LAB5604/fpga_board/e4fpm7k325_mmb/pinout/SoMtoMB_pin.md

## 普通单端IO
|SoM pin|MB pin|
|--|--|
|gpio_g0[0]|cd_pr[0]|
|gpio_g0[1]|cd_pr[1]|
|gpio_g0[2]|cd_od[0]|
|gpio_g0[3]|cd_od[1]|
|gpio_g0[4]|cd_od[2]|
|gpio_g0[5]|cd_os[0]|
|gpio_g0[6]|cd_os[1]|
|gpio_g0[7]|adc_m[1]|
|gpio_g0[8]|sd_cd|
|gpio_g0[9]|sd_d[1]|
|gpio_g0[10]|sd_d[0]|
|gpio_g0[11]|sd_clk|
|gpio_g0[12]|sd_cmd|
|gpio_g0[13]|sd_d[3]|
|gpio_g0[14]|sd_d[2]|
|gpio_g0[15]|adc_m[0]|
|gpio_g0[16]|gpio_g0[16]|
|gpio_g0[17]|gpio_g0[15]|
|gpio_g0[18]|gpio_g0[14]|
|gpio_g0[19]|gpio_g0[13]|
|gpio_g0[20]|gpio_g0[12]|
|gpio_g0[21]|gpio_g0[11]|
|gpio_g0[22]|gpio_g0[10]|
|gpio_g0[23]|gpio_g0[9]|
|gpio_g0[24]|gpio_g1[0]|
|gpio_g0[25]|gpio_g1[1]|
|gpio_g0[26]|gpio_g1[2]|
|gpio_g0[27]|gpio_g1[3]|
|gpio_g0[28]|gpio_g1[4]|
|gpio_g0[29]|gpio_g1[5]|
|gpio_g0[30]|gpio_g1[6]|
|gpio_g0[31]|gpio_g1[7]|
|gpio_g0[32]|gpio_g0[8]|
|gpio_g0[33]|gpio_g0[7]|
|gpio_g0[34]|gpio_g0[6]|
|gpio_g0[35]|gpio_g0[5]|
|gpio_g0[36]|gpio_g0[4]|
|gpio_g0[37]|gpio_g0[3]|
|gpio_g0[38]|gpio_g0[2]|
|gpio_g0[39]|gpio_g0[1]|
|gpio_g0[40]|gpio_g0[0]|
|gpio_g0[41]|gpio_g1[16]|
|gpio_g0[42]|gpio_g1[15]|
|gpio_g0[43]|gpio_g1[14]|
|gpio_g0[44]|gpio_g1[13]|
|gpio_g0[45]|gpio_g1[12]|
|gpio_g0[46]|gpio_g1[11]|
|gpio_g0[47]|gpio_g1[10]|
|gpio_g0[48]|gpio_g1[9]|
|gpio_g0[49]|gpio_g1[8]|
|gpio_g1[0]|vga_vs|
|gpio_g1[1]|vga_hs|
|gpio_g1[2]|vga_blank|
|gpio_g1[3]|vga_psave|
|gpio_g1[4]|vga_sync|
|gpio_g1[5]|fpga_uart_txd|
|gpio_g1[6]|fpga_uart_rxd|
|gpio_g1[7]|rtc_scl|
|gpio_g1[8]|vga_r[0]|
|gpio_g1[9]|vga_r[1]|
|gpio_g1[10]|vga_r[2]|
|gpio_g1[11]|vga_r[3]|
|gpio_g1[12]|vga_r[4]|
|gpio_g1[13]|vga_r[5]|
|gpio_g1[14]|vga_r[6]|
|gpio_g1[15]|vga_r[7]|
|gpio_g1[16]|pcie_wake#|
|gpio_g1[17]|pcie_perst#|
|gpio_g1[18]|cd_rstn|
|gpio_g1[19]|rtc_sda|
|gpio_g1[20]|ps2_clk1|
|gpio_g1[21]|ps2_data1|
|gpio_g1[22]|ps2_data2|
|gpio_g1[23]|ps2_clk2|
|gpio_g1[24]|vga_g[0]|
|gpio_g1[25]|vga_g[1]|
|gpio_g1[26]|vga_g[2]|
|gpio_g1[27]|vga_g[3]|
|gpio_g1[28]|vga_g[4]|
|gpio_g1[29]|vga_g[5]|
|gpio_g1[30]|vga_g[6]|
|gpio_g1[31]|vga_g[7]|
|gpio_g1[32]|mclk_dac|
|gpio_g1[33]|sdin_dac|
|gpio_g1[34]|lrck_dac|
|gpio_g1[35]|sclk_dac|
|gpio_g1[36]|mclk_adc|
|gpio_g1[37]|sdout_adc|
|gpio_g1[38]|sclk_adc|
|gpio_g1[39]|lrck_adc|
|gpio_g1[40]|adc_rst#|
|gpio_g1[41]|vga_b[0]|
|gpio_g1[42]|vga_b[1]|
|gpio_g1[43]|vga_b[2]|
|gpio_g1[44]|vga_b[3]|
|gpio_g1[45]|vga_b[4]|
|gpio_g1[46]|vga_b[5]|
|gpio_g1[47]|vga_b[6]|
|gpio_g1[48]|vga_b[7]|
|gpio_g1[49]|vga_clk|
## SoM差分IO
|SoM pin|MB pin|
|--|--|
|gpio_diff0_p|key3|
|gpio_diff0_n|key2|
|gpio_diff1_p|key7|
|gpio_diff1_n|key6|
|gpio_diff2_p|key1|
|gpio_diff2_n|key0|
|gpio_diff3_p|key5|
|gpio_diff3_n|key4|
|gpio_diff4_p|but5|
|gpio_diff4_n|but1|
|gpio_diff5_p|but4|
|gpio_diff5_n|but0|
|gpio_diff6_p|but7|
|gpio_diff6_n|but3|
|gpio_diff7_p|but6|
|gpio_diff7_n|but2|
|gpio_diff8_p|led0|
|gpio_diff8_n|led1|
|gpio_diff9_p|led2|
|gpio_diff9_n|led3|
|gpio_diff10_p|led7|
|gpio_diff10_n|led6|
|gpio_diff11_p|led5|
|gpio_diff11_n|led4|
|gpio_diff12_p|seg_c|
|gpio_diff12_n|seg_g|
|gpio_diff13_p|seg_a|
|gpio_diff13_n|seg_f|
|gpio_diff14_p|seg_b|
|gpio_diff14_n|seg_e|
|gpio_diff15_p|seg_d|
|gpio_diff15_n|seg_dp|
|gpio_diff16_p|seg_sel4|
|gpio_diff16_n|seg_sel3|
|gpio_diff17_p|seg_sel2|
|gpio_diff17_n|seg_sel1|
## 专用IO
SoM上专用IO引脚和主板同名IO相连
## GT收发器引脚 
|SoM pin|MB pin|
|--|--|
|mgtxtx0_p|pcie_tx0_p|
|mgtxtx0_n|pcie_tx0_n|
|mgtxrx0_p|pcie_rx0_p|
|mgtxrx0_n|pcie_rx0_n|
|mgtxtx1_p|pcie_tx1_p|
|mgtxtx1_n|pcie_tx1_n|
|mgtxrx1_p|pcie_rx1_p|
|mgtxrx1_n|pcie_rx1_n|
|mgtxtx2_p|pcie_tx2_p|
|mgtxtx2_n|pcie_tx2_n|
|mgtxrx2_p|pcie_rx2_p|
|mgtxrx2_n|pcie_rx2_n|
|mgtxtx3_p|pcie_tx3_p|
|mgtxtx3_n|pcie_tx3_n|
|mgtxrx3_p|pcie_rx3_p|
|mgtxrx3_n|pcie_rx3_n|
|mgtrclk115_p|pcie_refclk_p|
|mgtrclk115_n|pcie_refclk_n|
|mgtxtx4_p|sata_tx1_p|
|mgtxtx4_n|sata_tx1_n|
|mgtxrx4_p|sata_rx1_p|
|mgtxrx4_n|sata_rx1_n|
|mgtxtx5_p|sata_tx2_p|
|mgtxtx5_n|sata_tx2_n|
|mgtxrx5_p|sata_rx2_p|
|mgtxrx5_n|sata_rx2_n|
|mgtxtx6_p|sata_tx3_p|
|mgtxtx6_n|sata_tx3_n|
|mgtxrx6_p|sata_rx3_p|
|mgtxrx6_n|sata_rx3_n|
|mgtxtx7_p|sata_tx4_p|
|mgtxtx7_n|sata_tx4_n|
|mgtxrx7_p|sata_rx4_p|
|mgtxrx7_n|sata_rx4_n|
