LAB5604/fpga_board/e4fpm7k325_mmb/docs/E4FPMK7_676_MB_Schematic_English.pdf

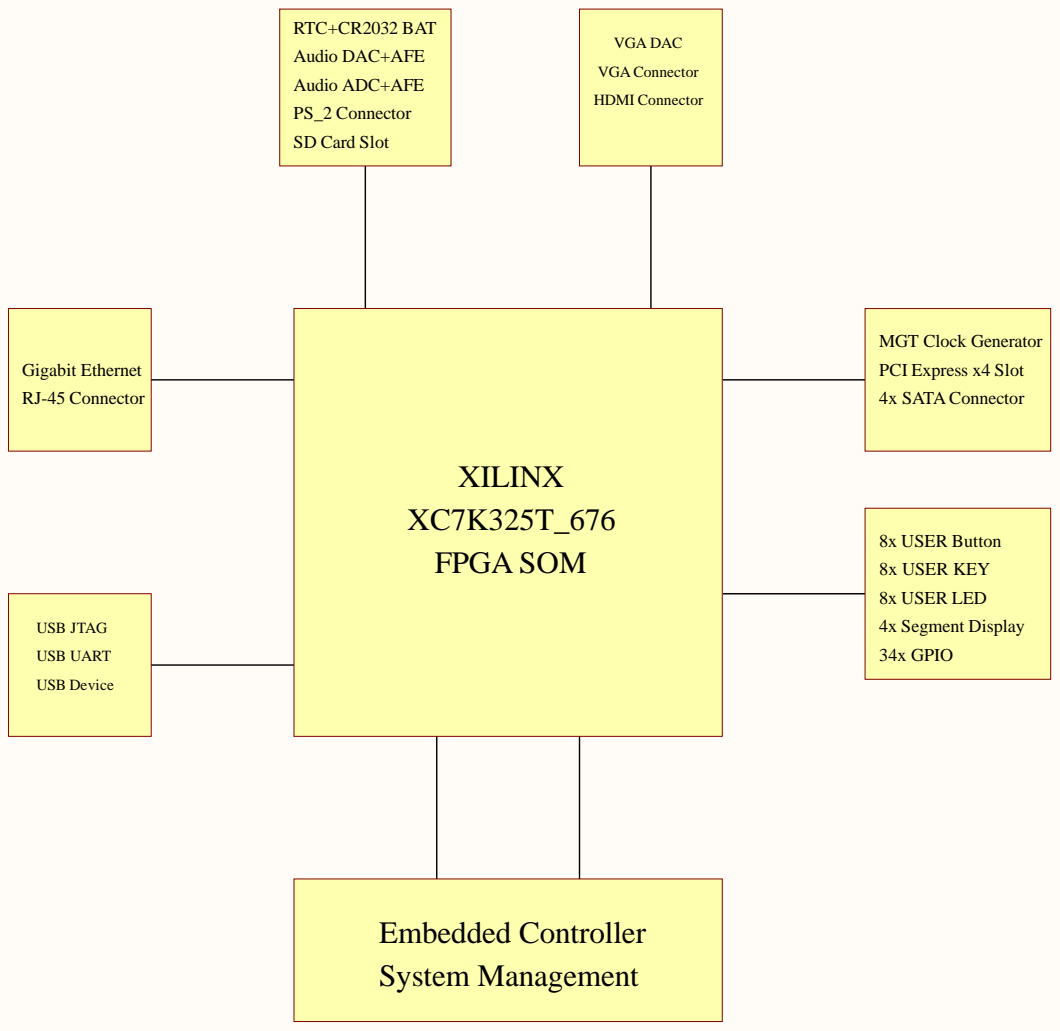
[picture p3: page 1]

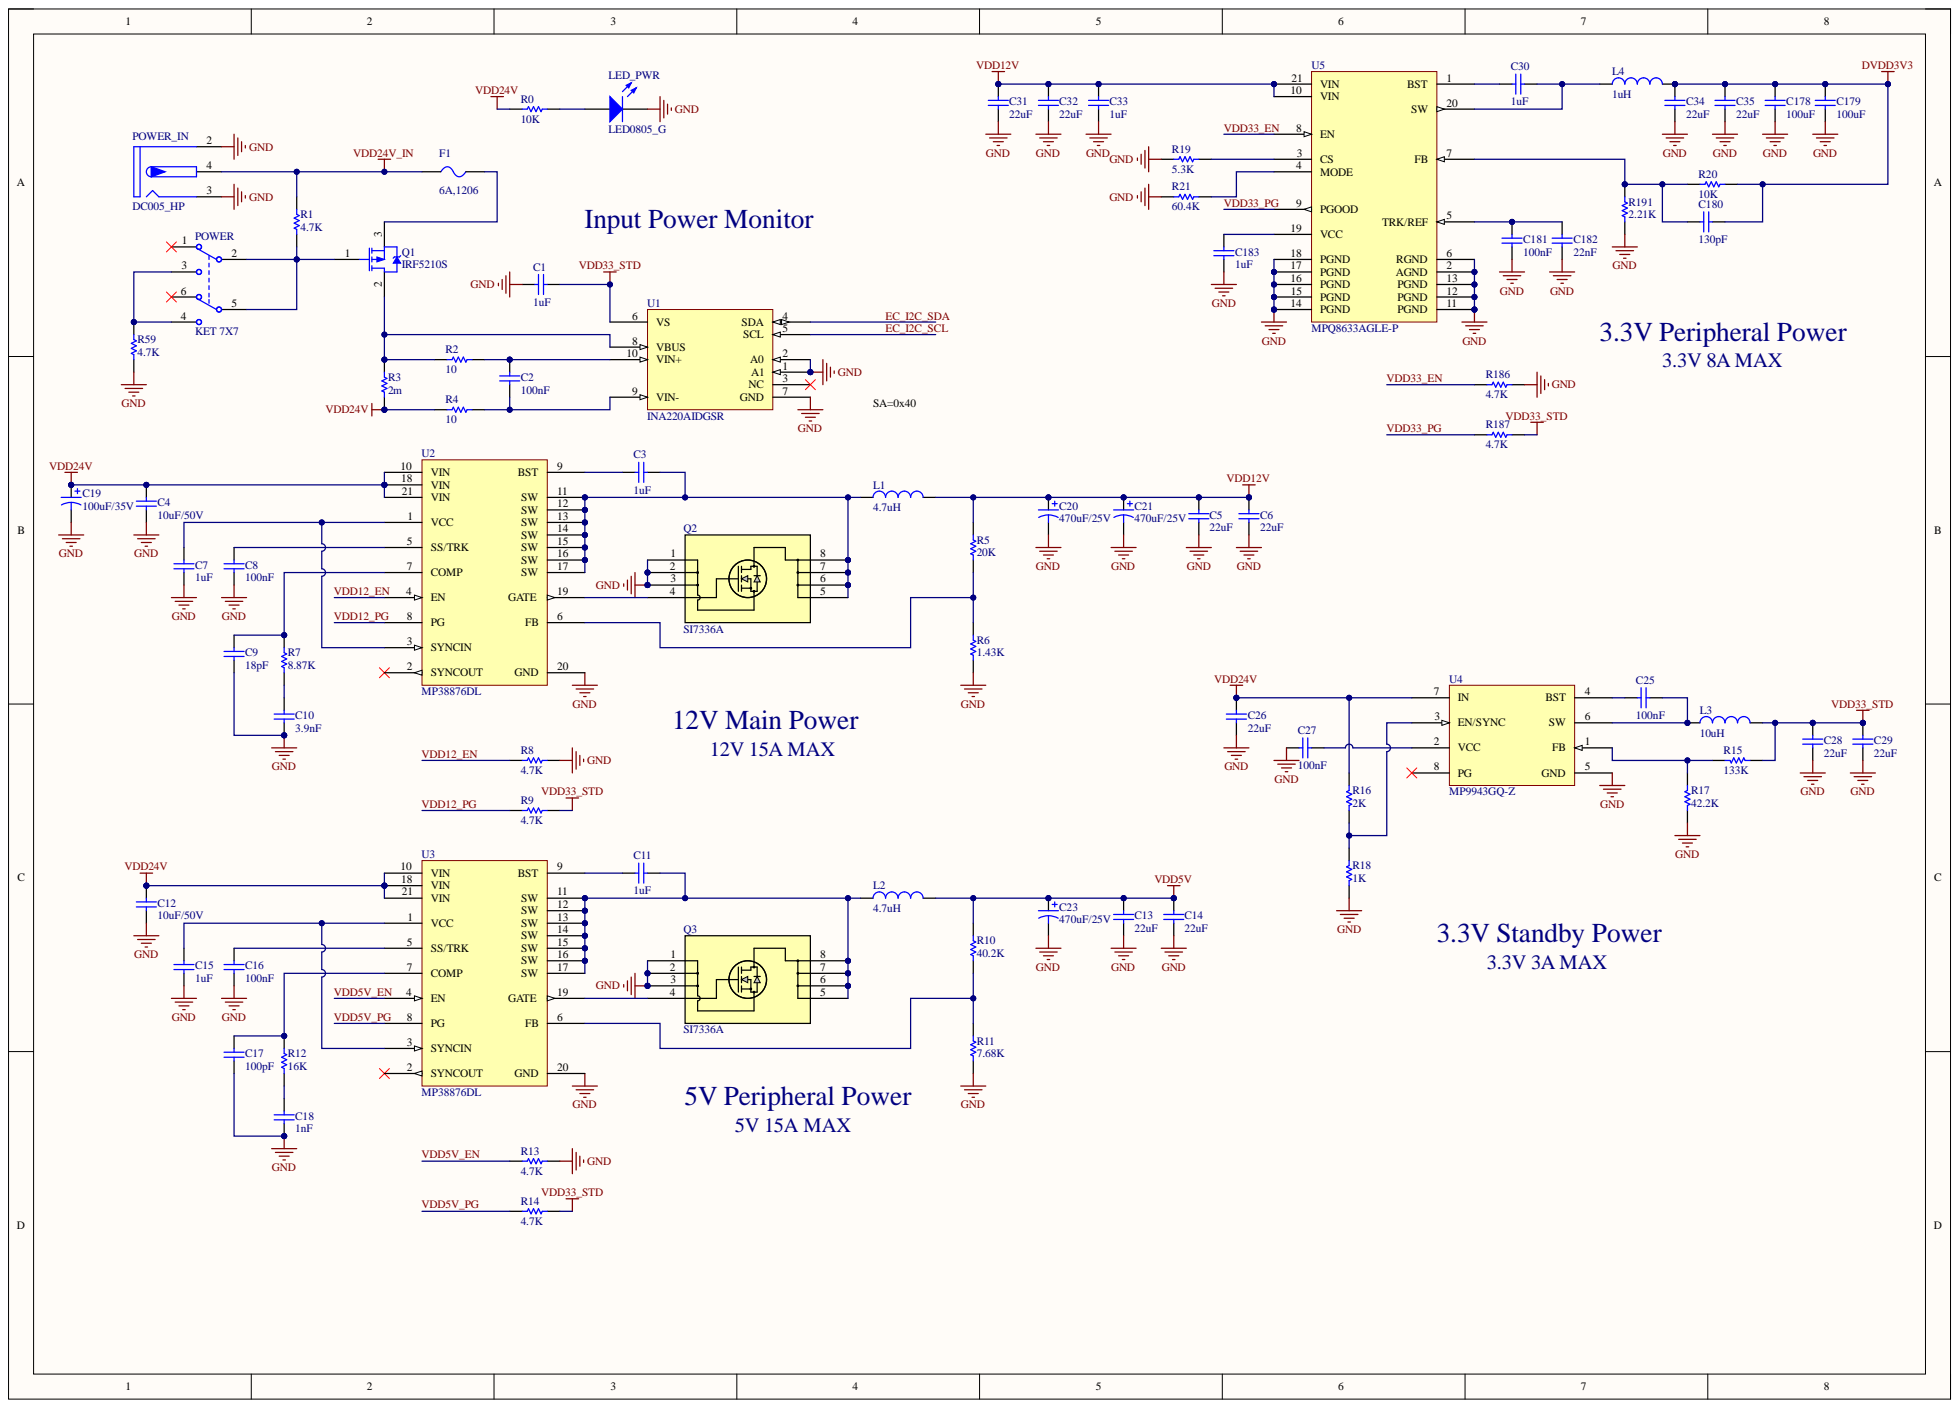
[picture p4: page 2]

MODE 4

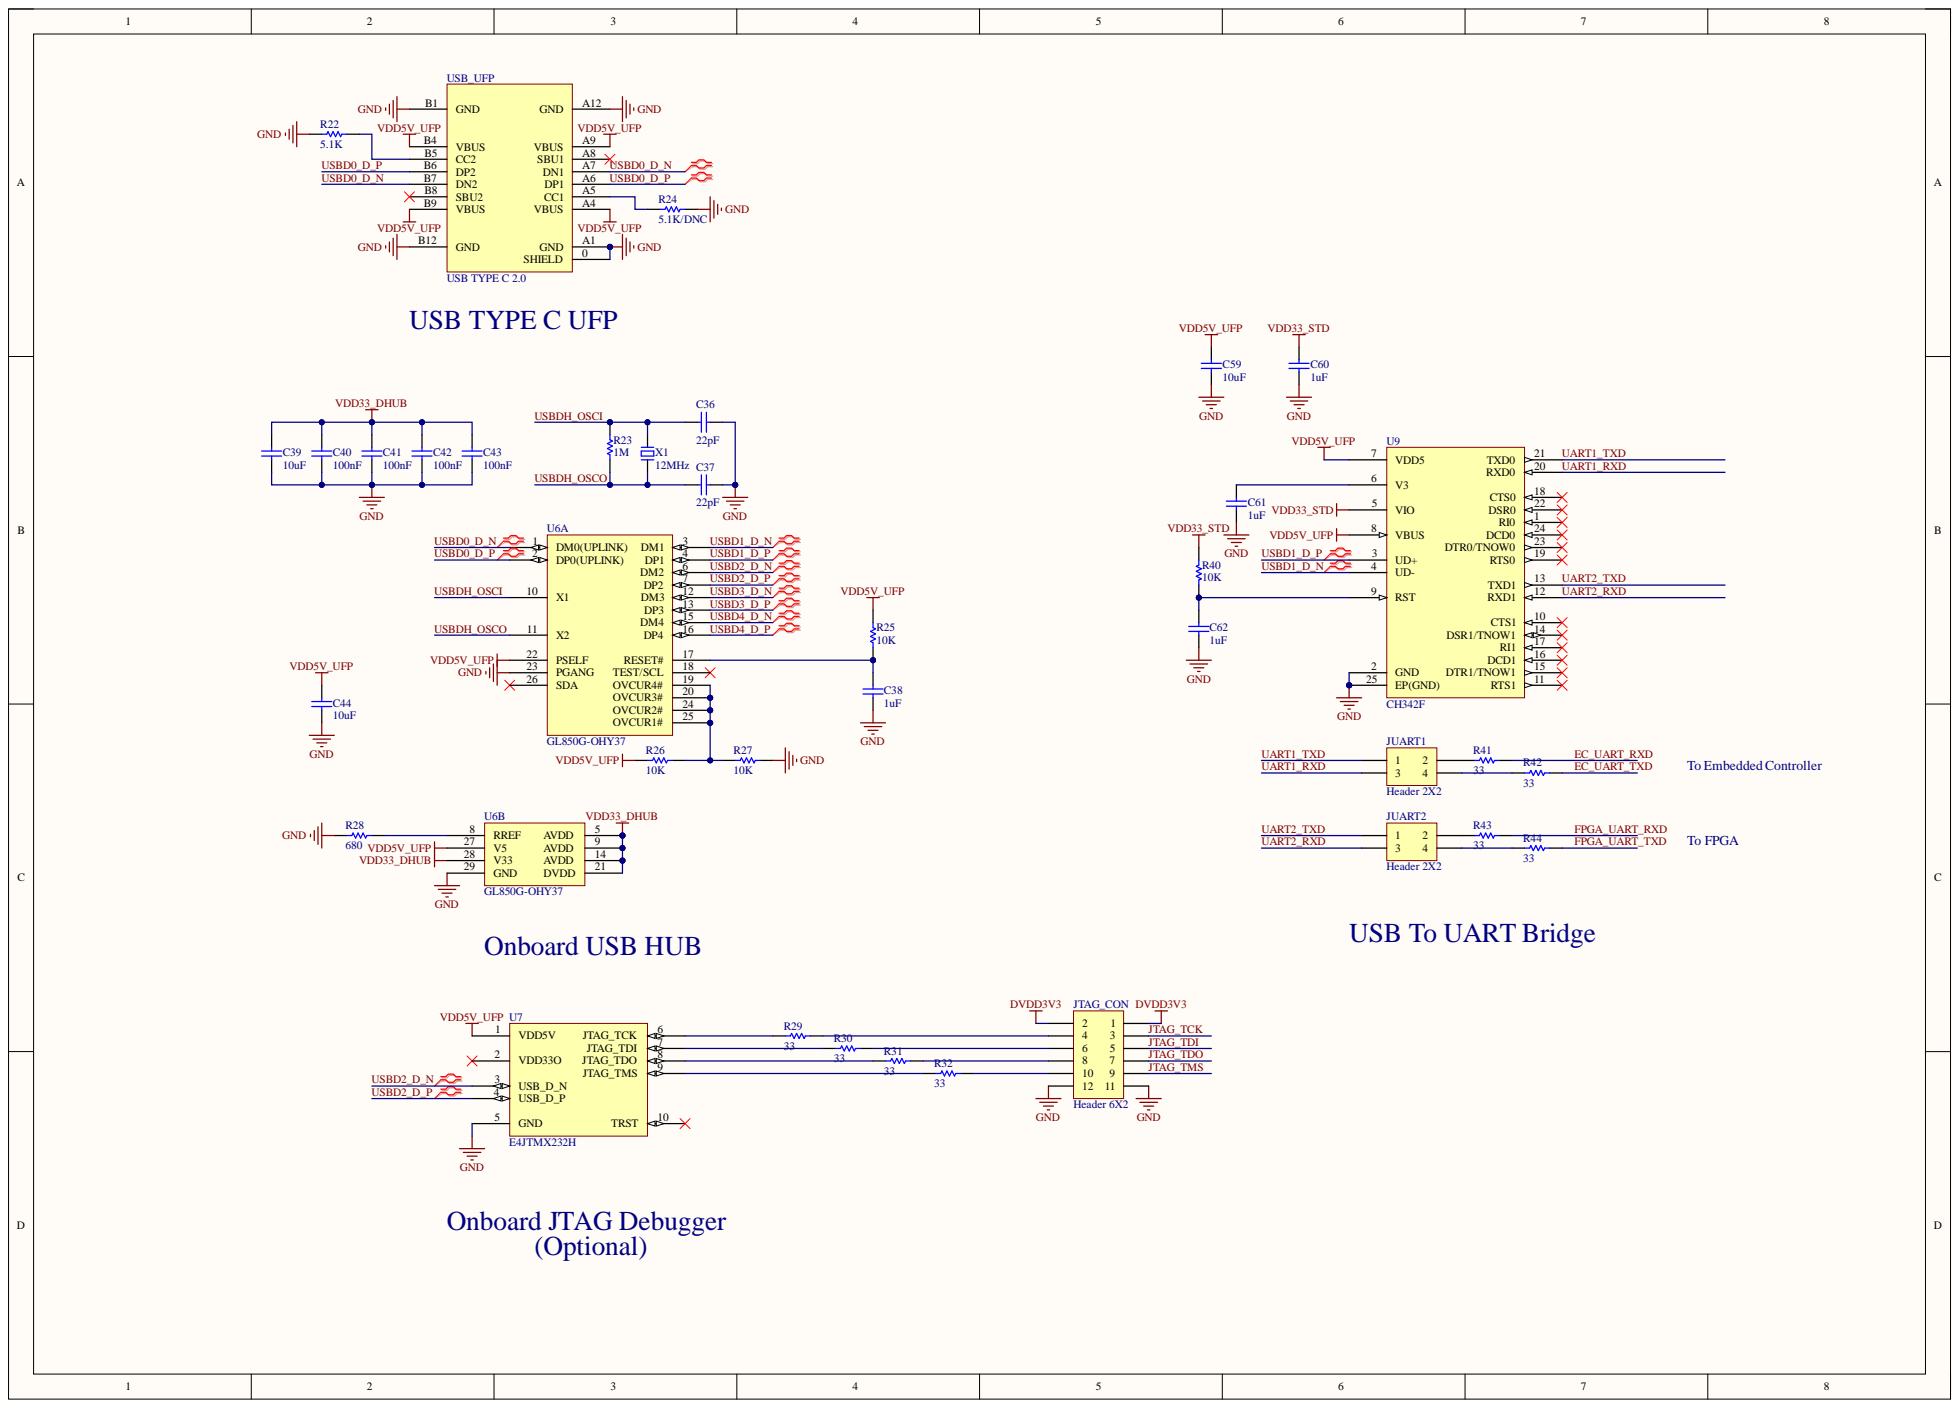
[picture p5: page 3]

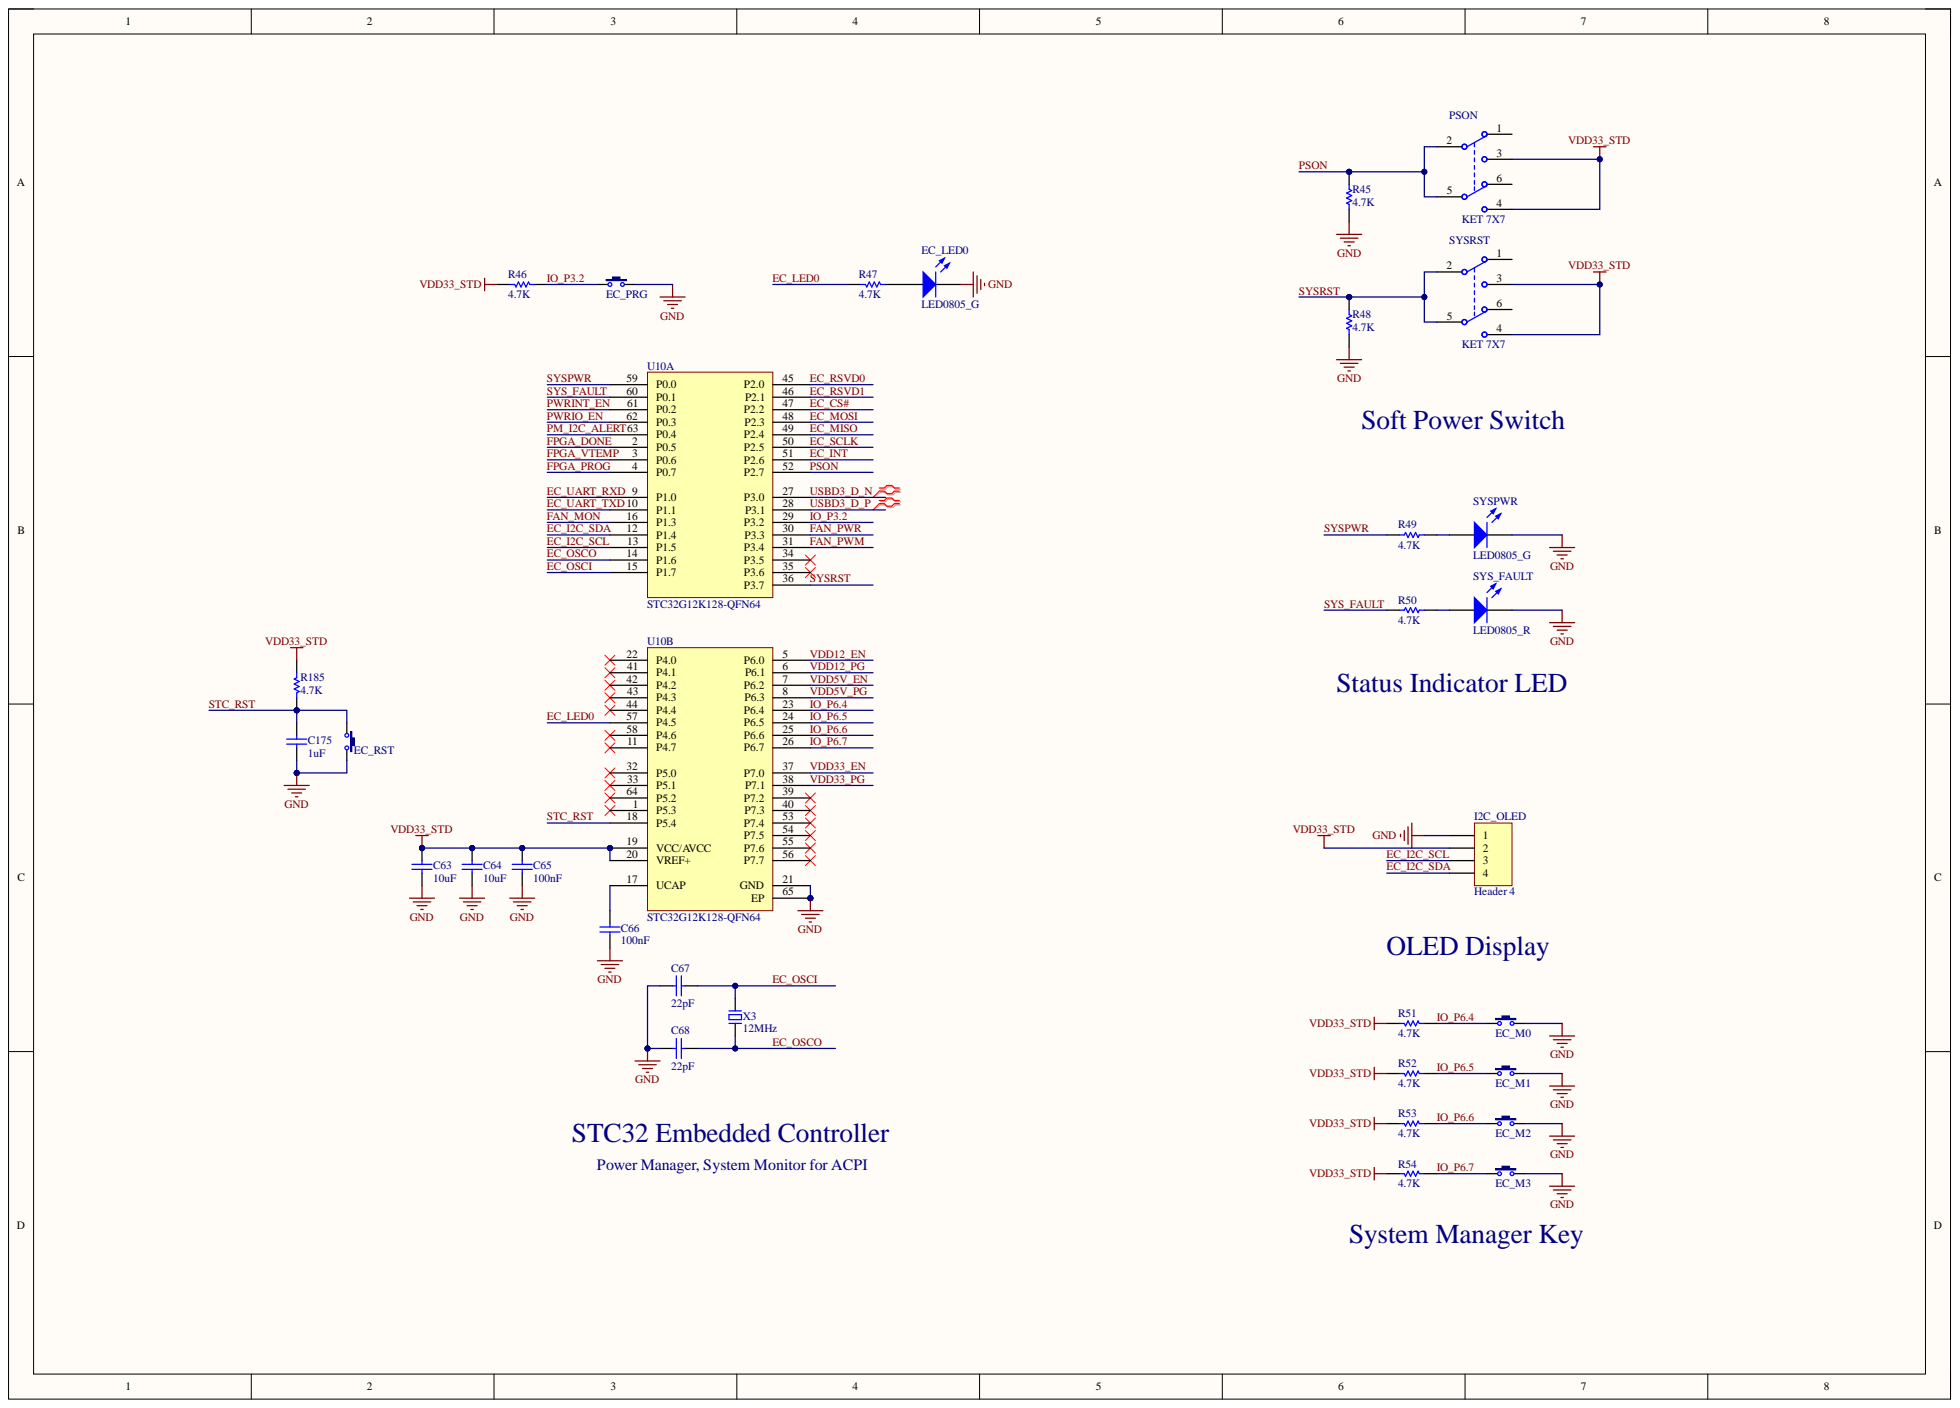
[picture p6: page 4]

STC32 Embedded Controller Power Manager, System Monitor for ACPI

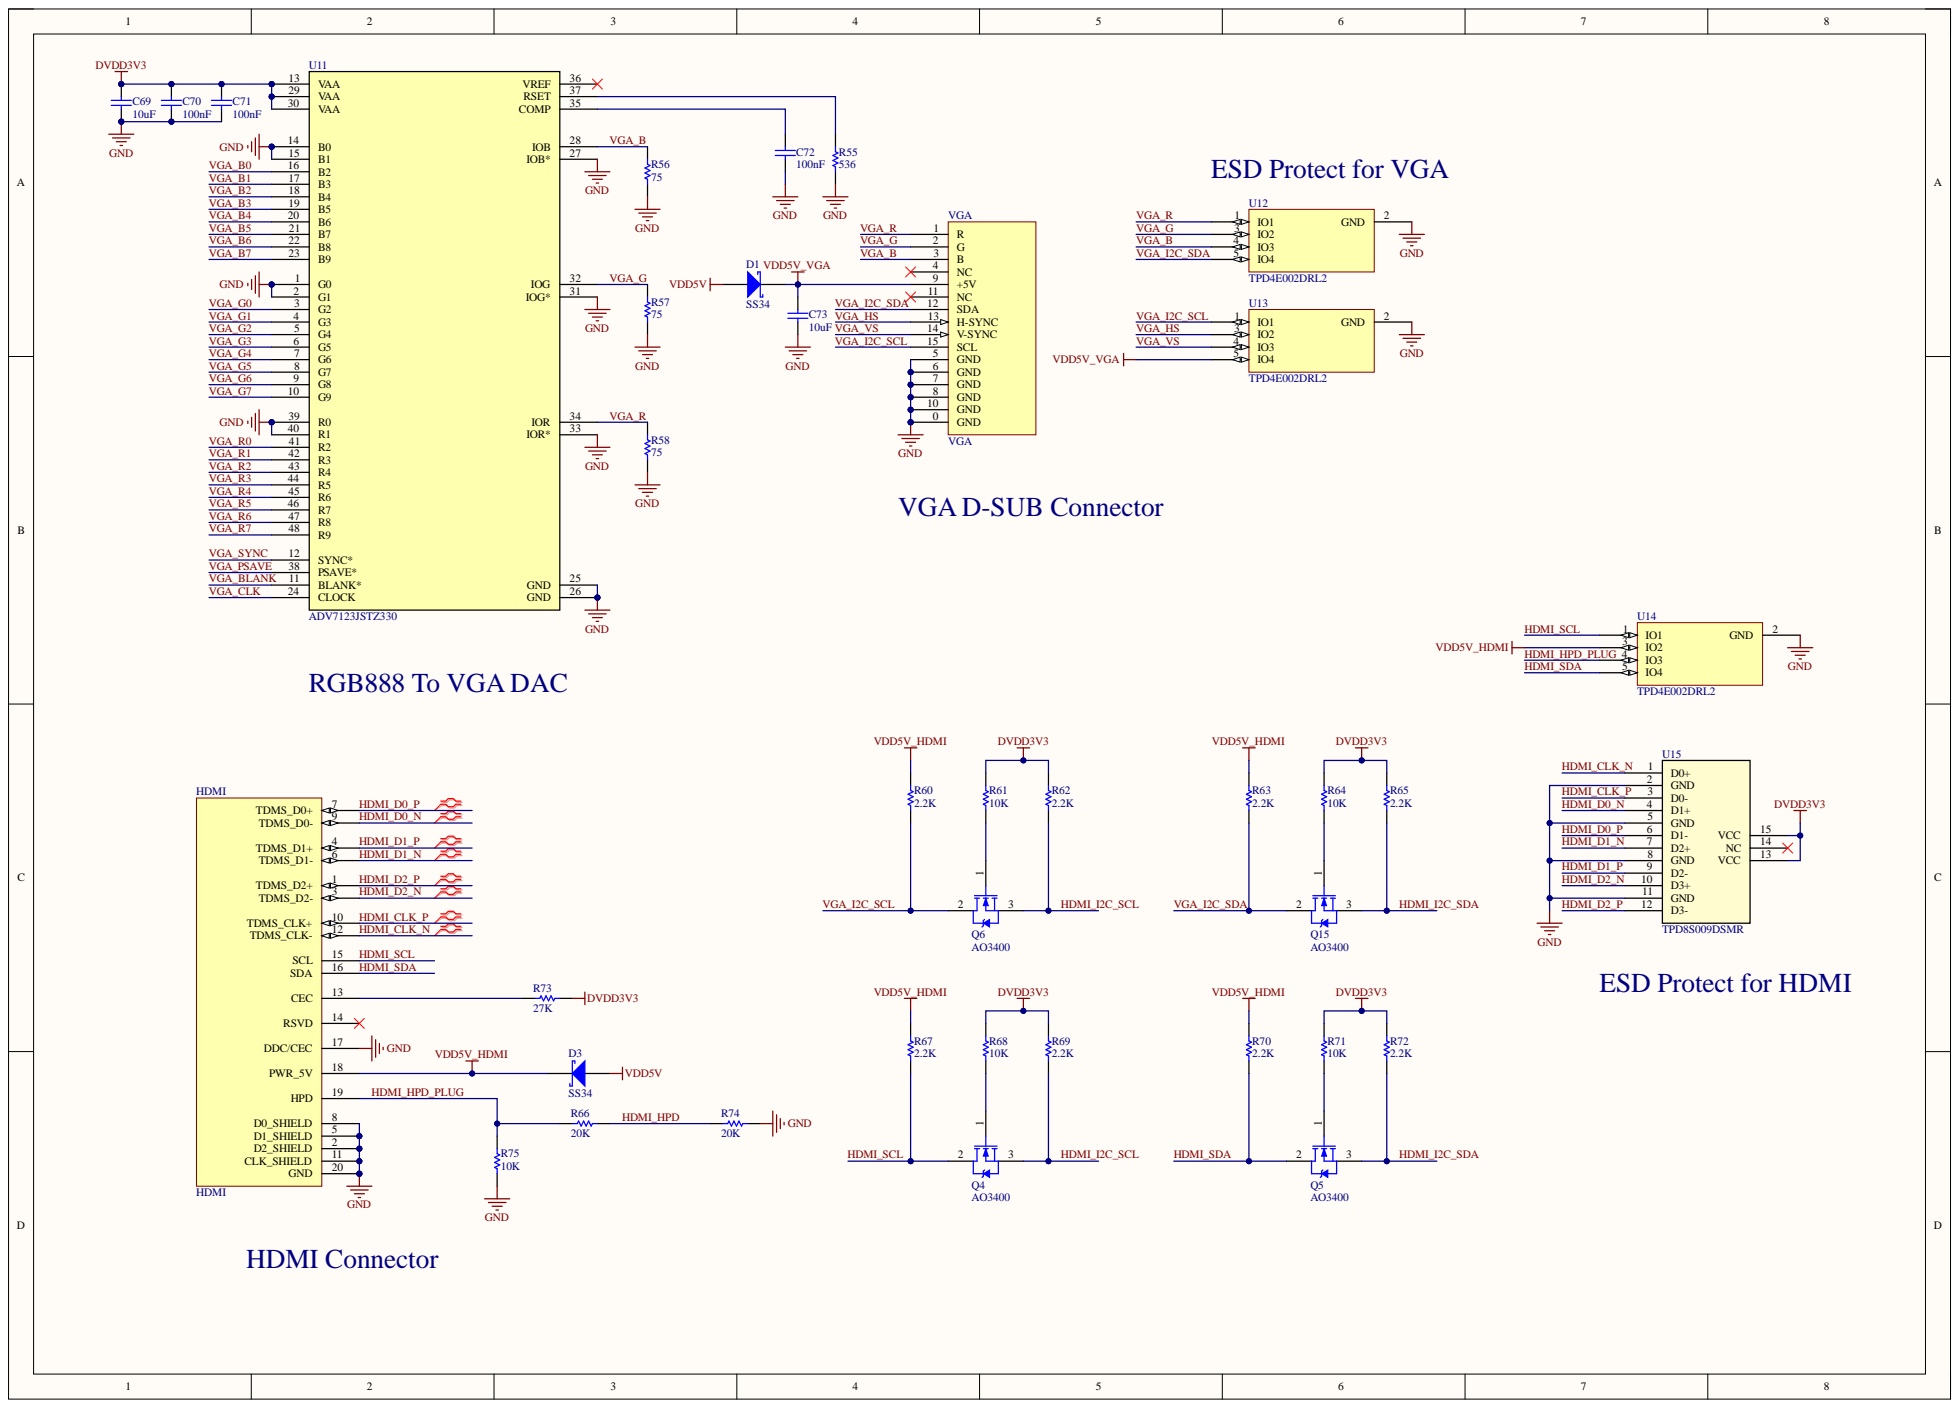
[picture p7: page 5]

ESD Protect for VGA

GND
ESD Protect for HDMI

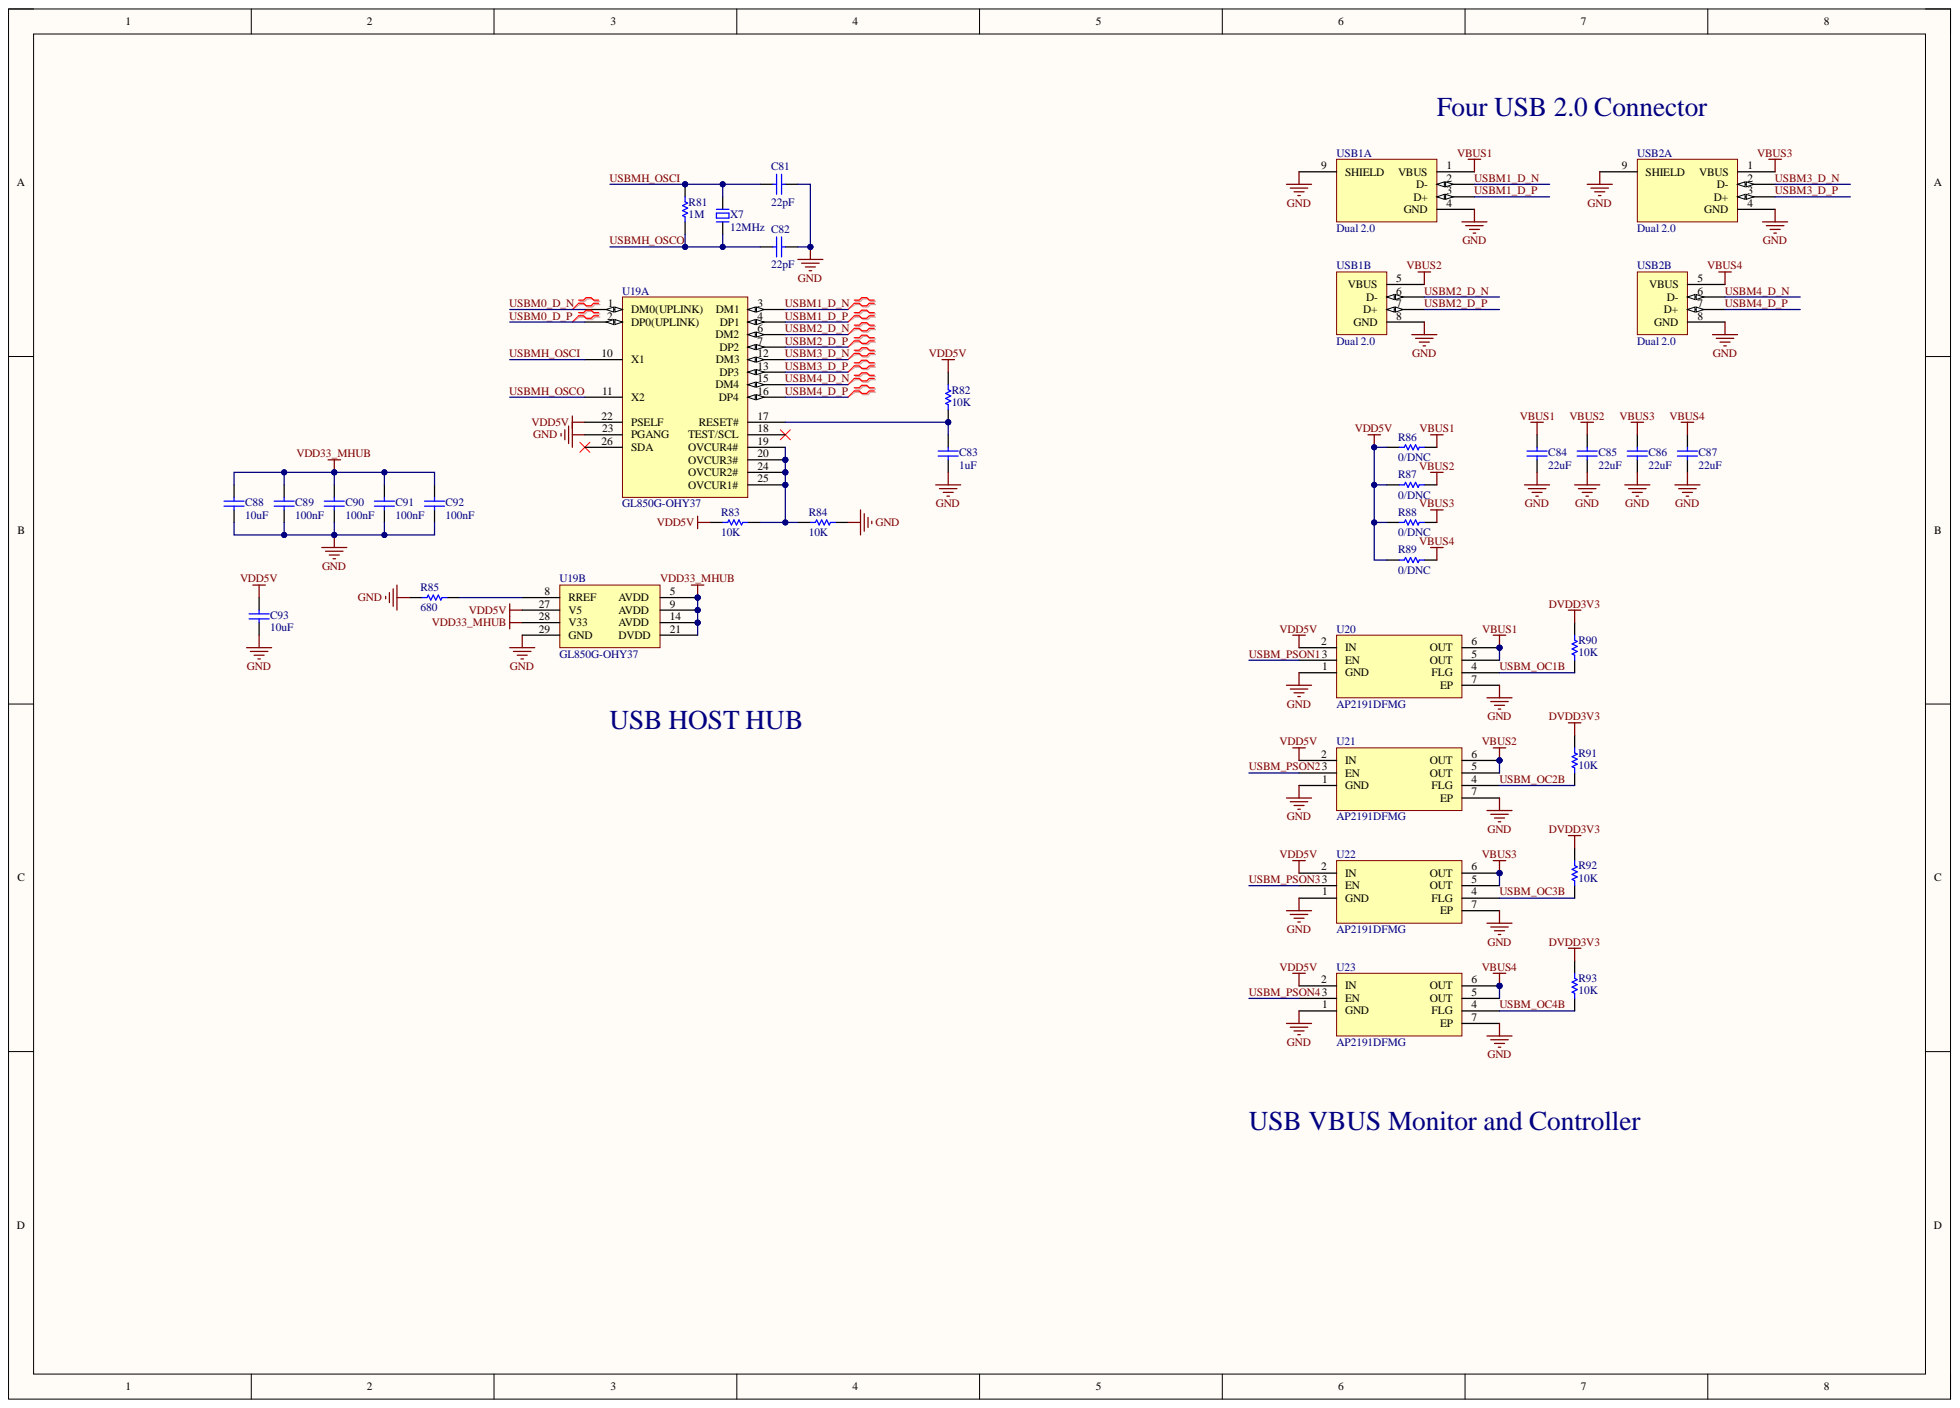
[picture p8: page 6]

USB VBUS Monitor and Controller

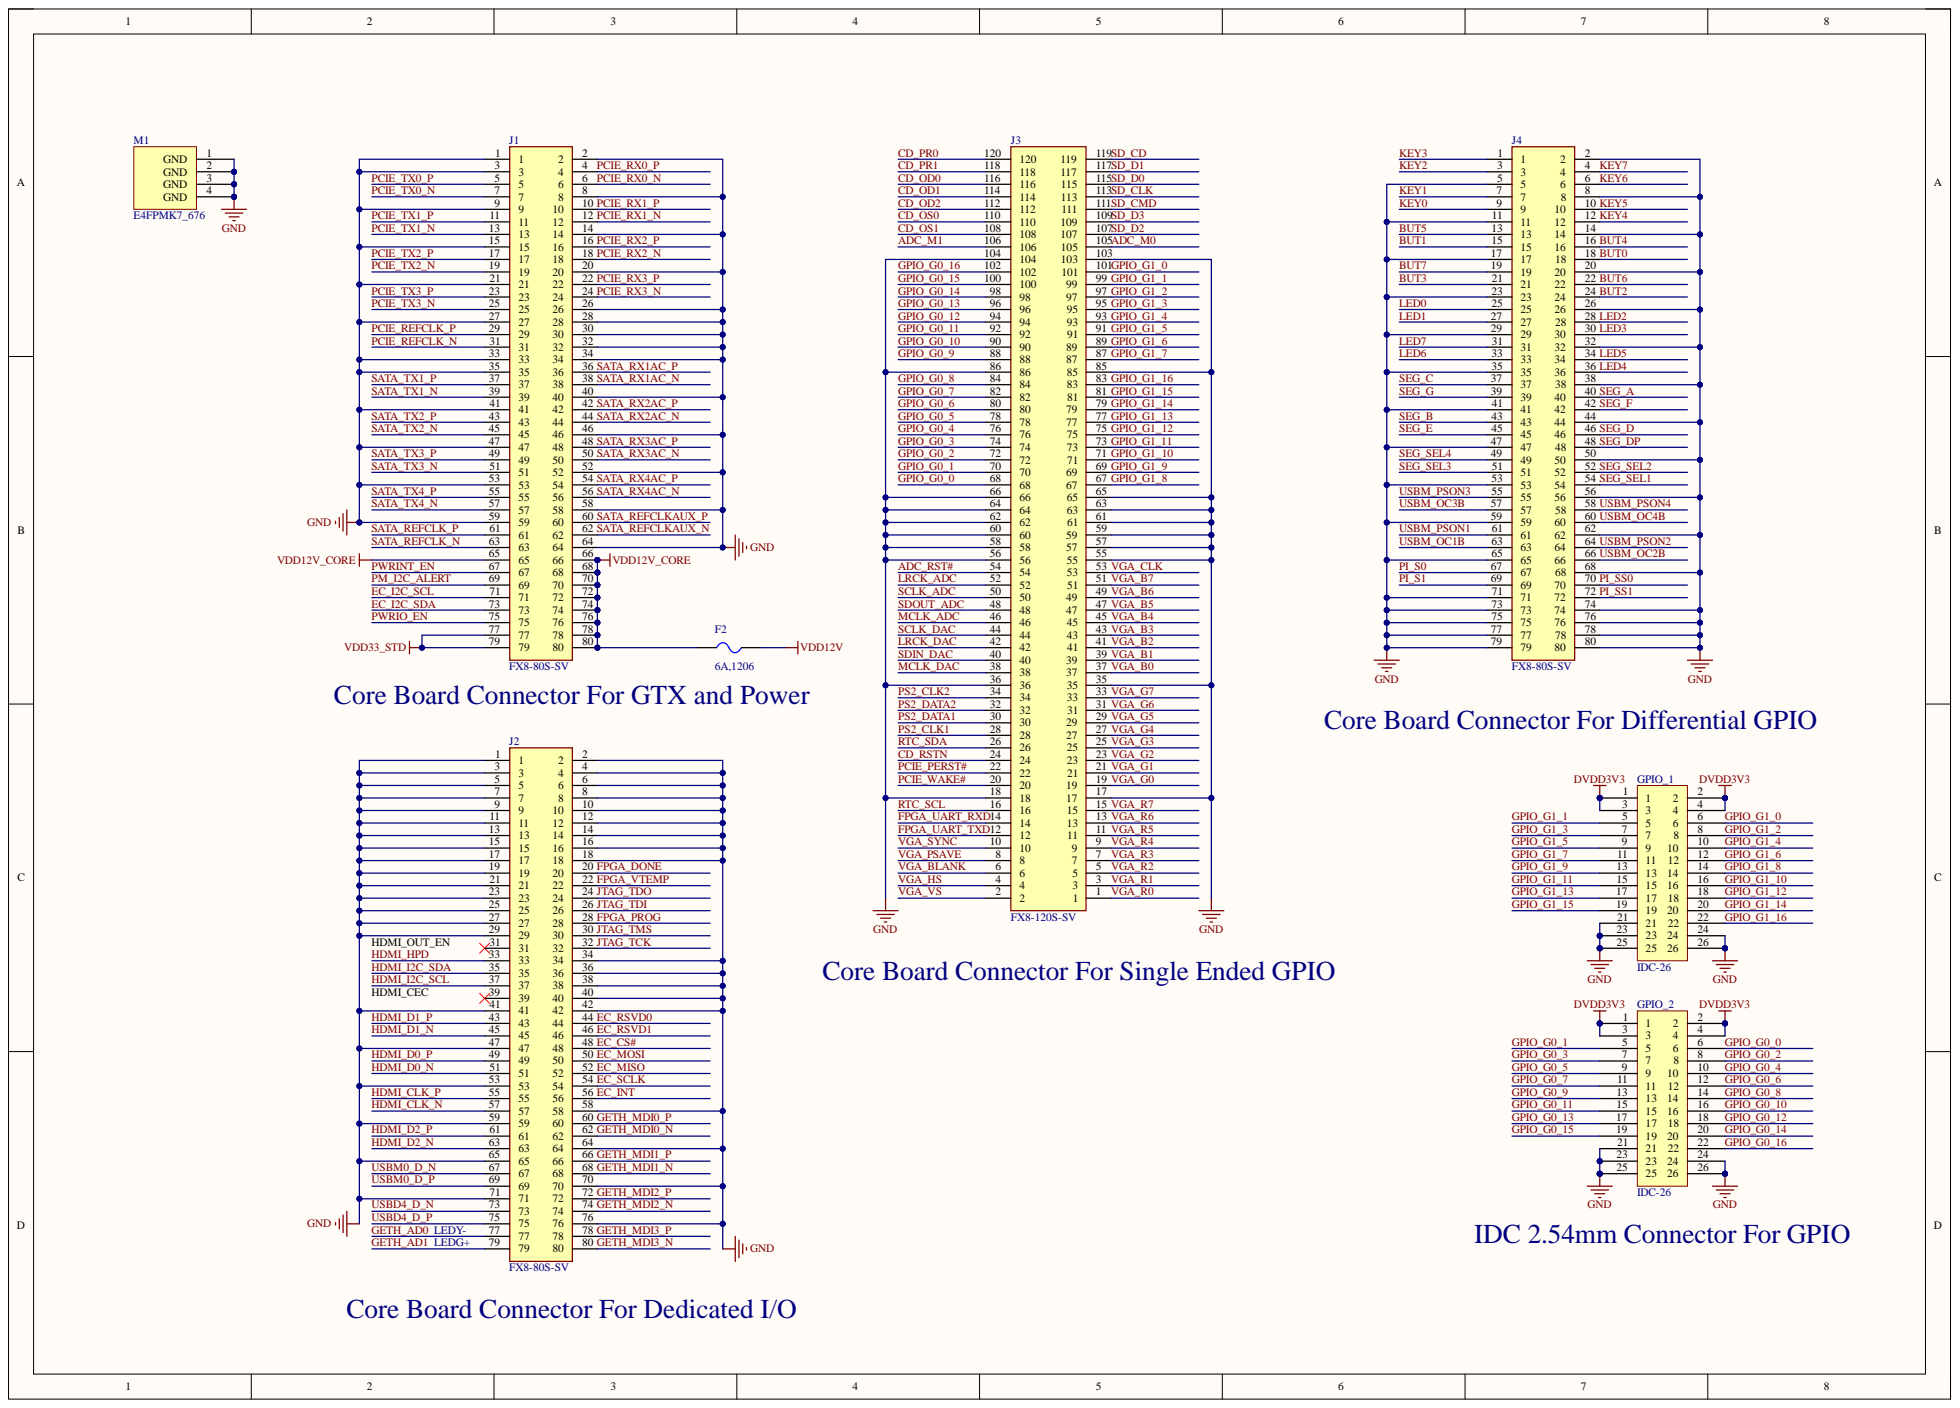
[picture p9: page 7]

Core Board Connector For GTX and Power

PS2_C L K 2 PS2_D ATA 2 PS2_D ATA 1 PS2_C L K 1 RT C_SD A C D_RST N PC IE_PE RST # PC IE_WA KE # | V G A_G 7 V G A_G 6 V G A_G 5 V G A_G 4 V G A_G 3 V G A_G 2 V G A_G 1 V G A_G 0

Core Board Connector For Differential GPIO

Core Board Connector For Single Ended GPIO

Core Board Connector For Dedicated I/O

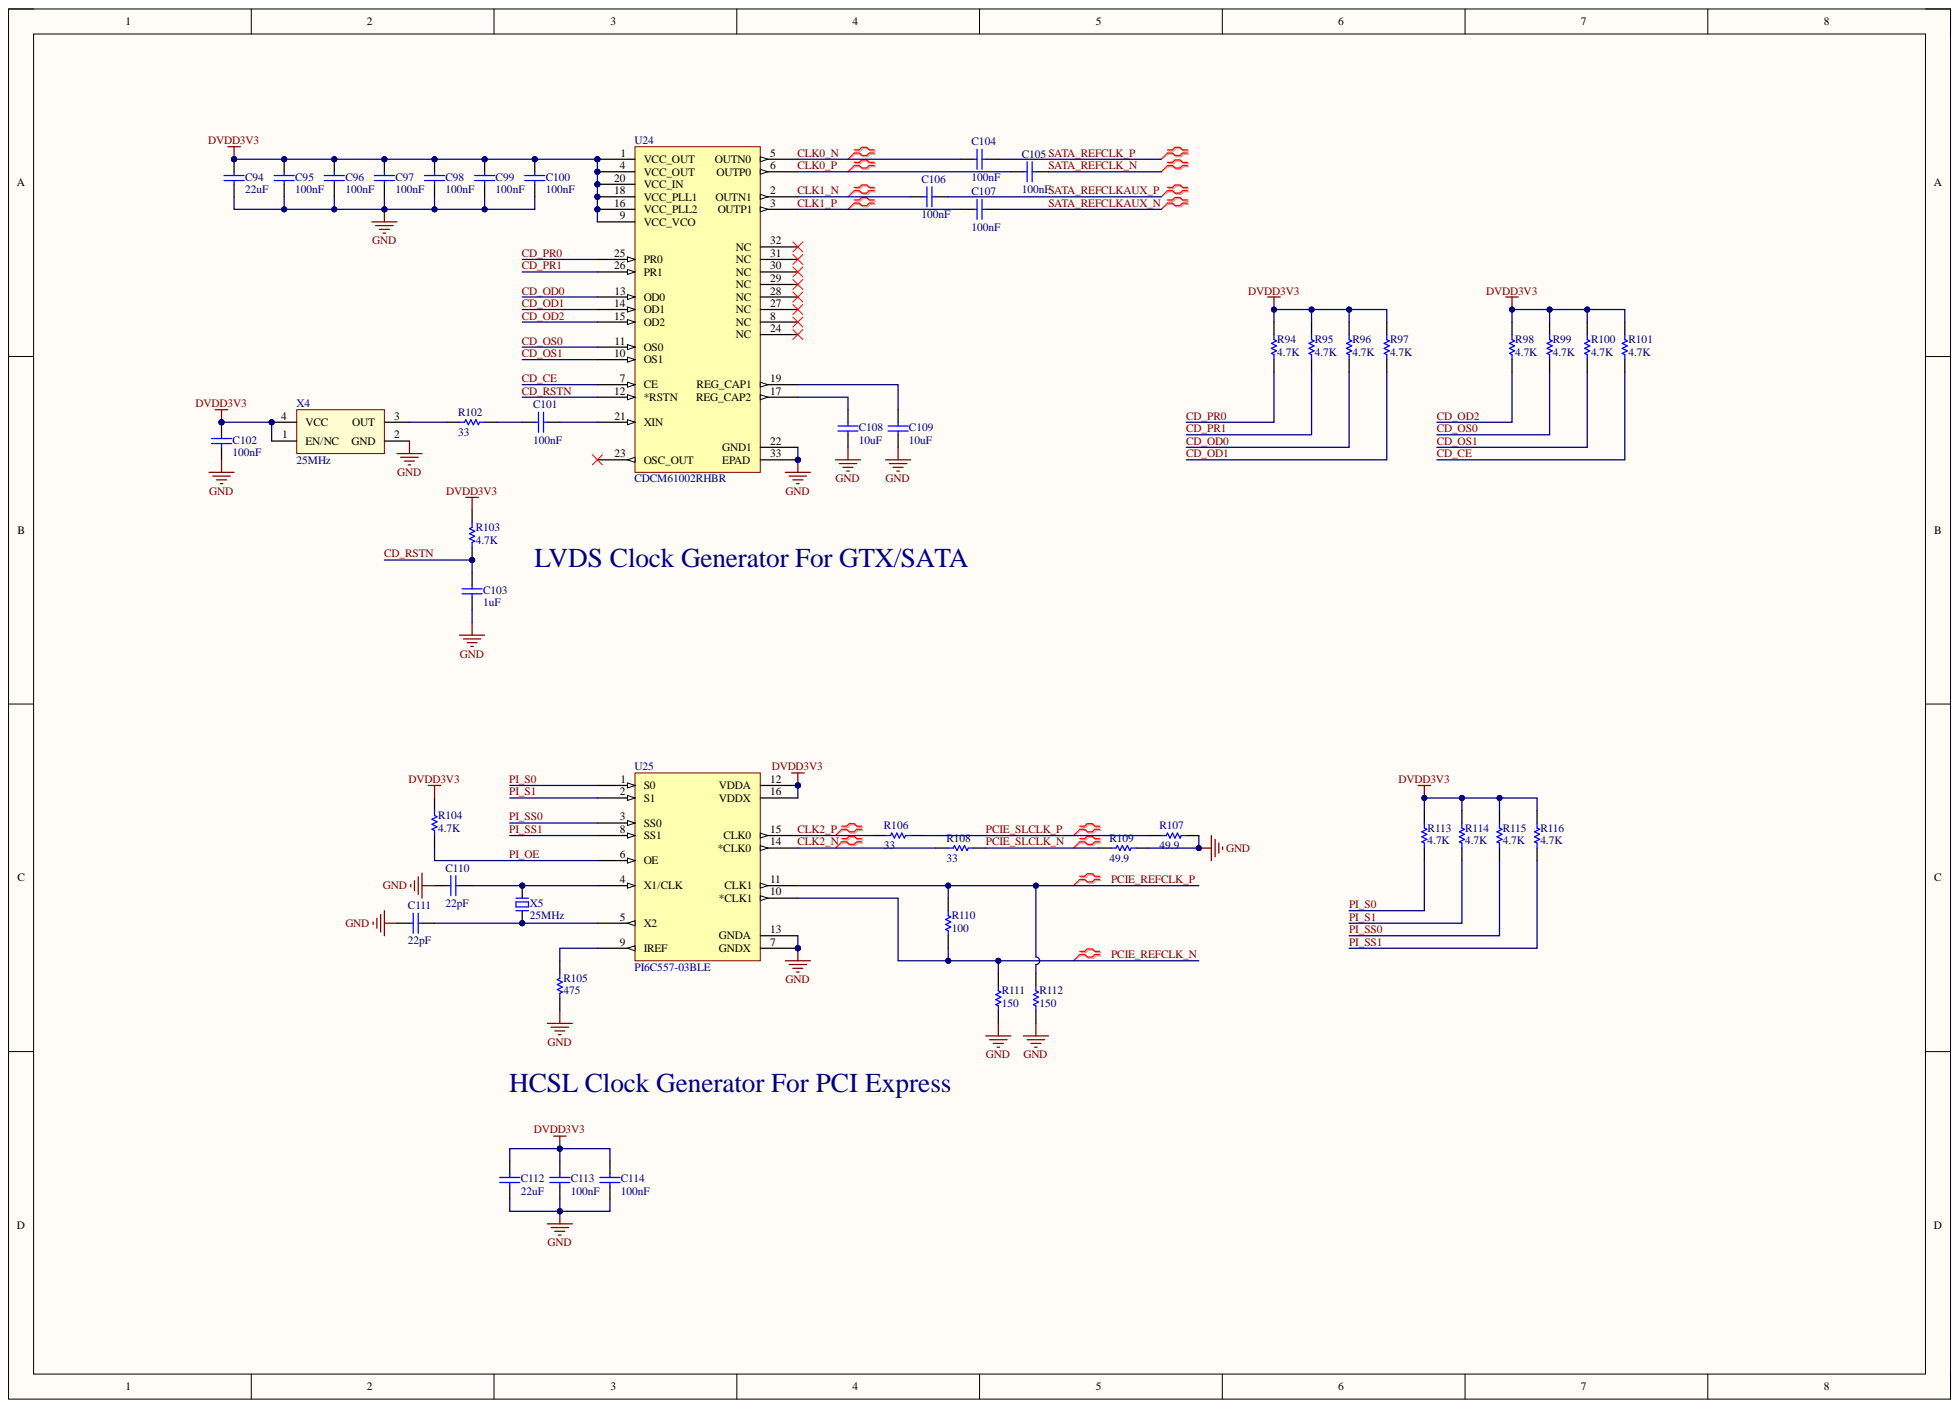
[picture p10: page 8]

LVDS Clock Generator For GTX/SATA

GND
HCSL Clock Generator For PCI Express

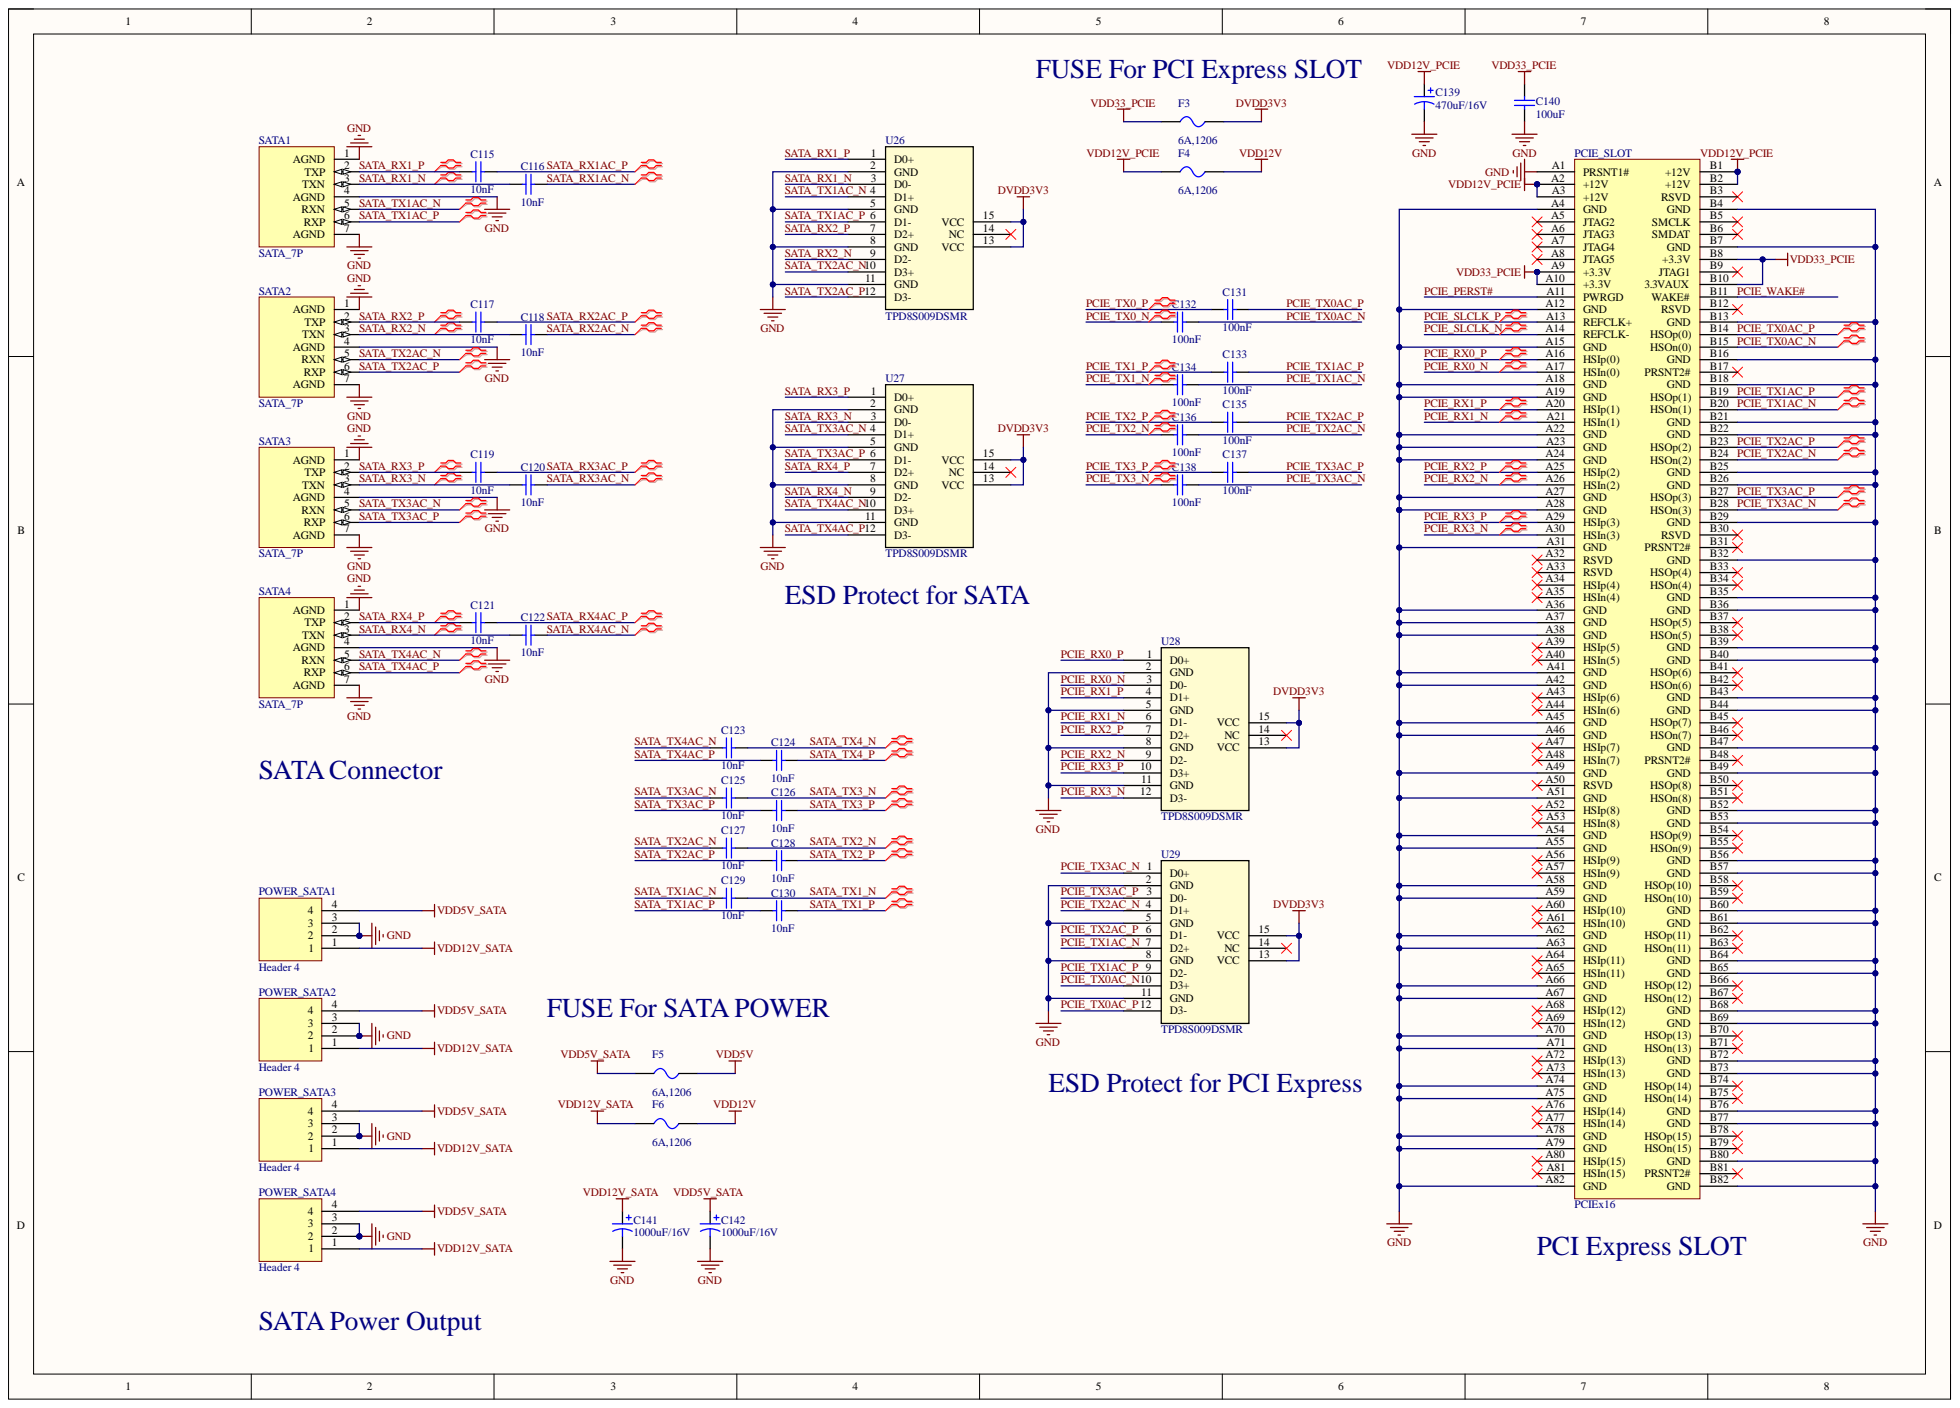
[picture p11: page 9]

FUSE For PCI Express SLOT

GND
ESD Protect for SATA

FUSE For SATA POWER

ESD Protect for PCI Express

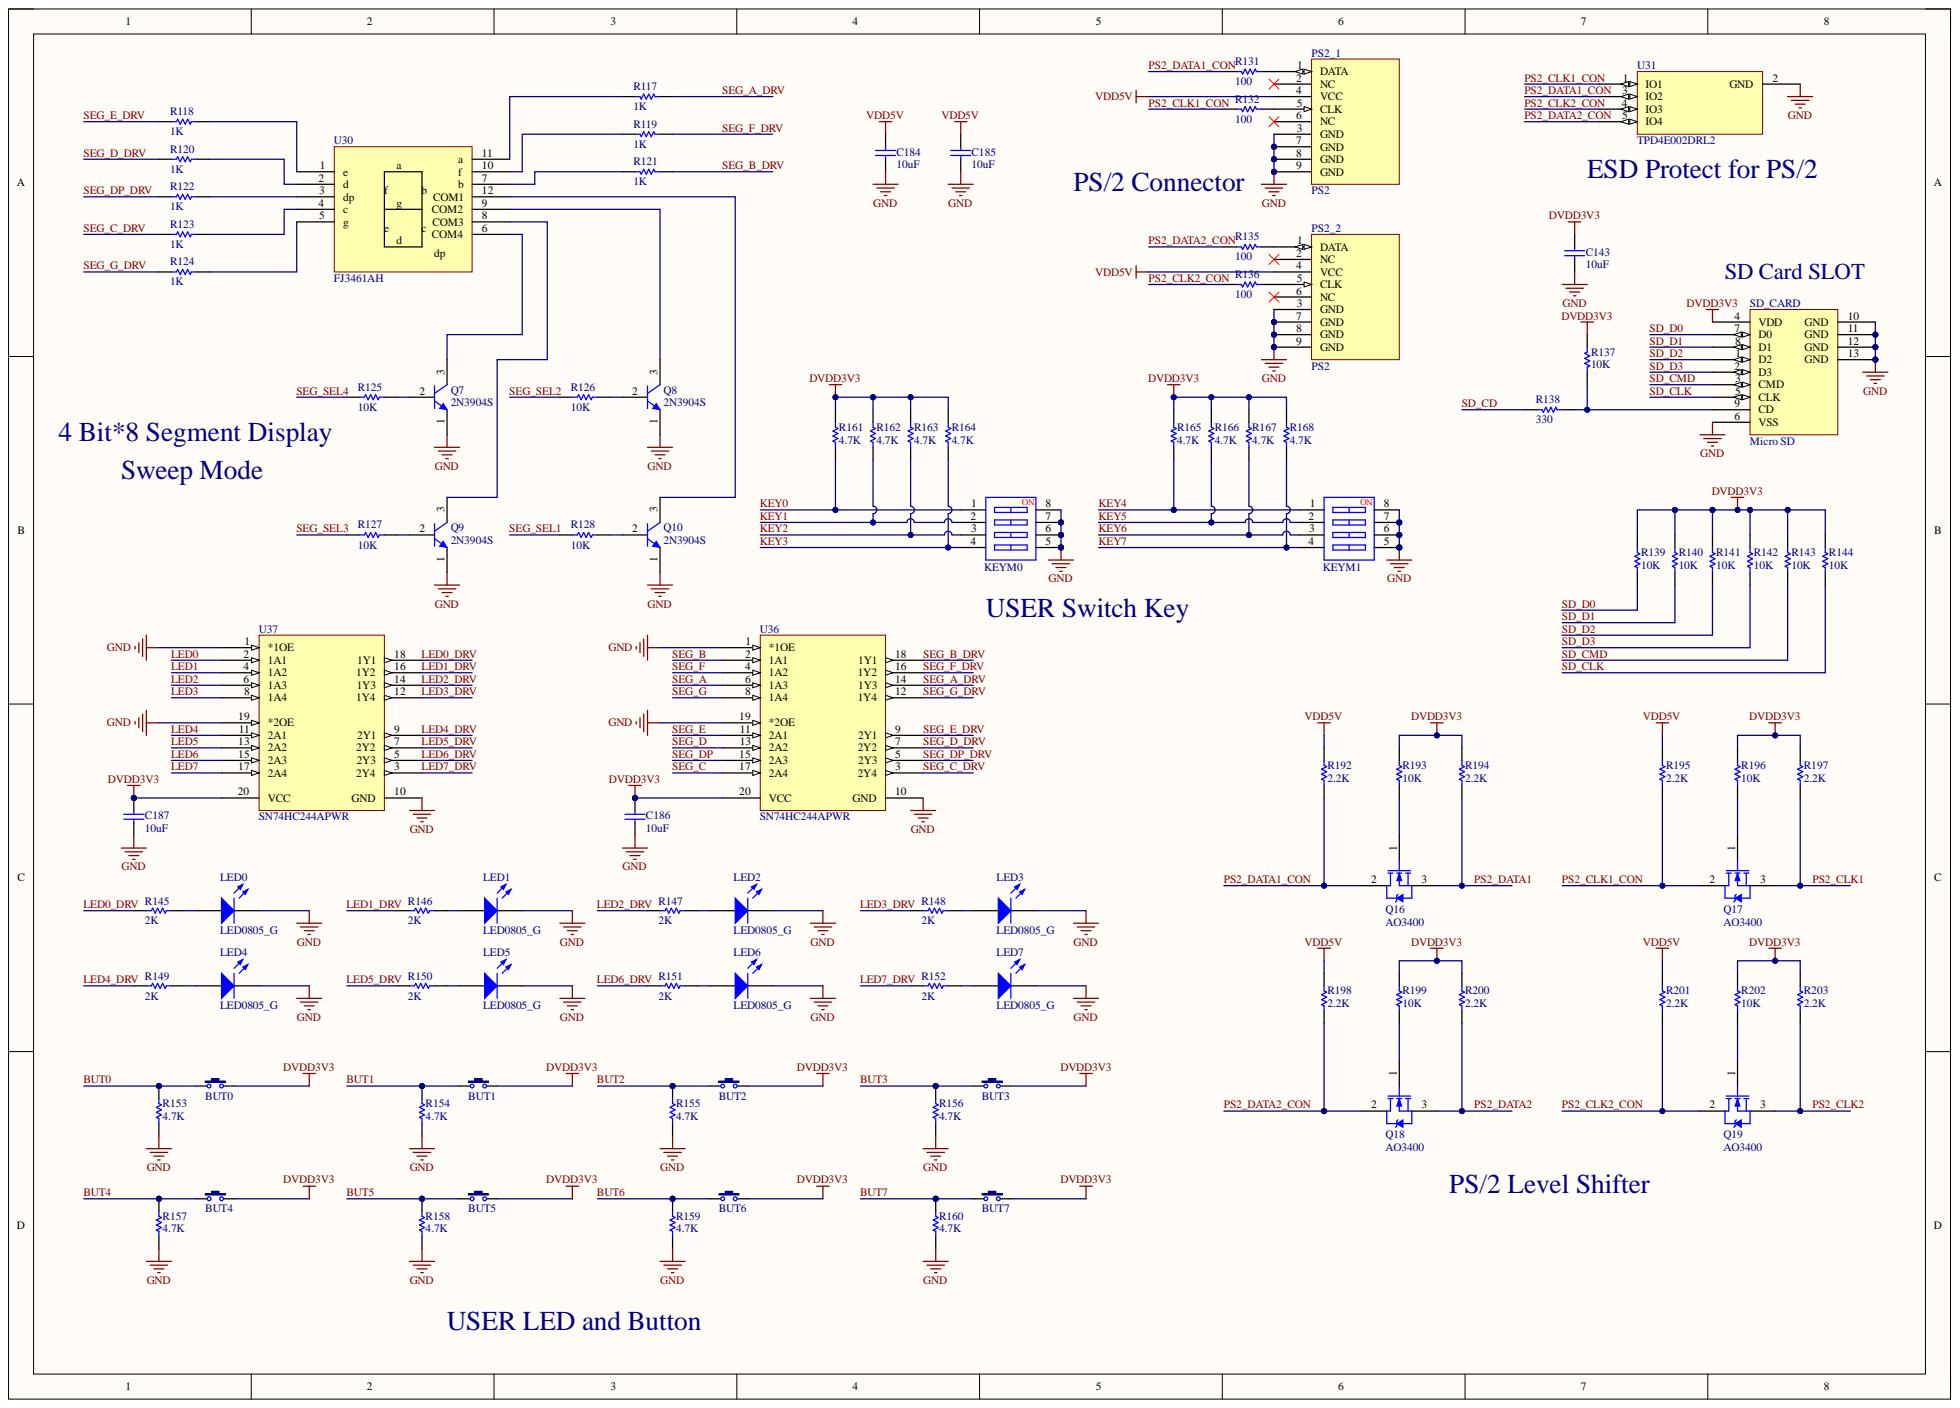
[picture p12: page 10]

TPD4E002DRL2
ESD Protect for PS/2

GND
USER LED and Button

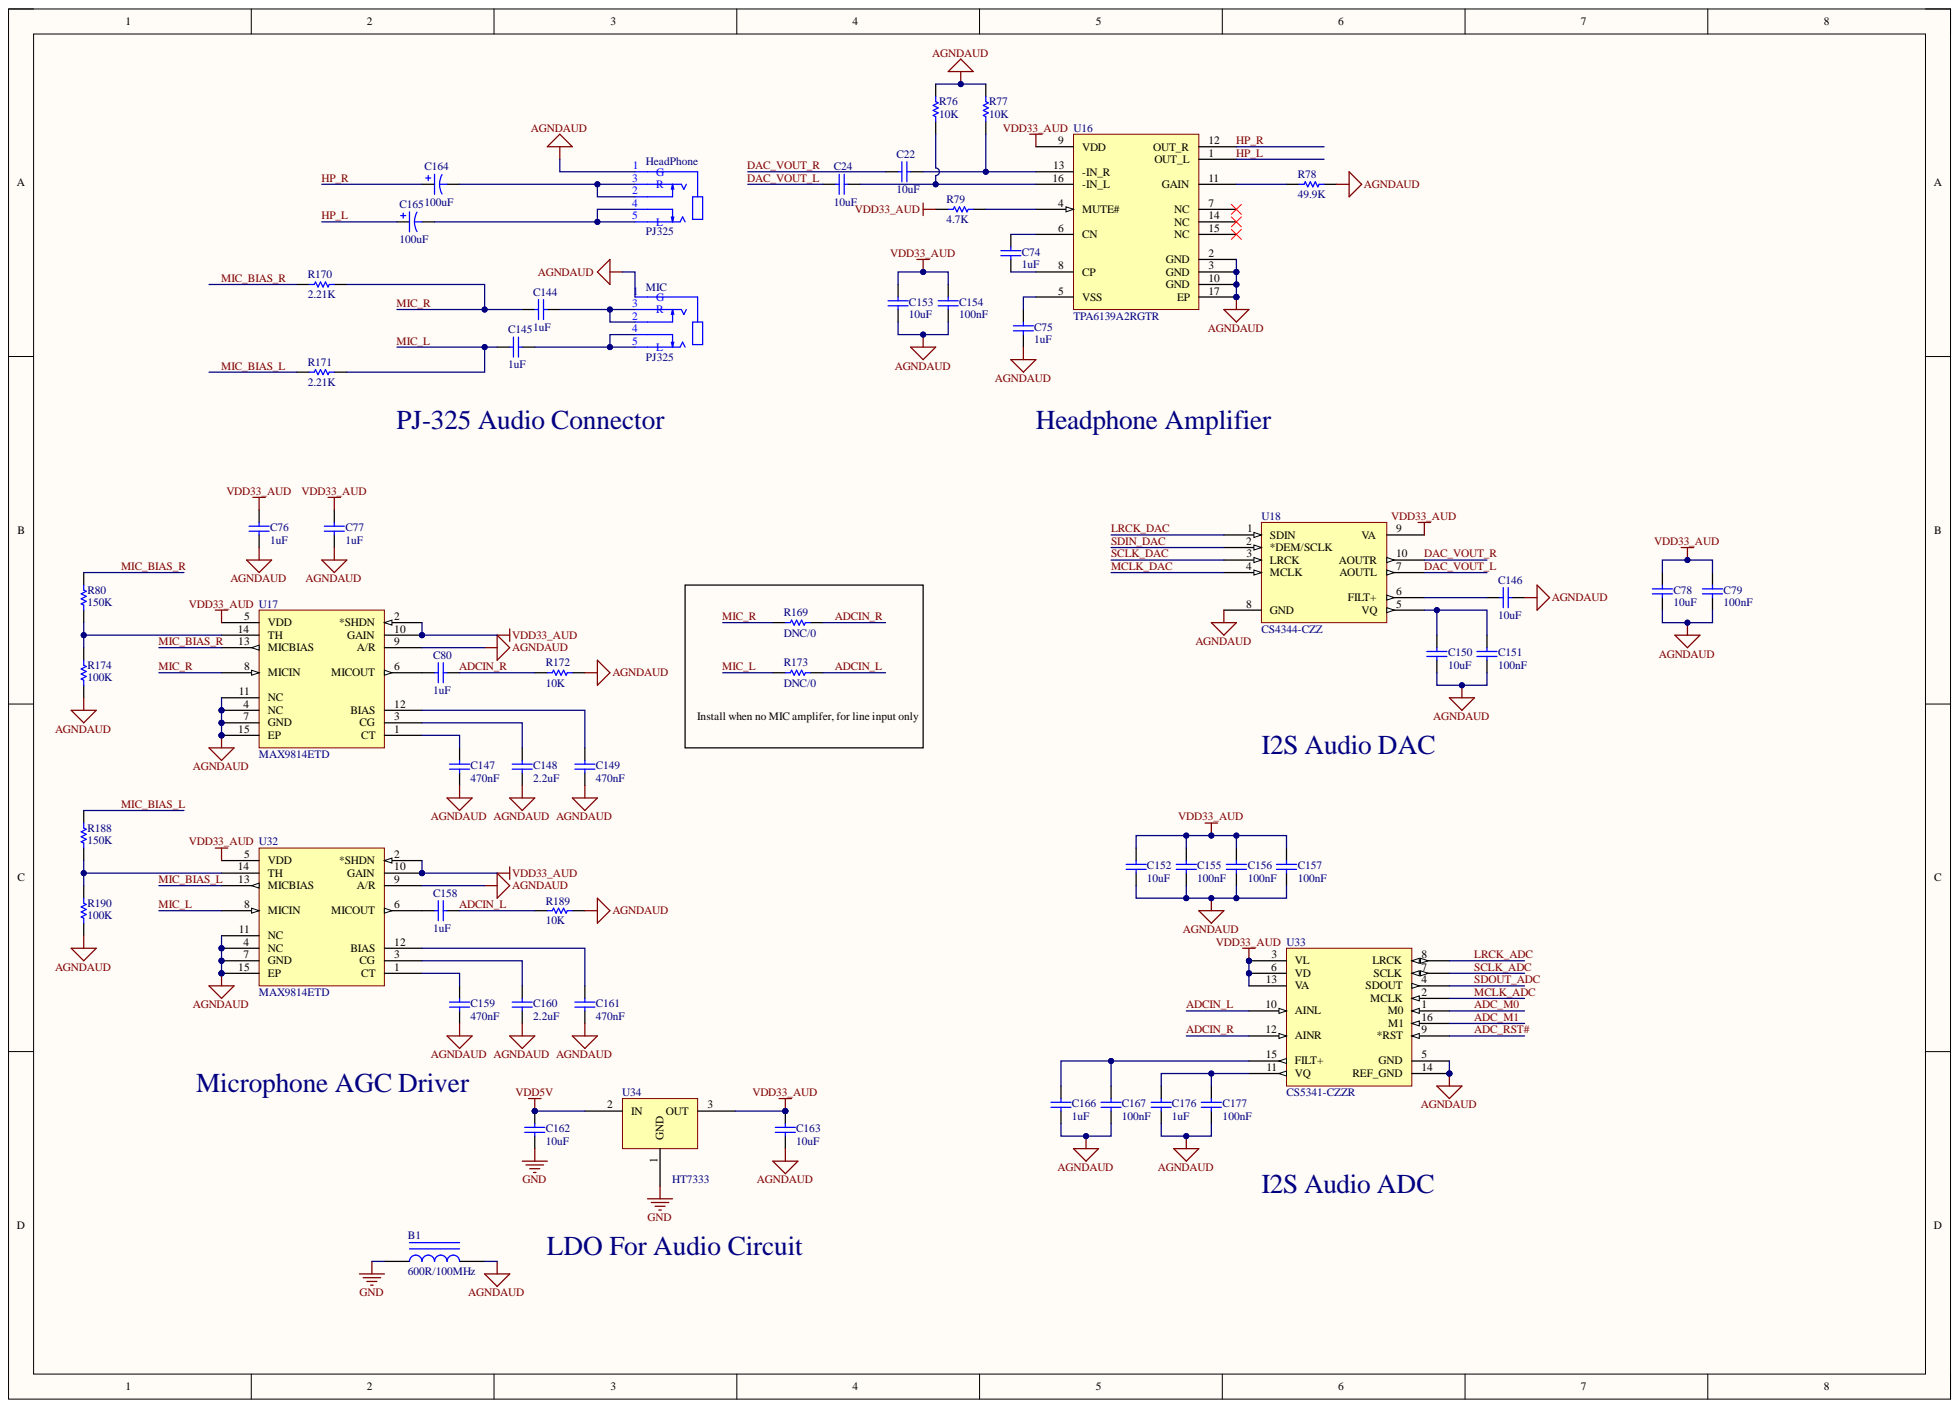
[picture p13: page 11]

Install when no MIC amplifer, for line input only

LDO For Audio Circuit

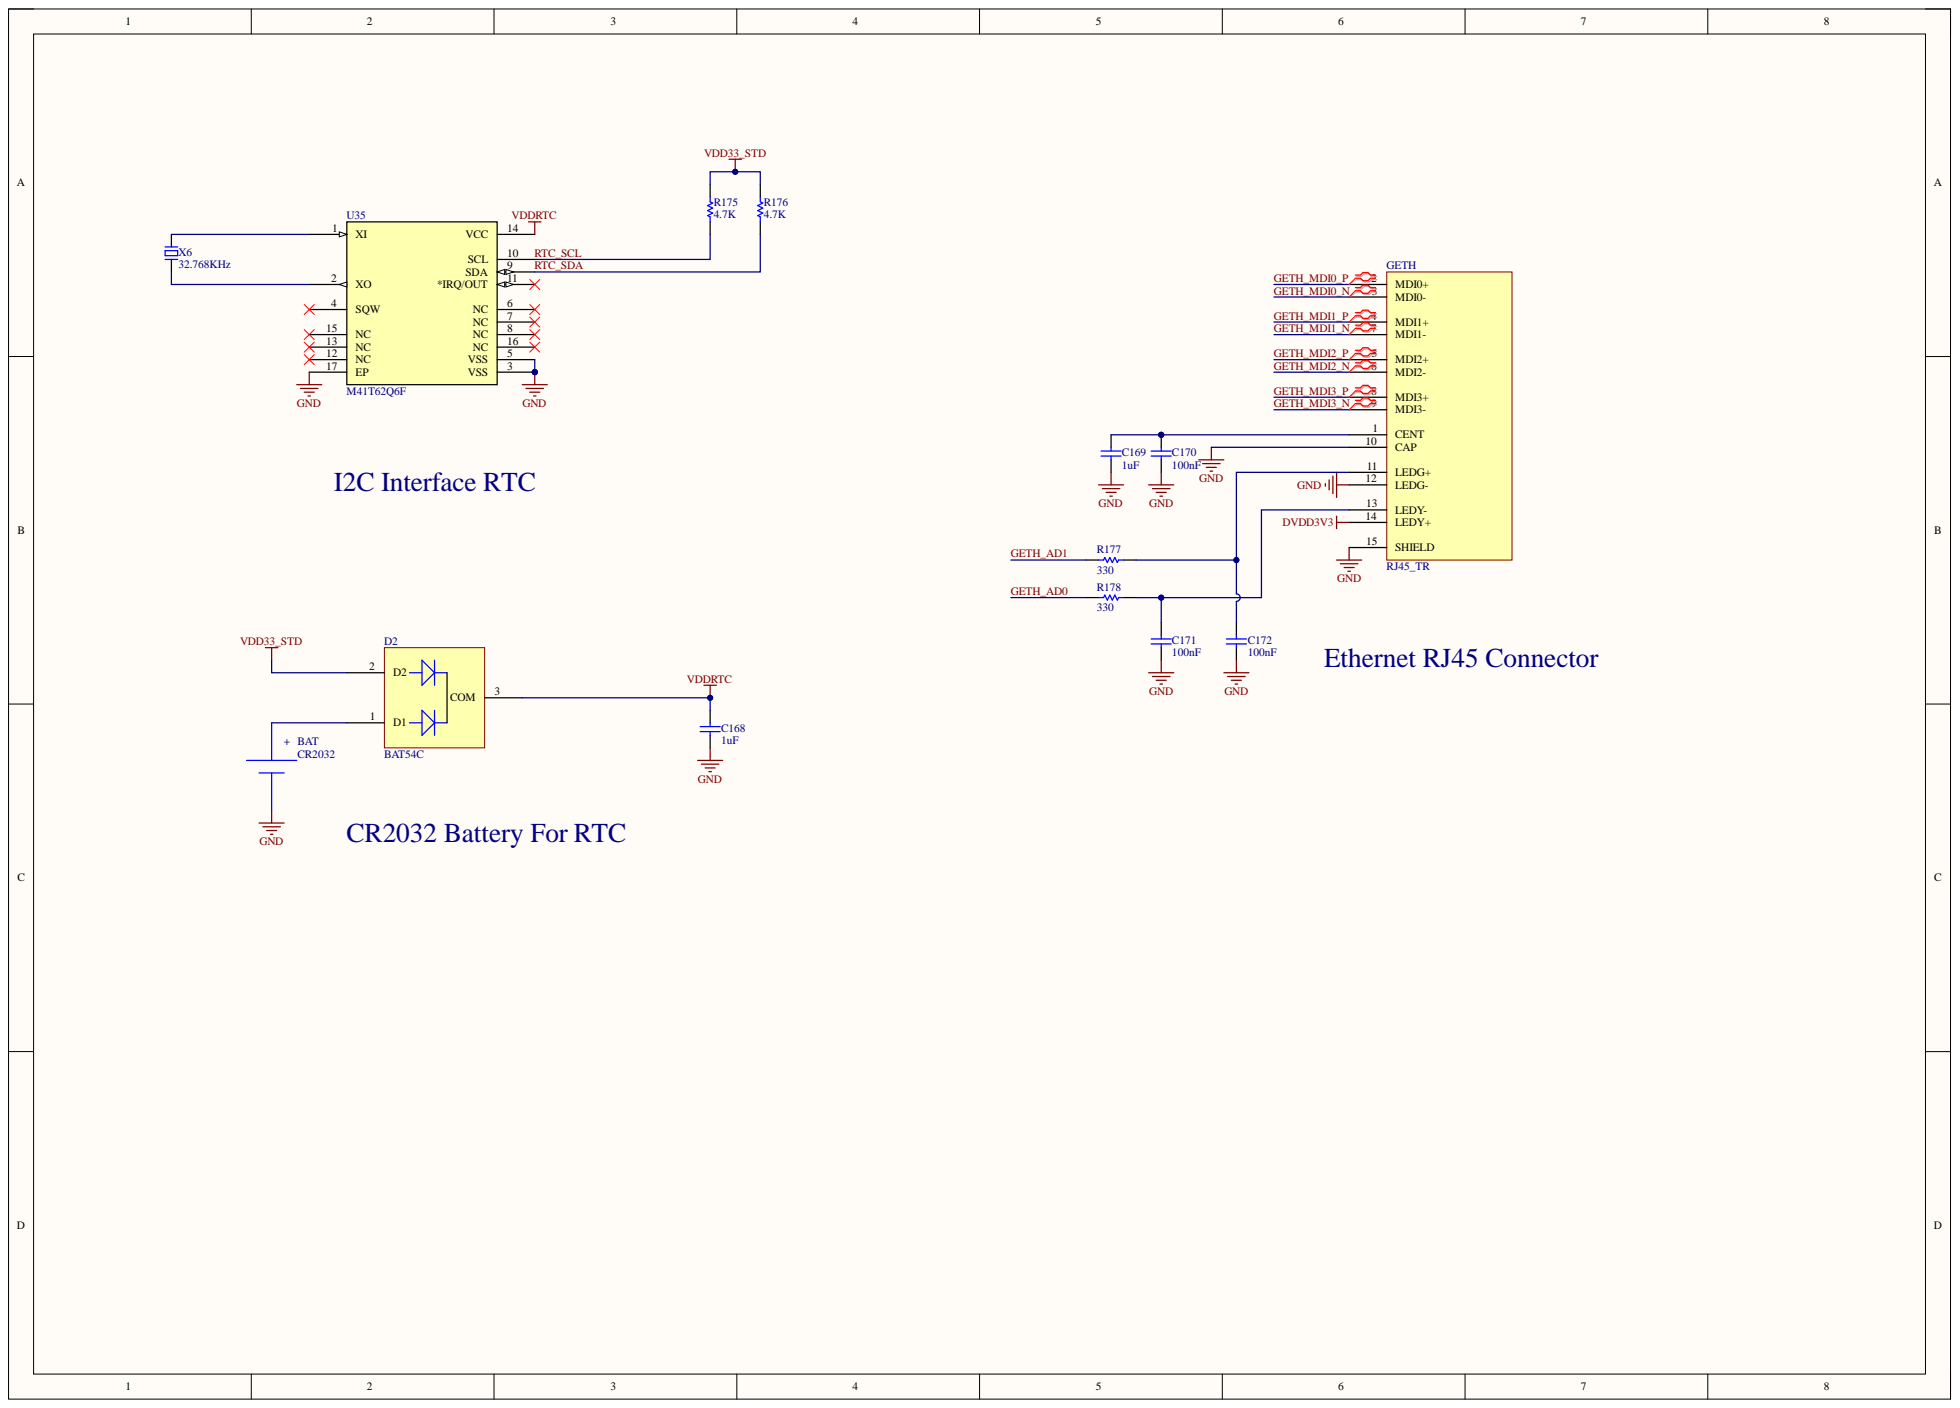
[picture p14: page 12]

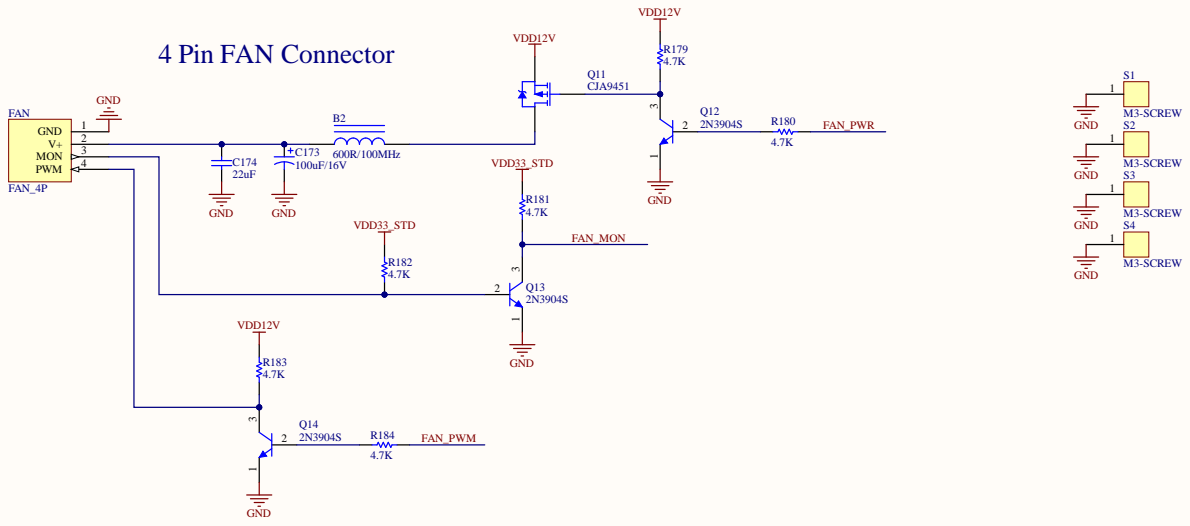
[picture p15: page 13]
