LAB5604/fpga_board/e4fpm7k325_mmb/docs/E4FPMK7_676主板原理图中文版.pdf

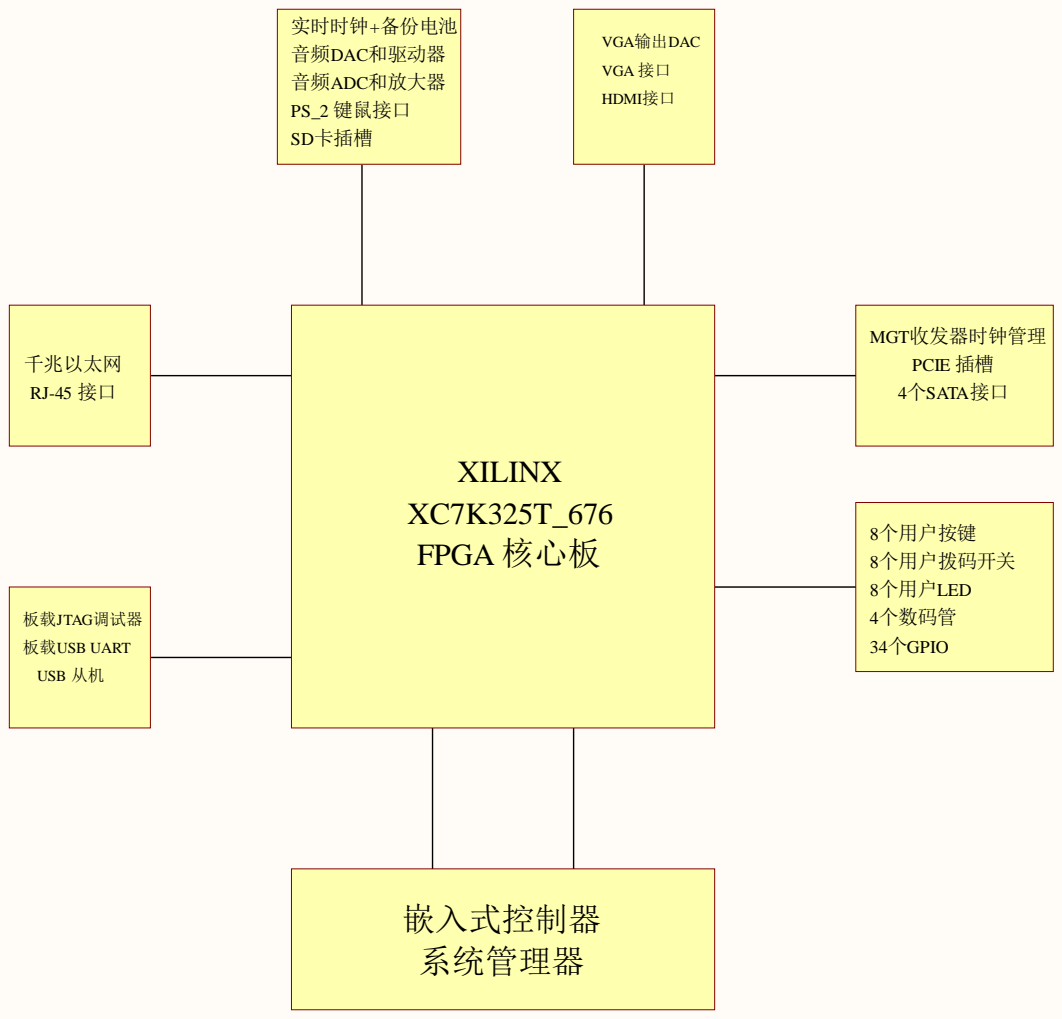
[picture p16: page 1]

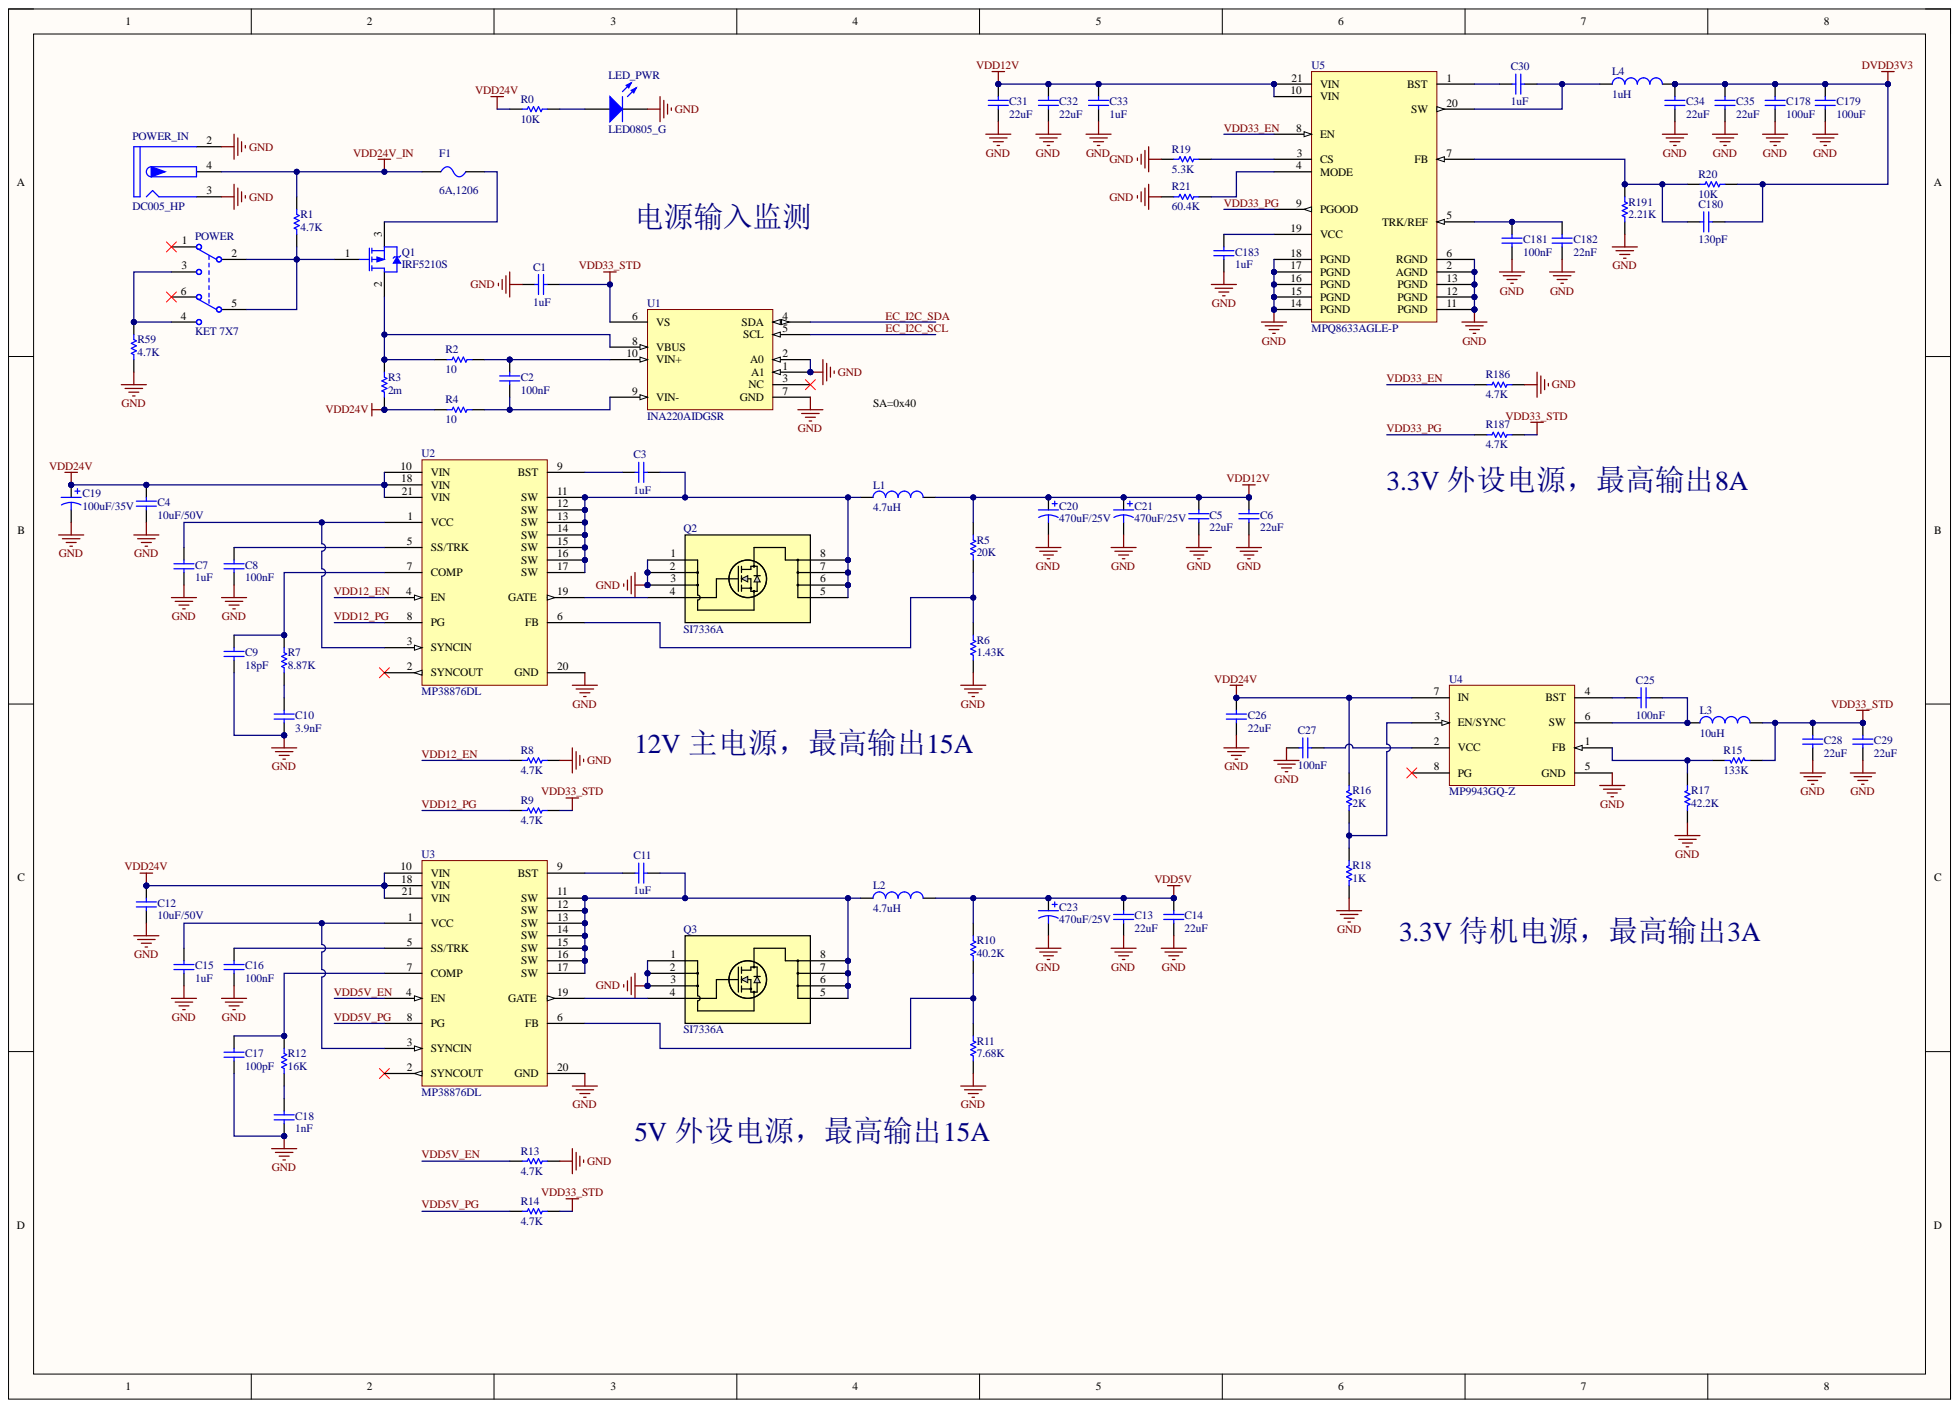
[picture p17: page 2]

MODE 4

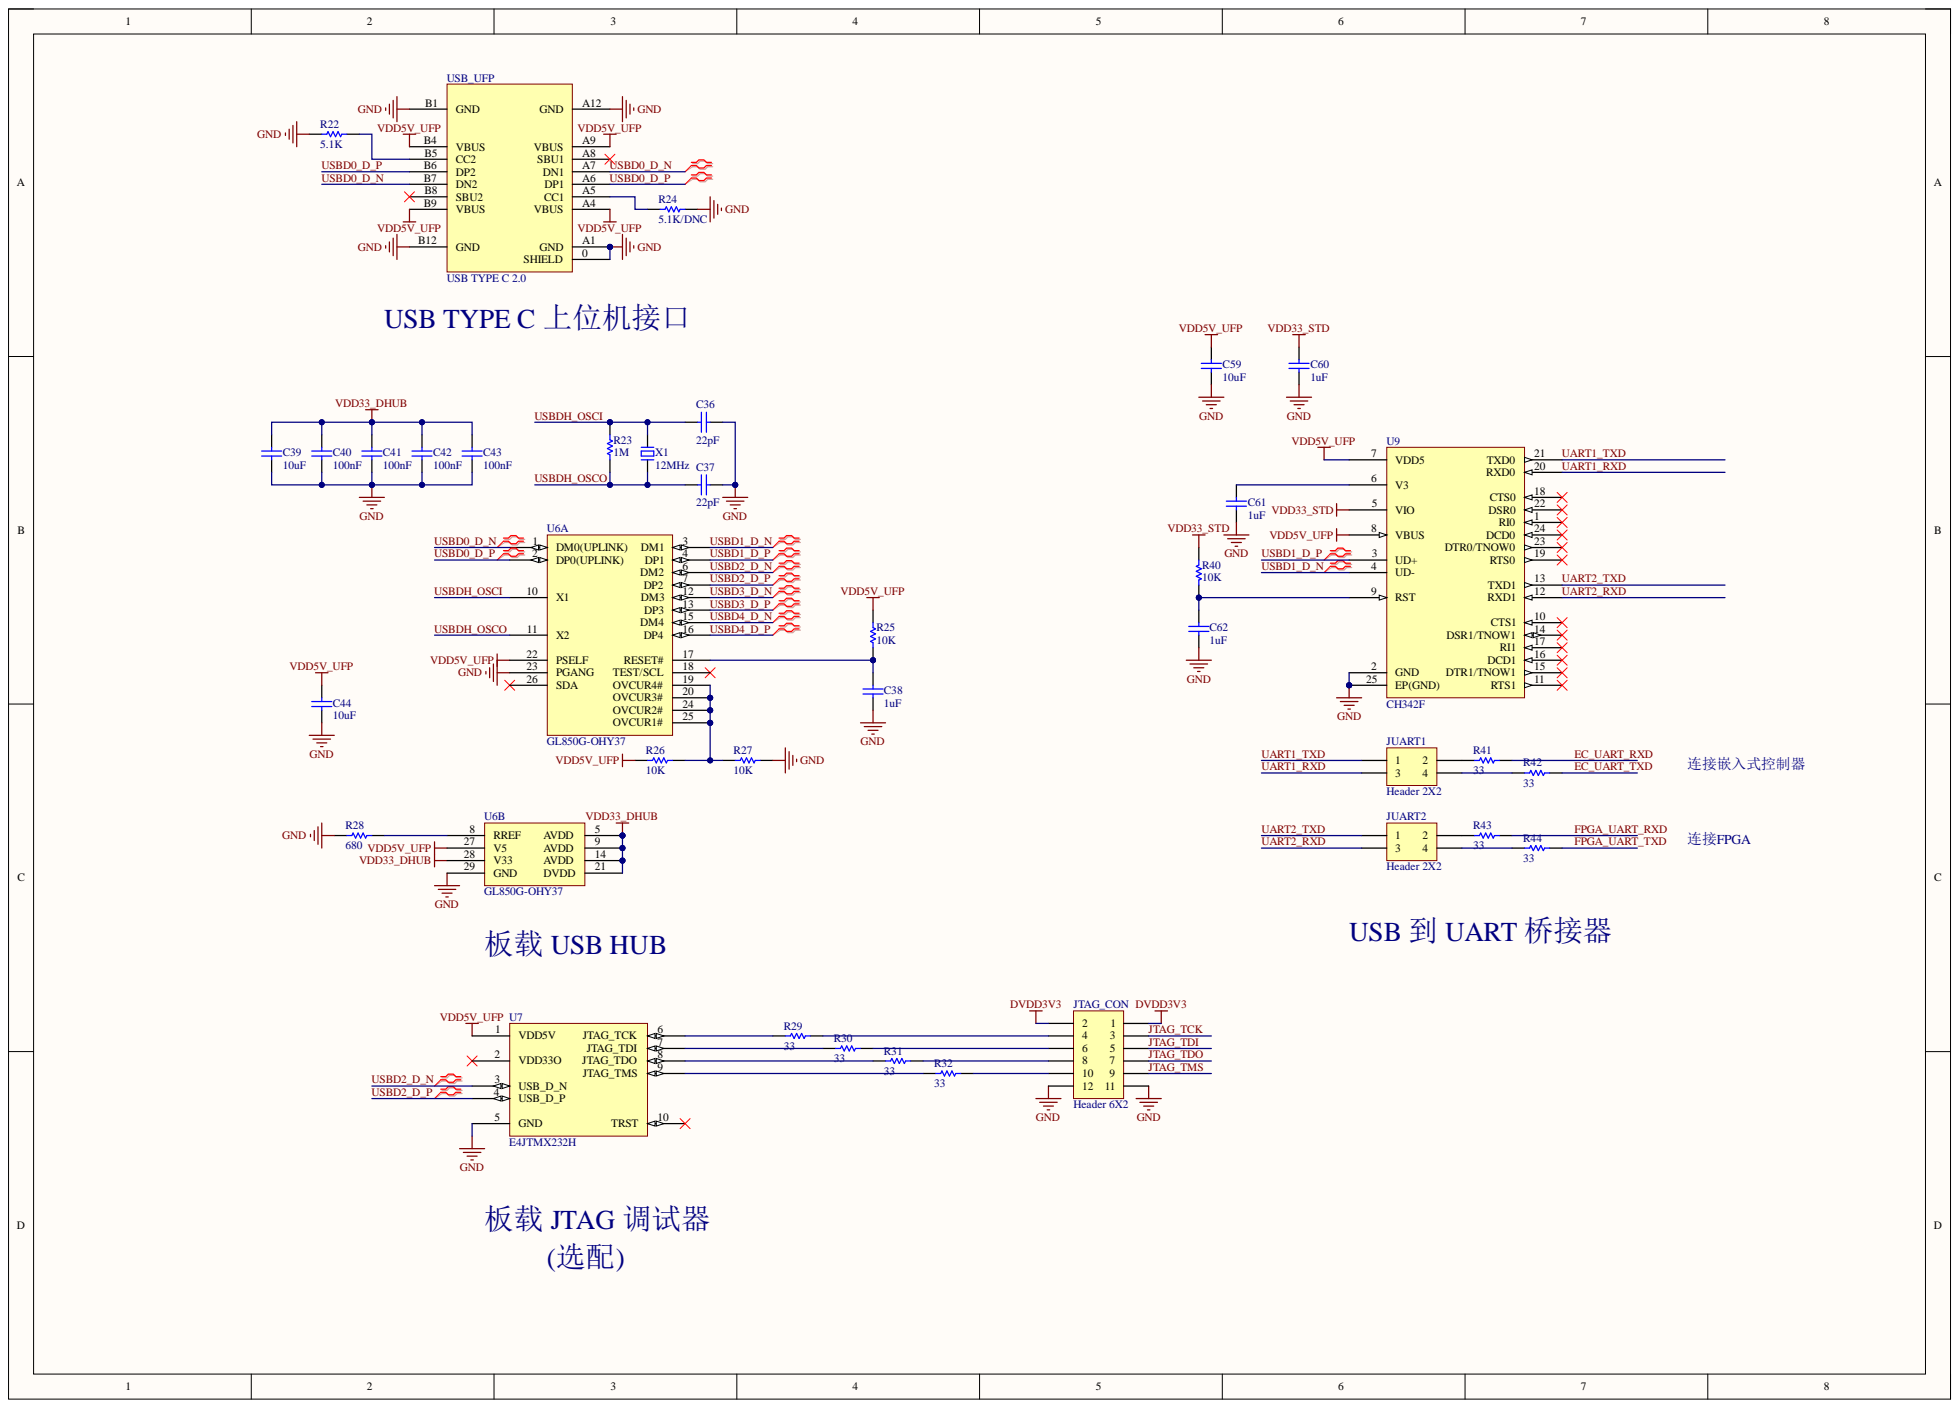
[picture p18: page 3]

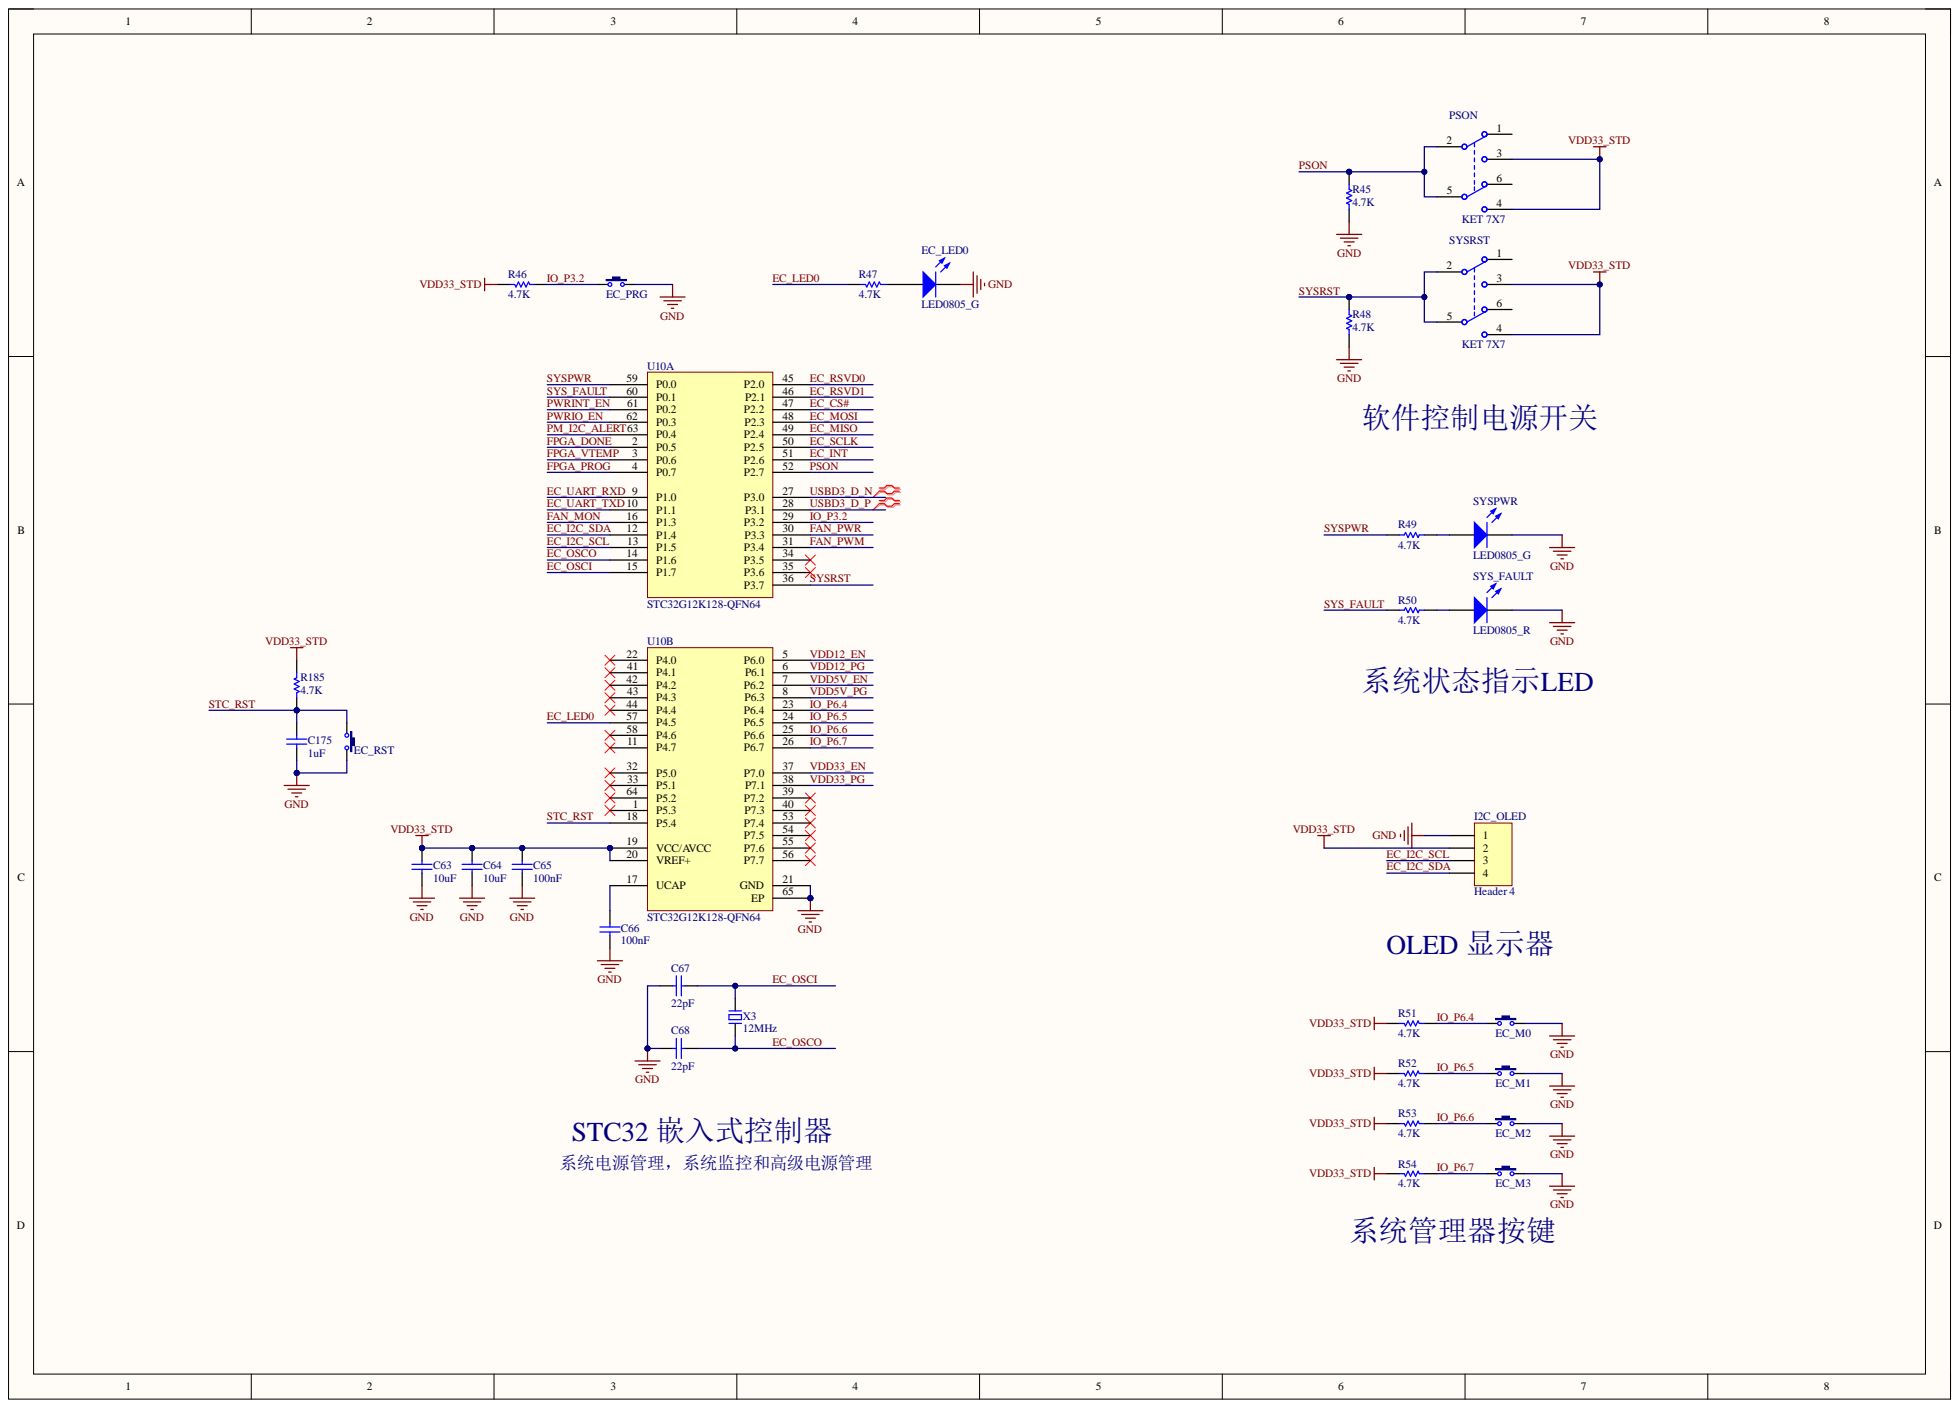
[picture p19: page 4]

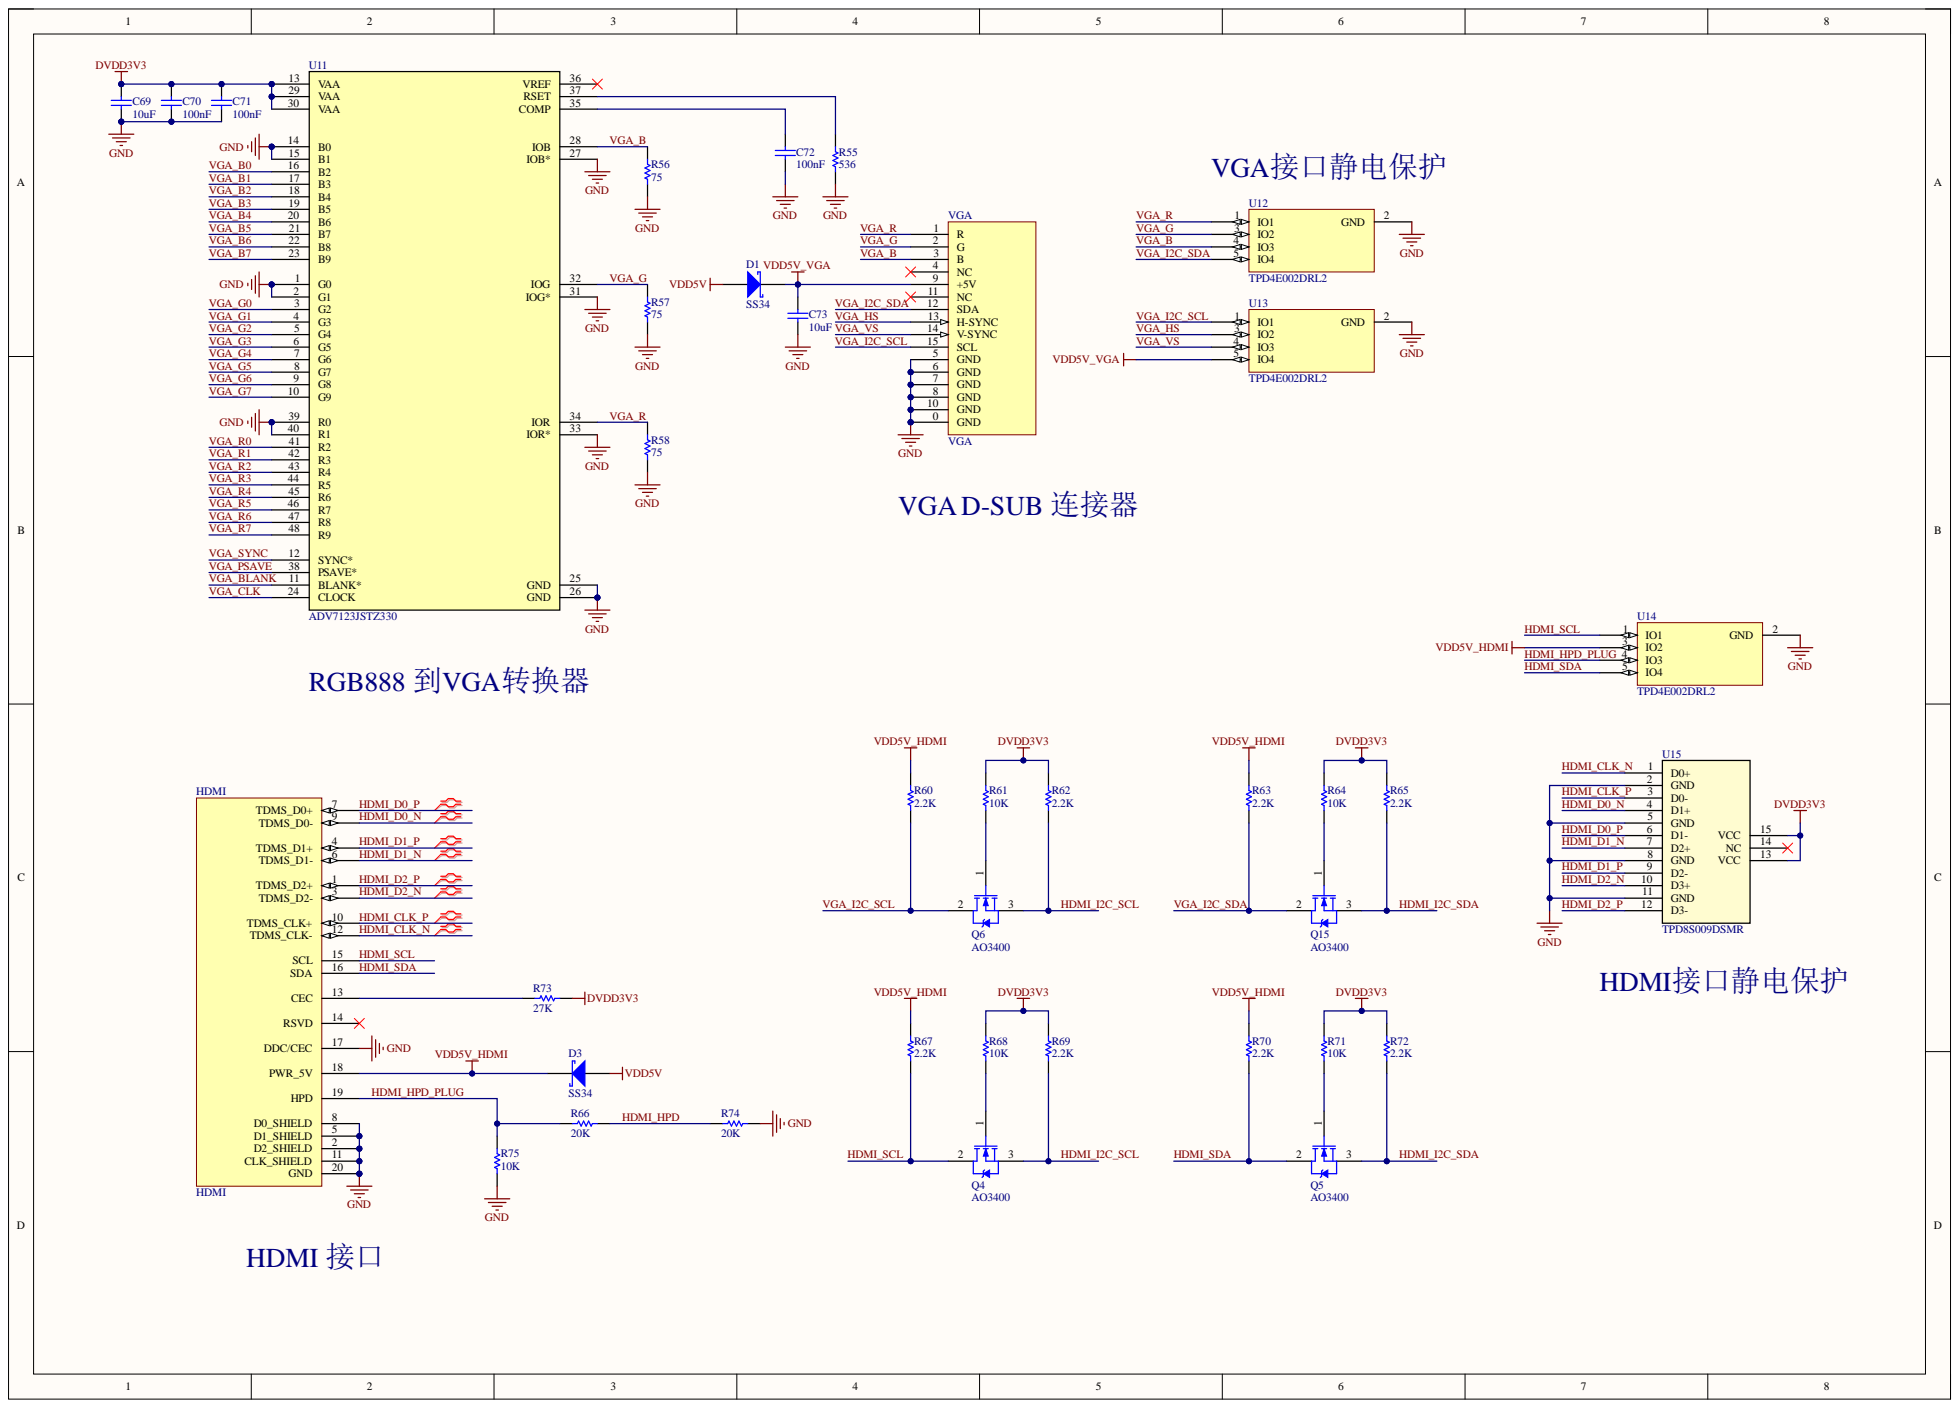
[picture p20: page 5]

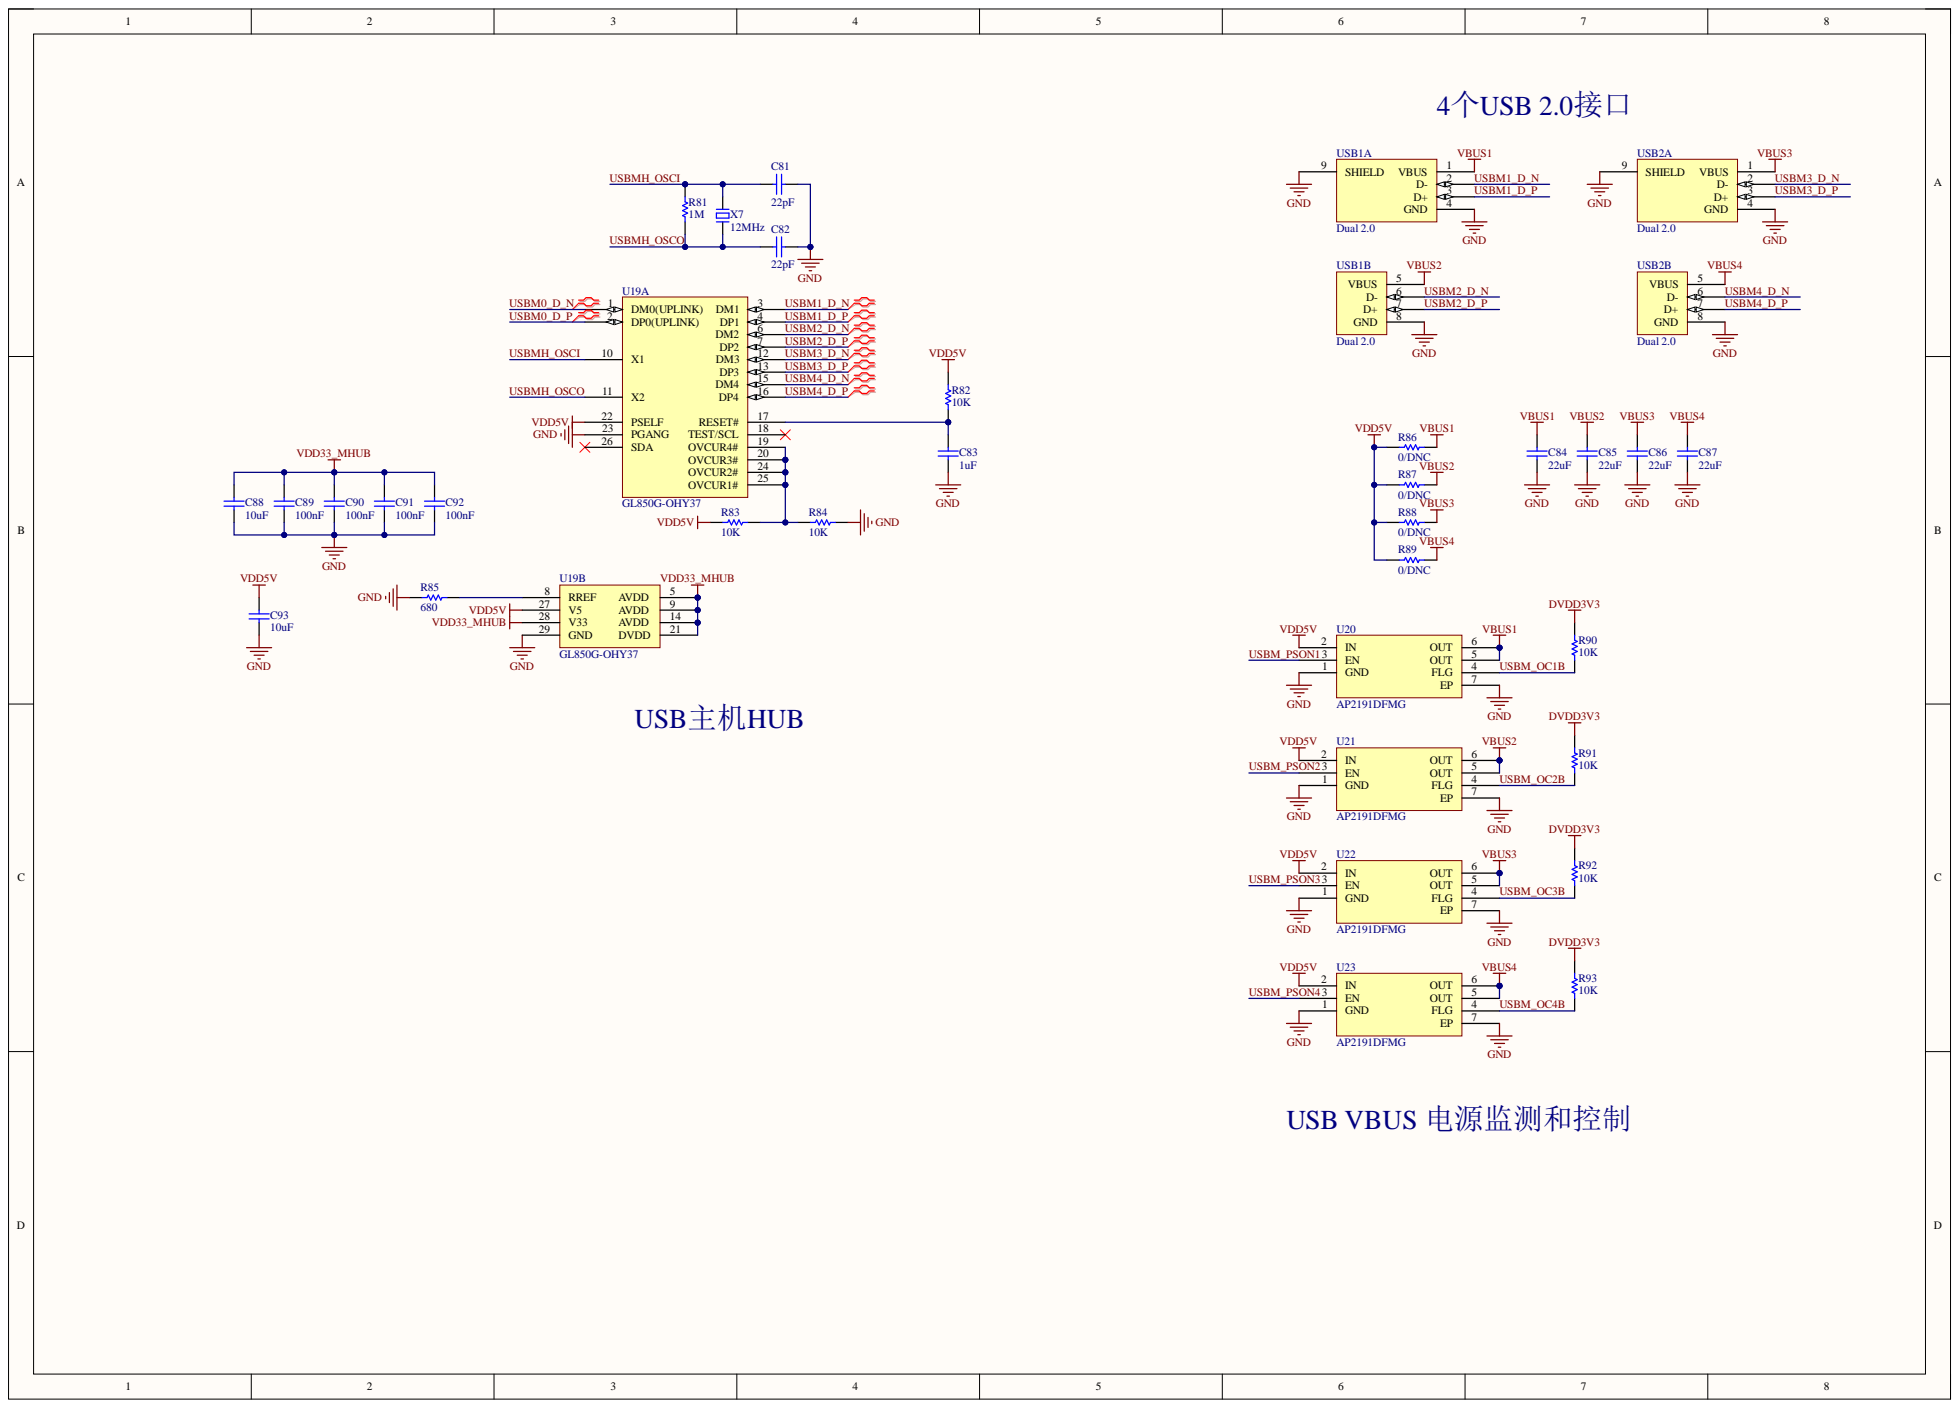
[picture p21: page 6]

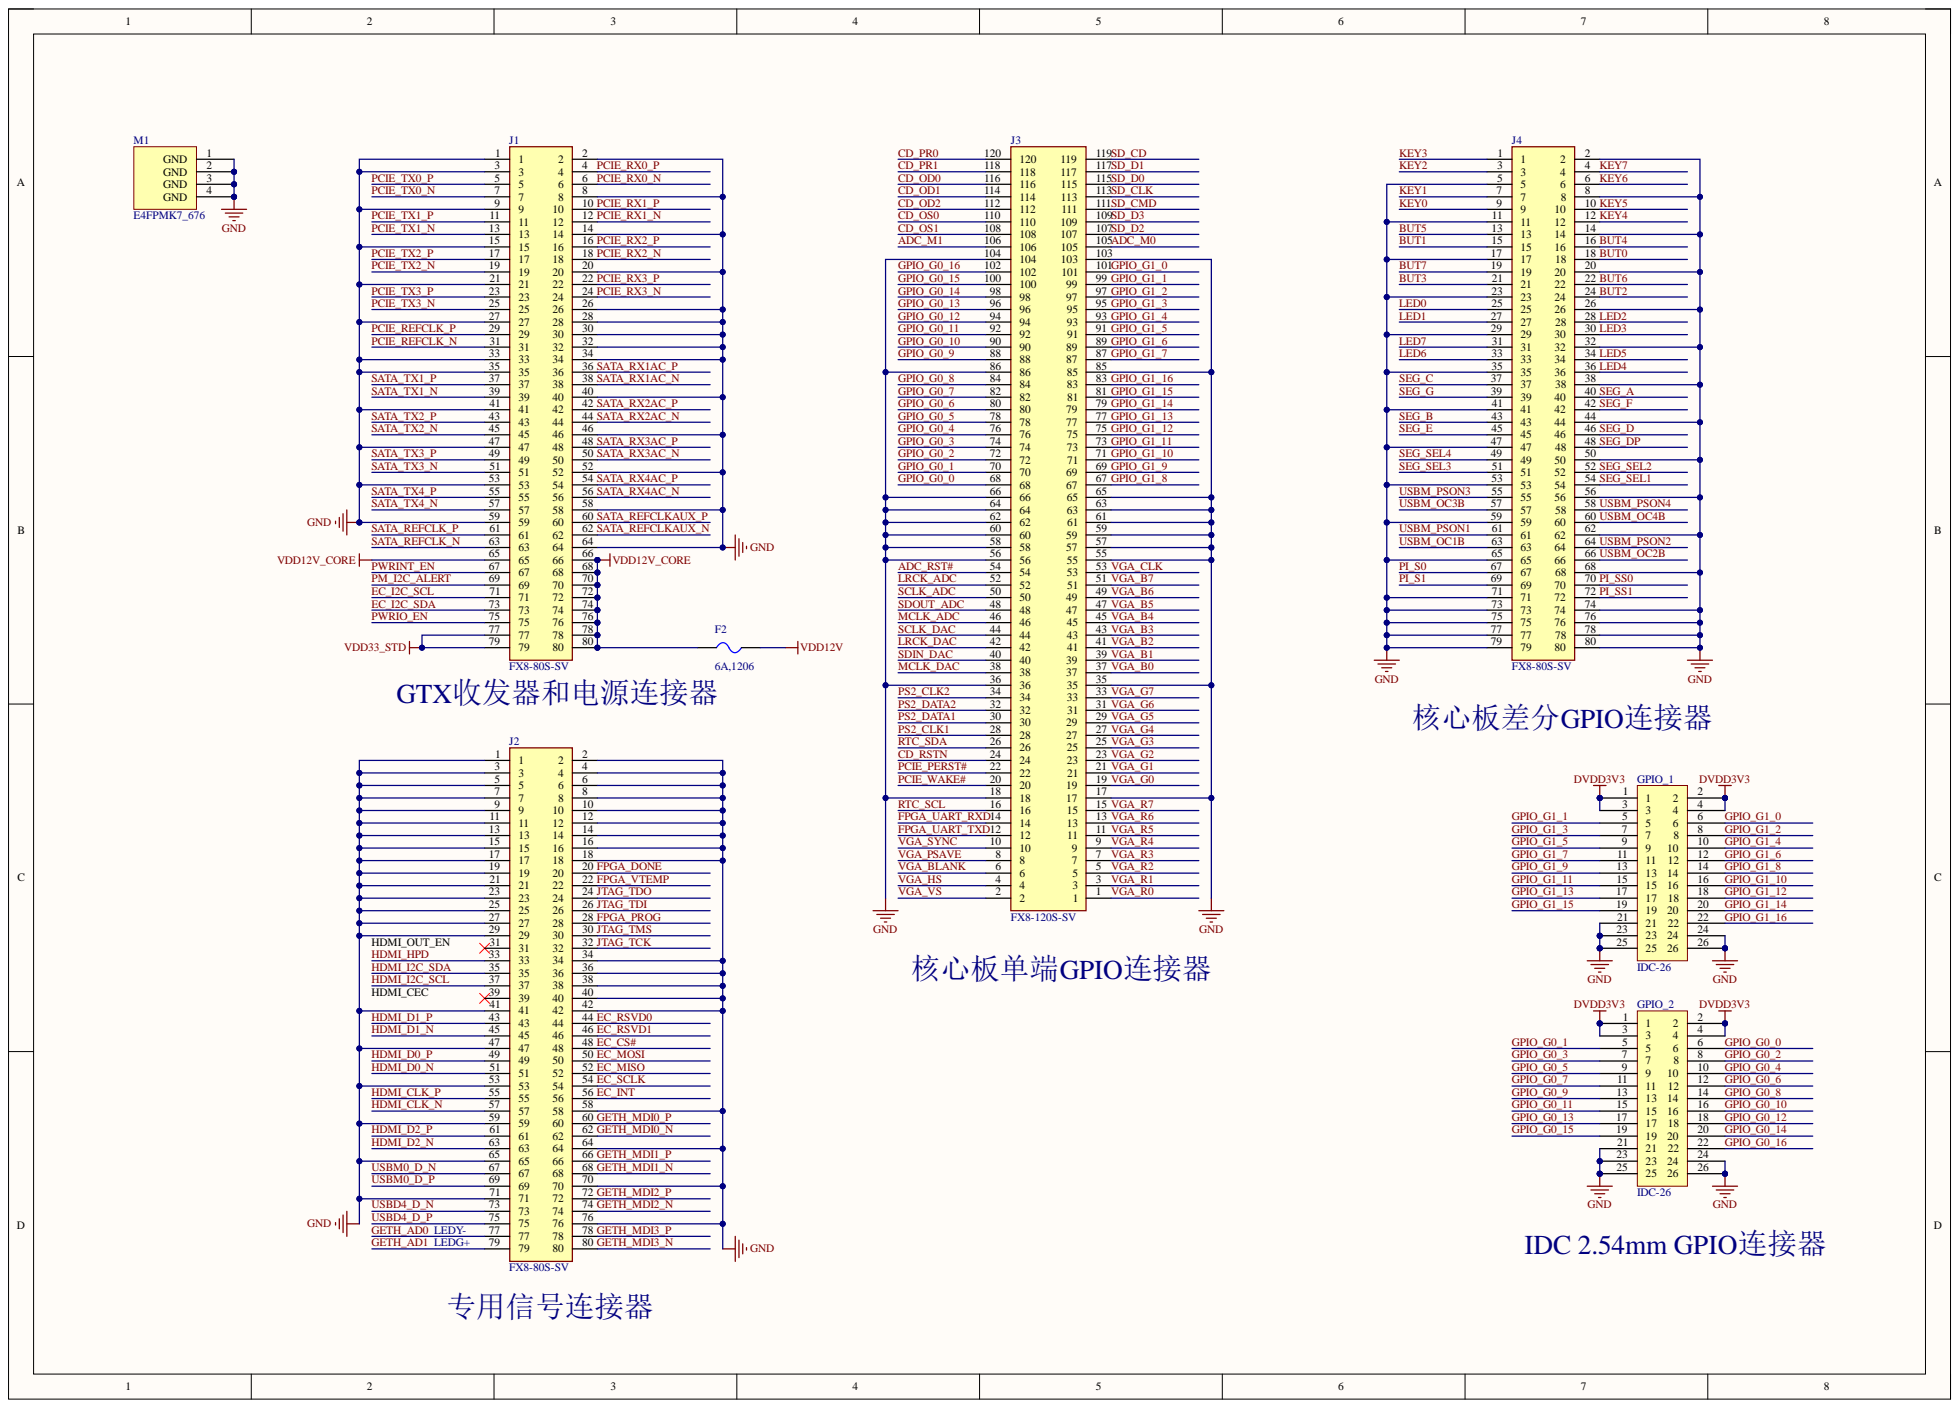
[picture p22: page 7]

PS2_C L K 2 PS2_D ATA 2 PS2_D ATA 1 PS2_C L K 1 RT C_SD A C D_RST N PC IE_PE RST # PC IE_WA KE # | V G A_G 7 V G A_G 6 V G A_G 5 V G A_G 4 V G A_G 3 V G A_G 2 V G A_G 1 V G A_G 0

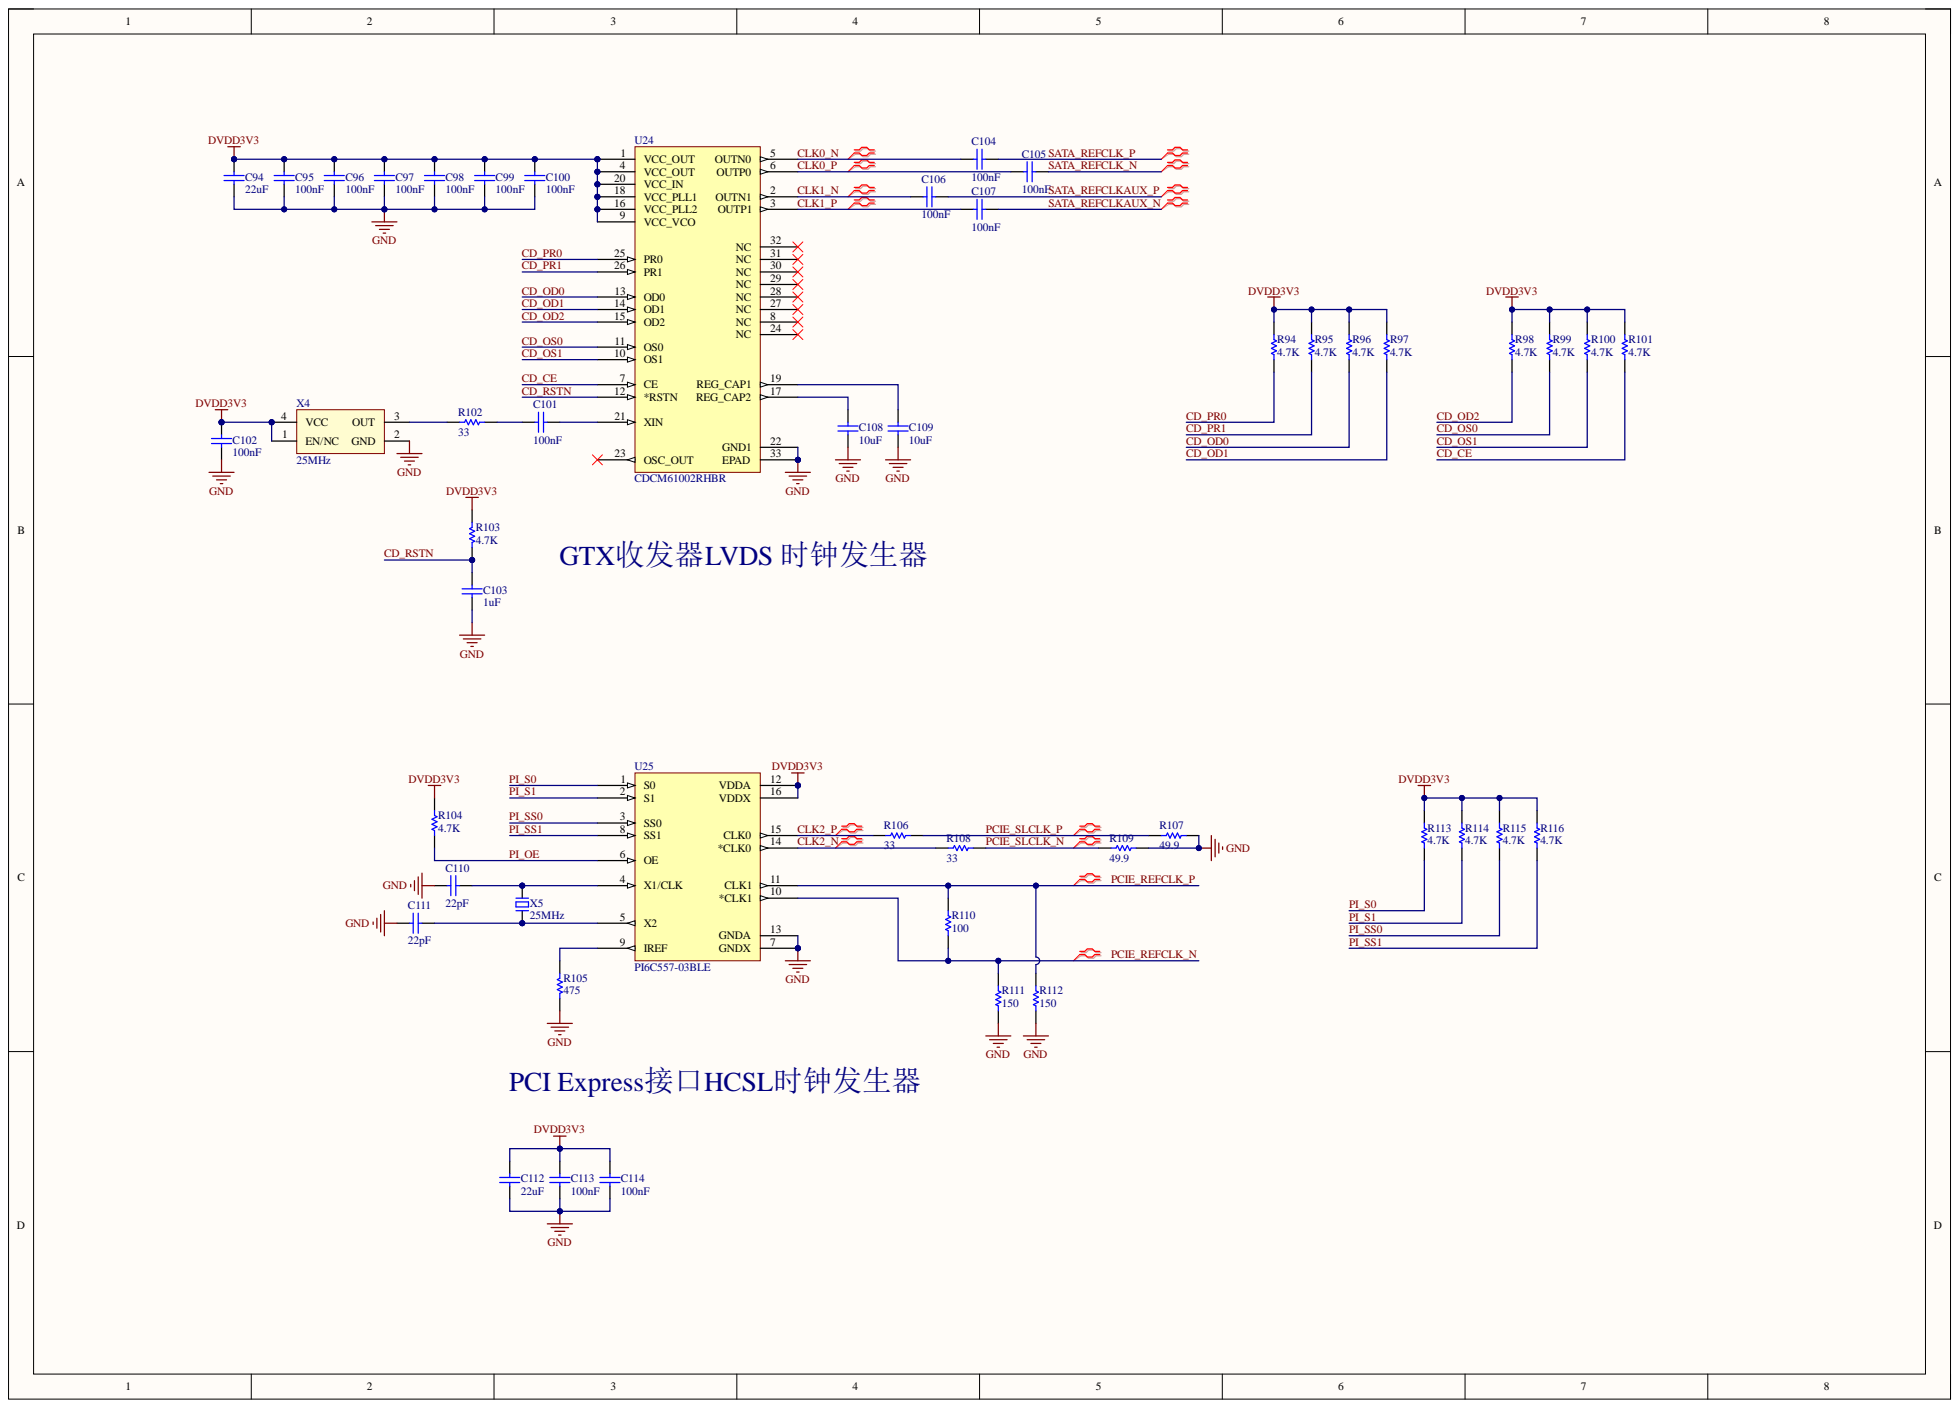
[picture p23: page 8]

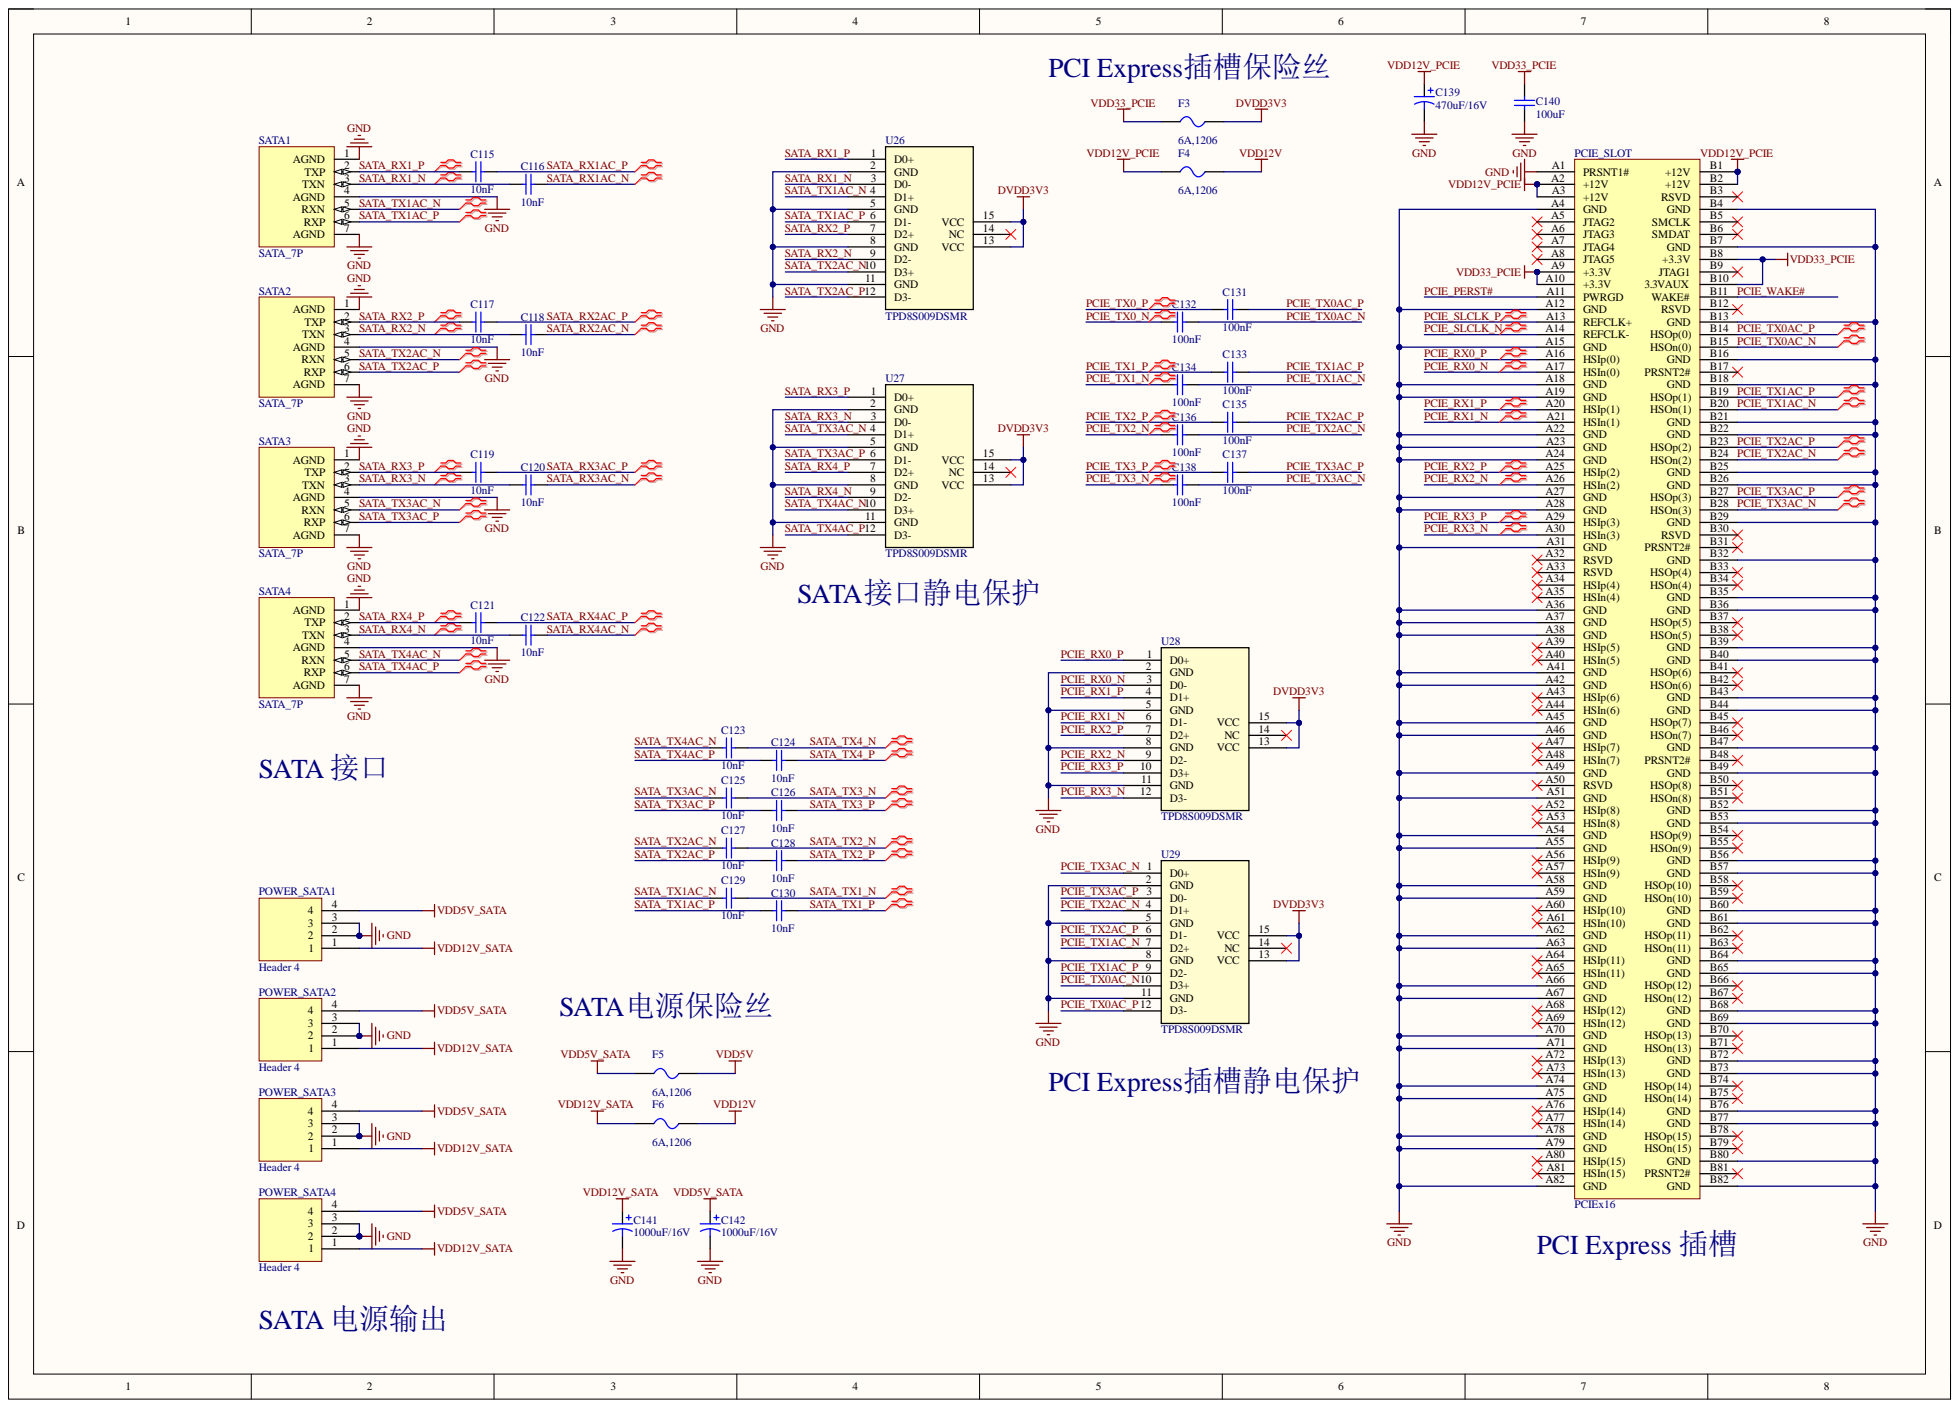
[picture p24: page 9]

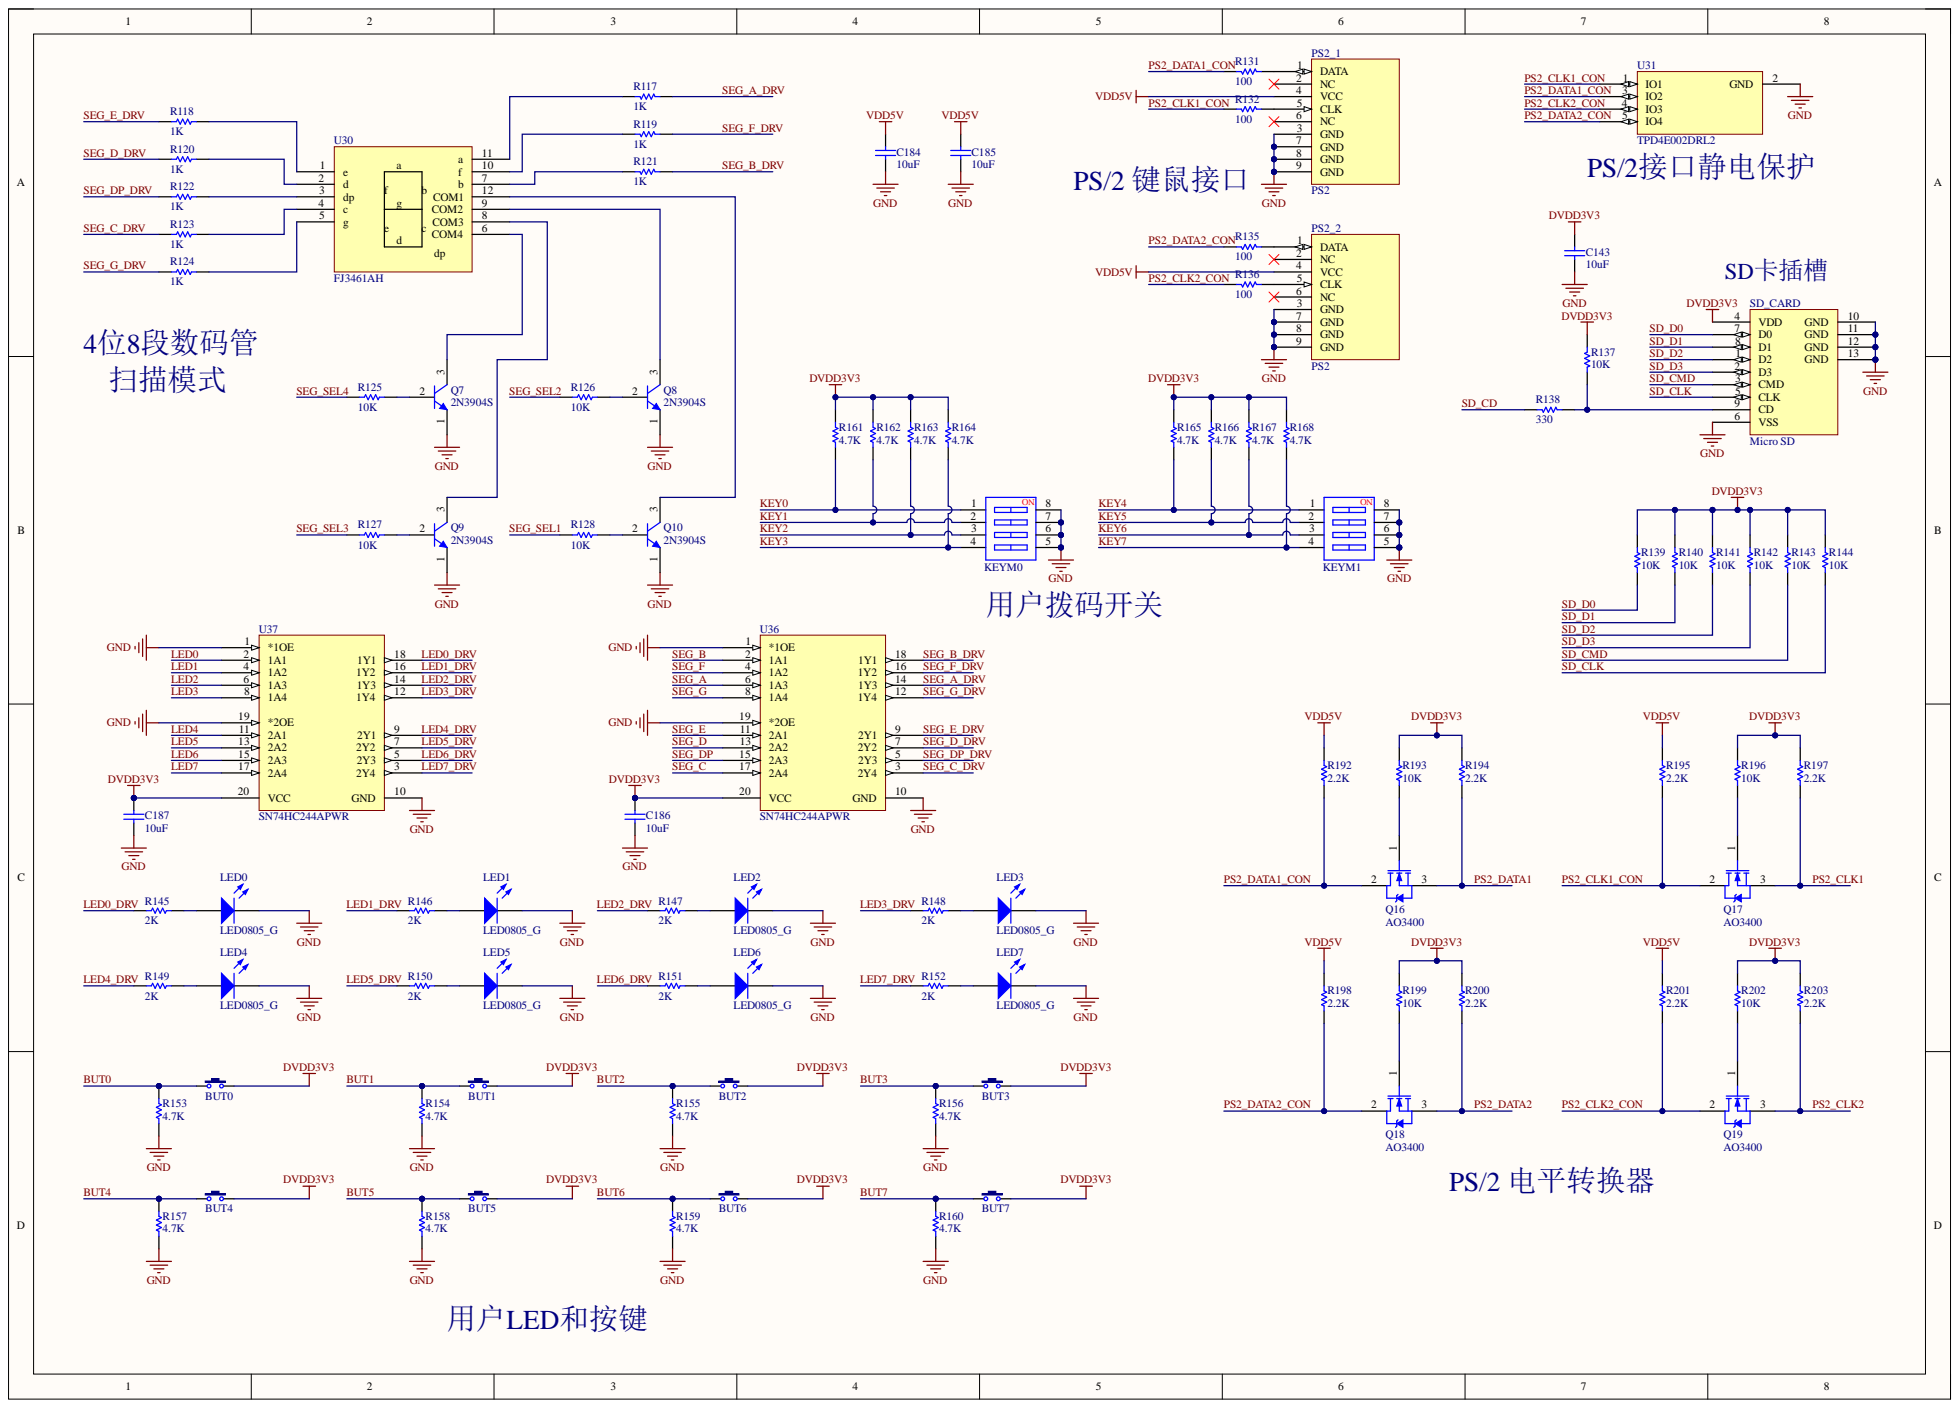
[picture p25: page 10]

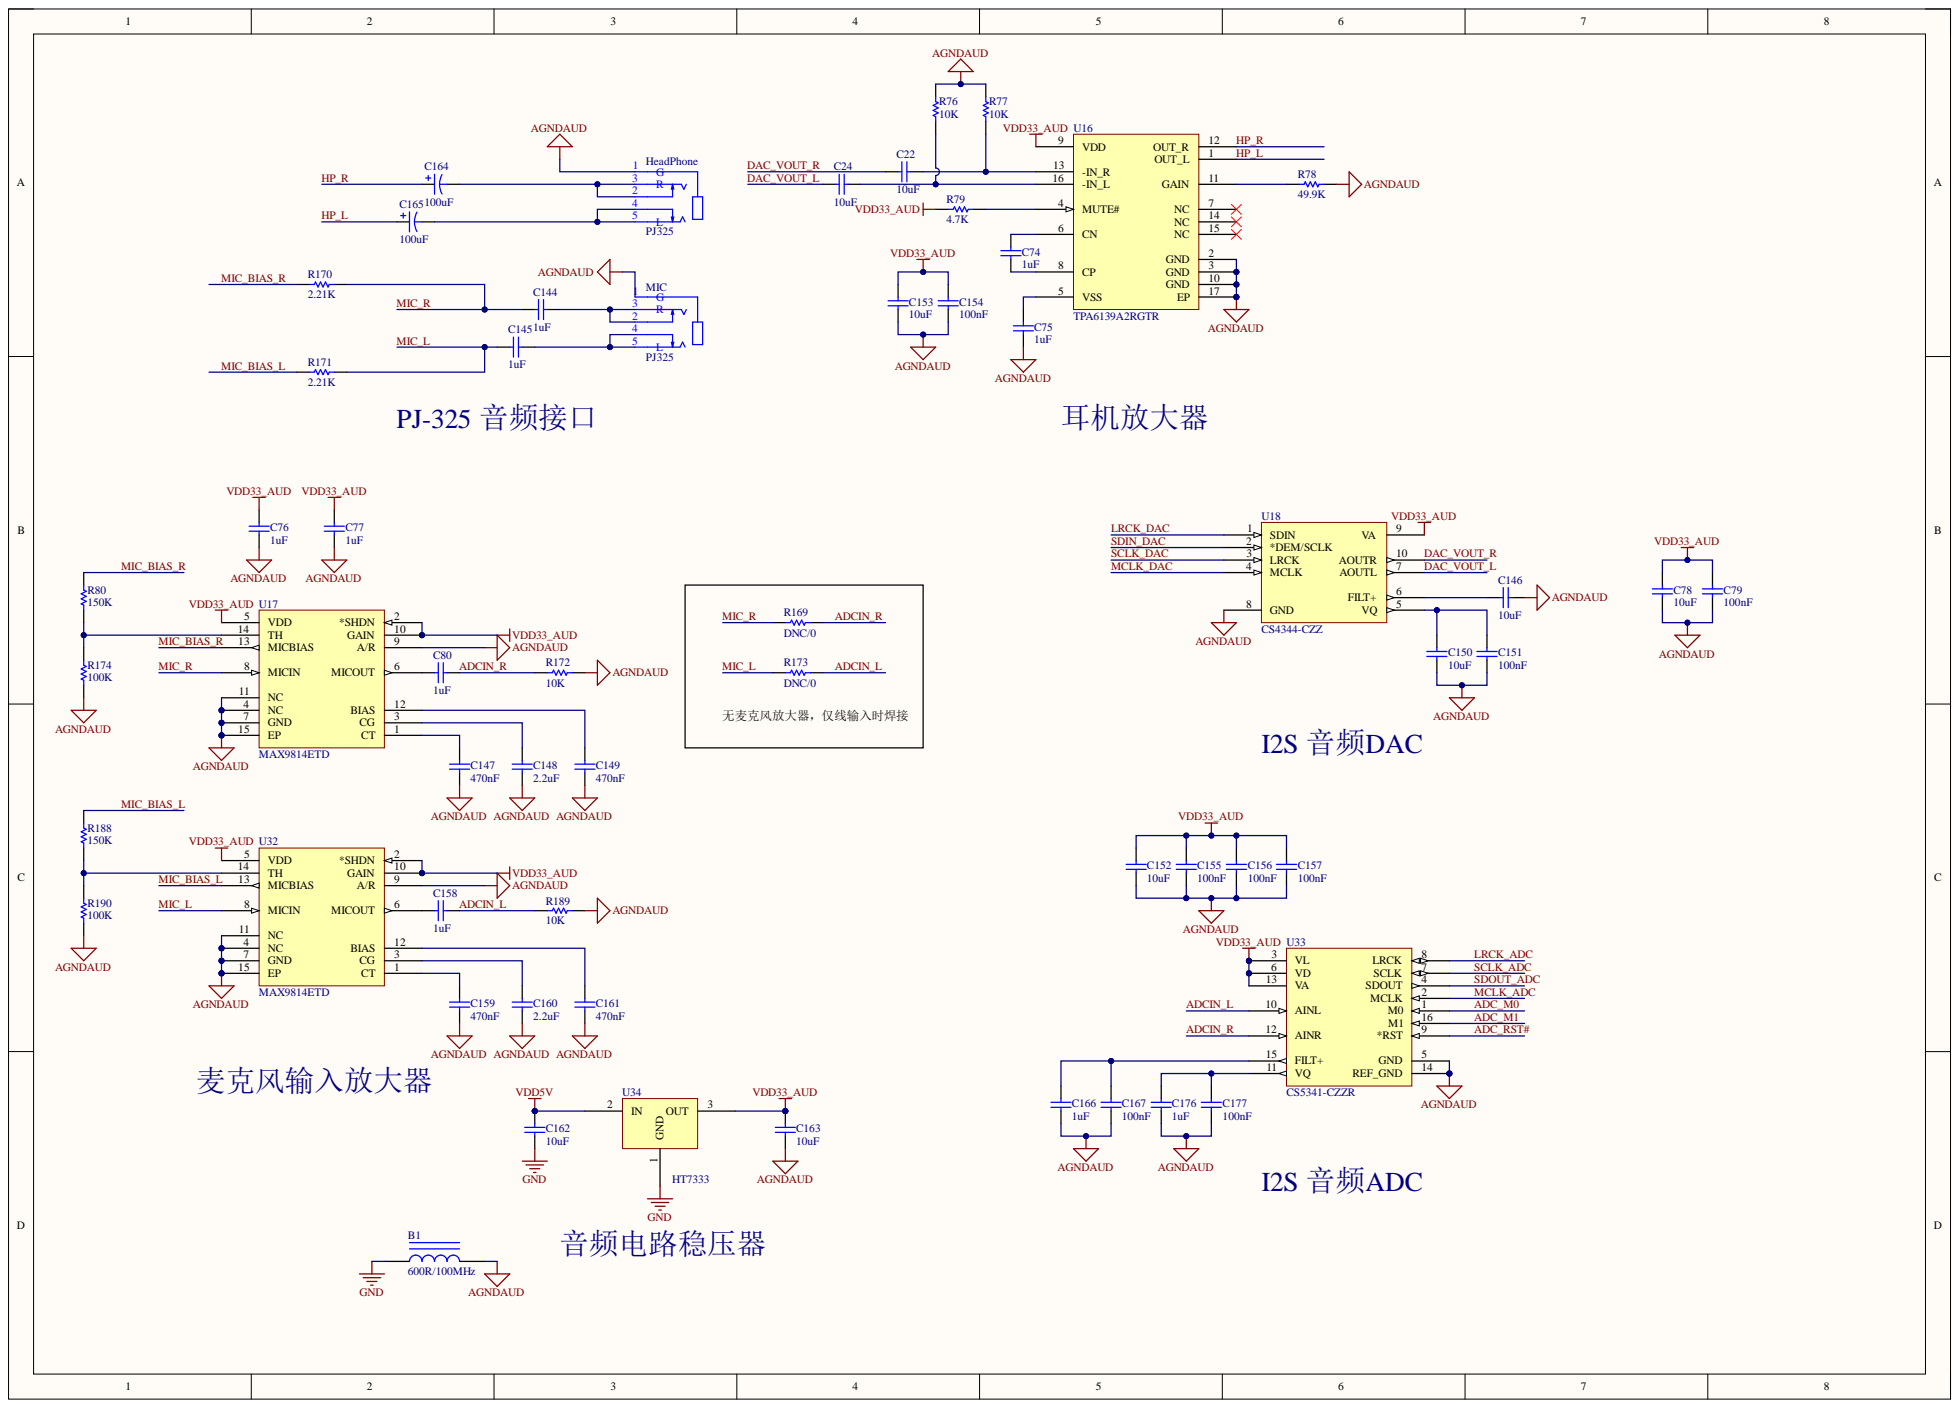
[picture p26: page 11]

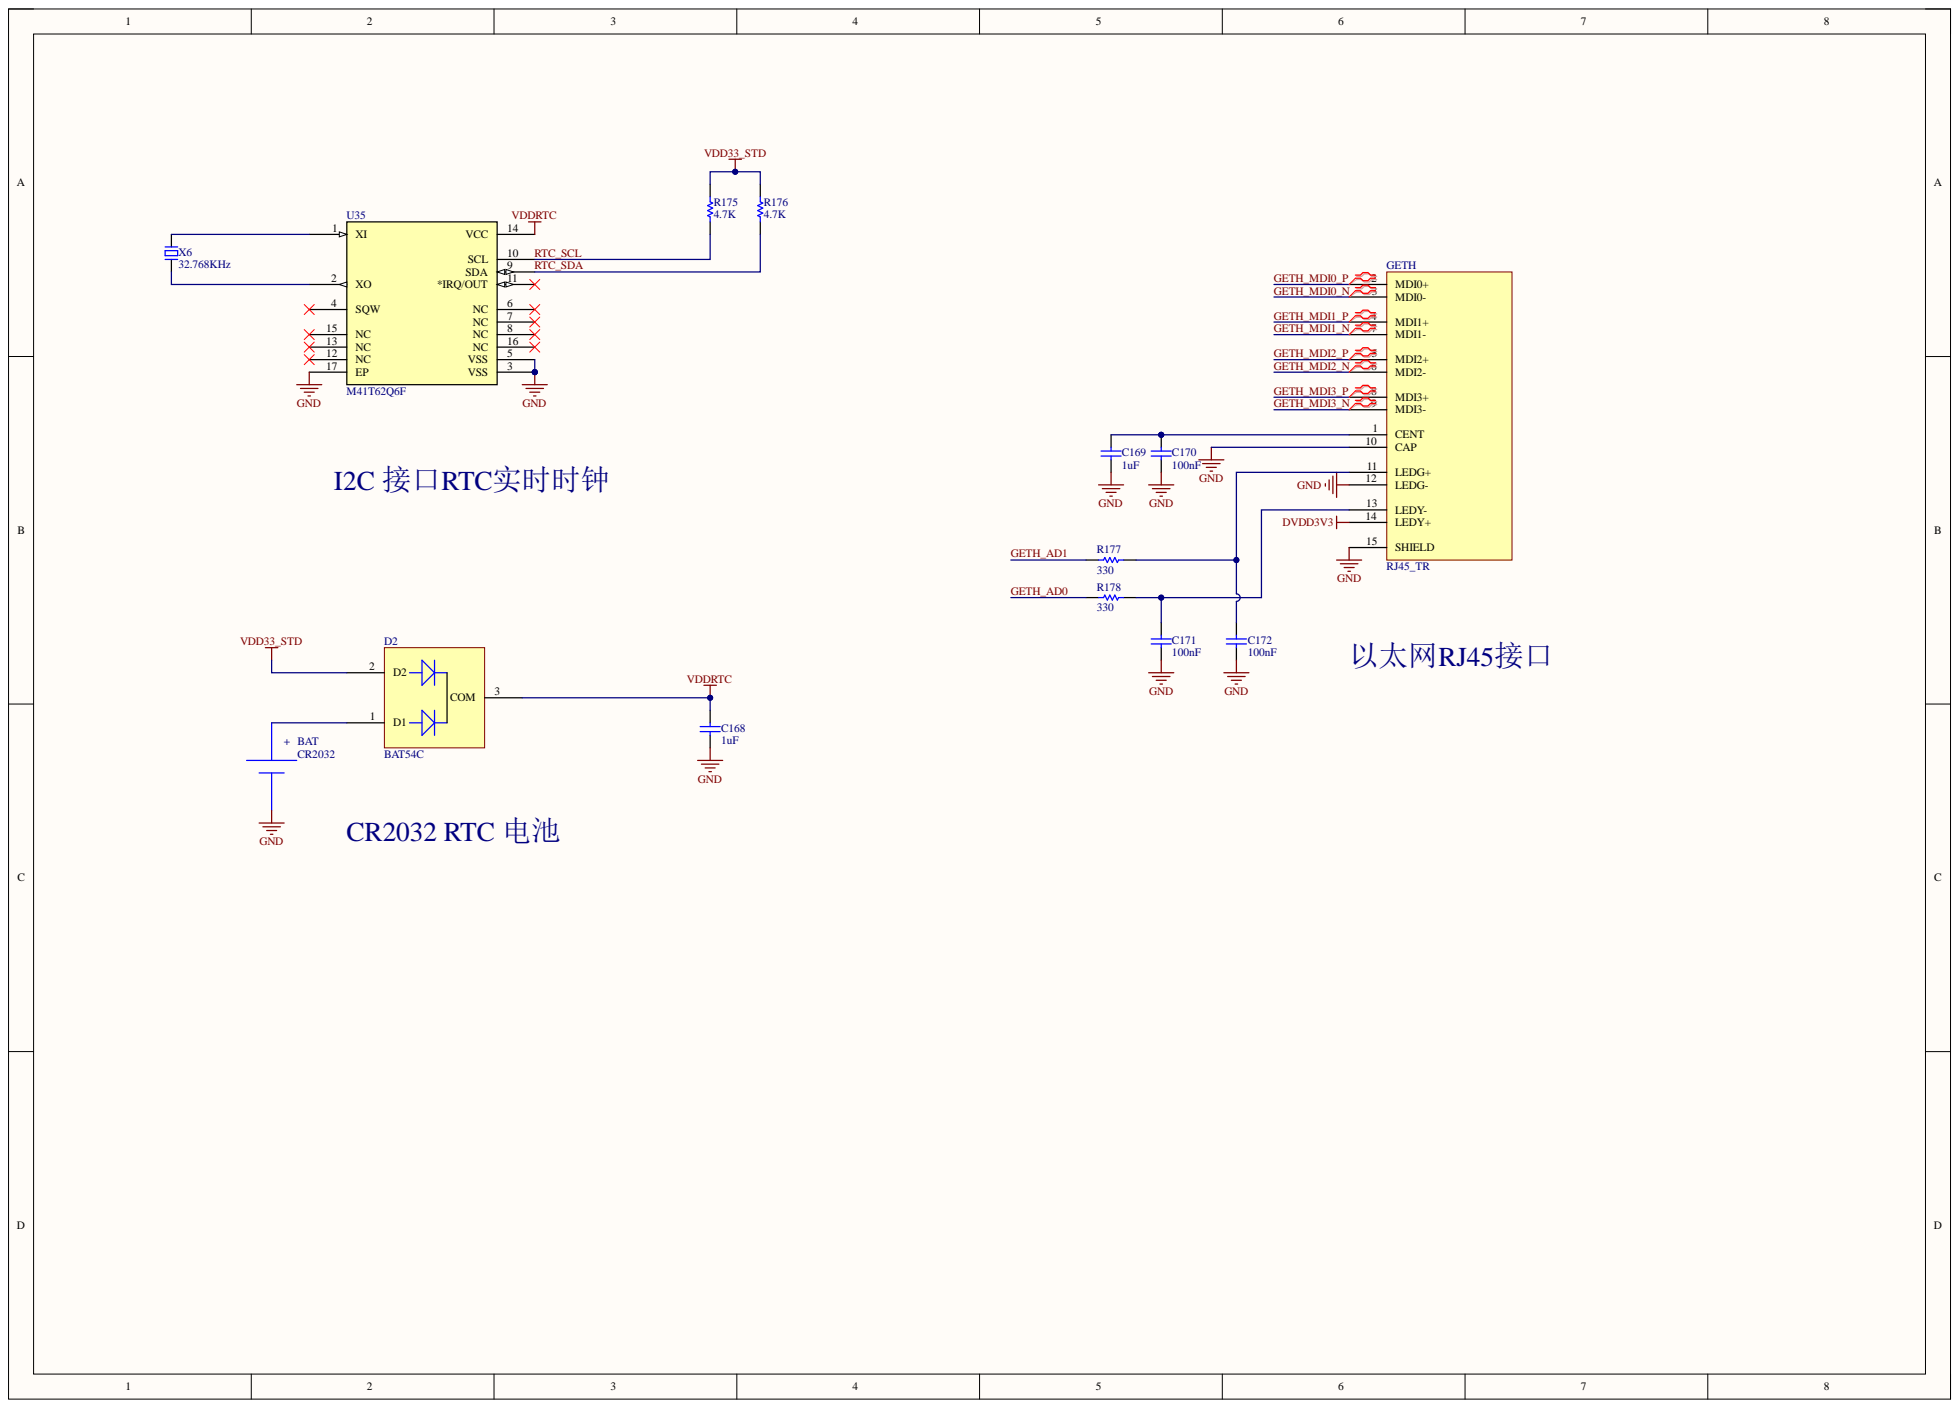
[picture p27: page 12]

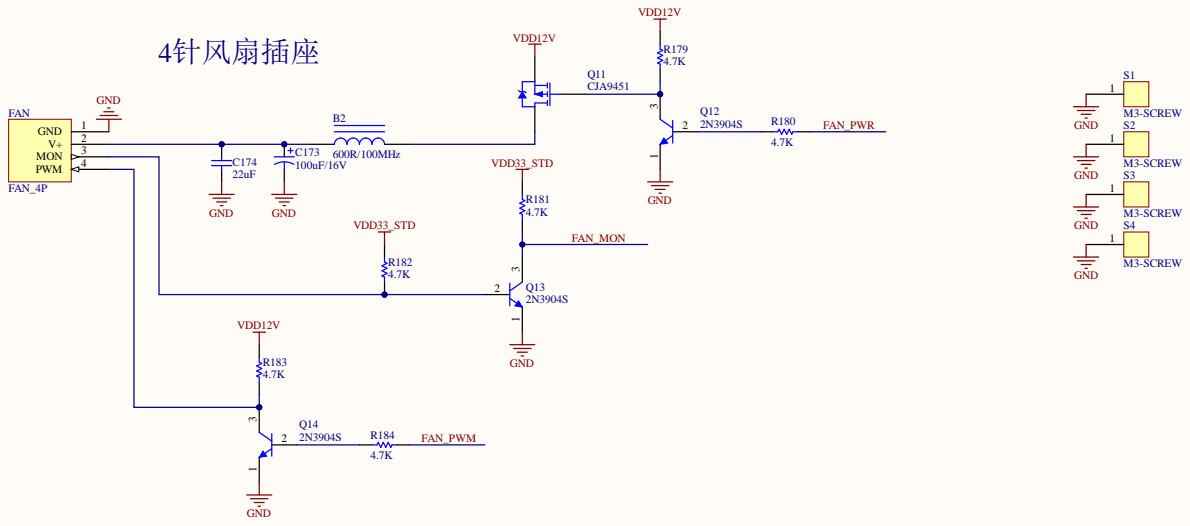
[picture p28: page 13]
