LAB5604/fpga_board/e4fpm7k325_mmb/docs/E4FPMK7_676_Schematic_English.pdf

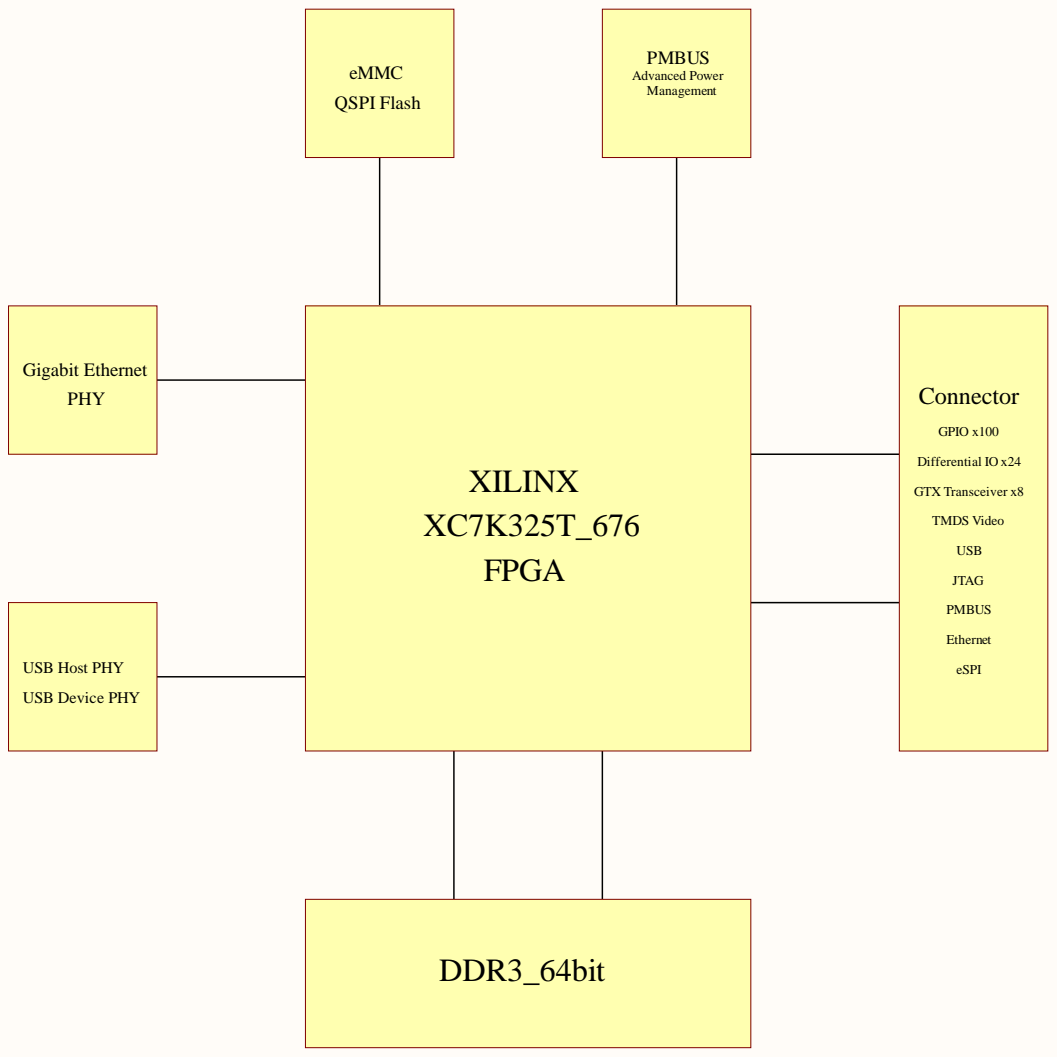
[picture p29: page 1]

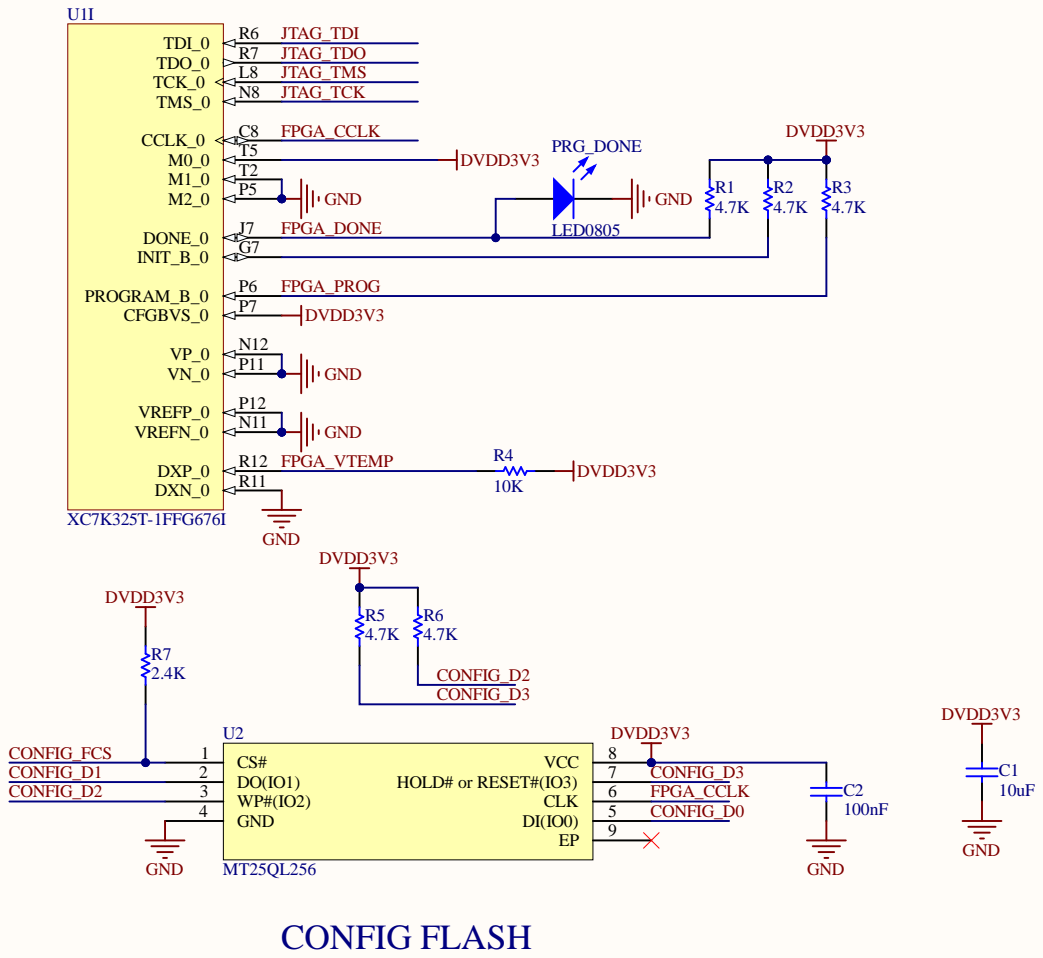
[picture p30: page 2]

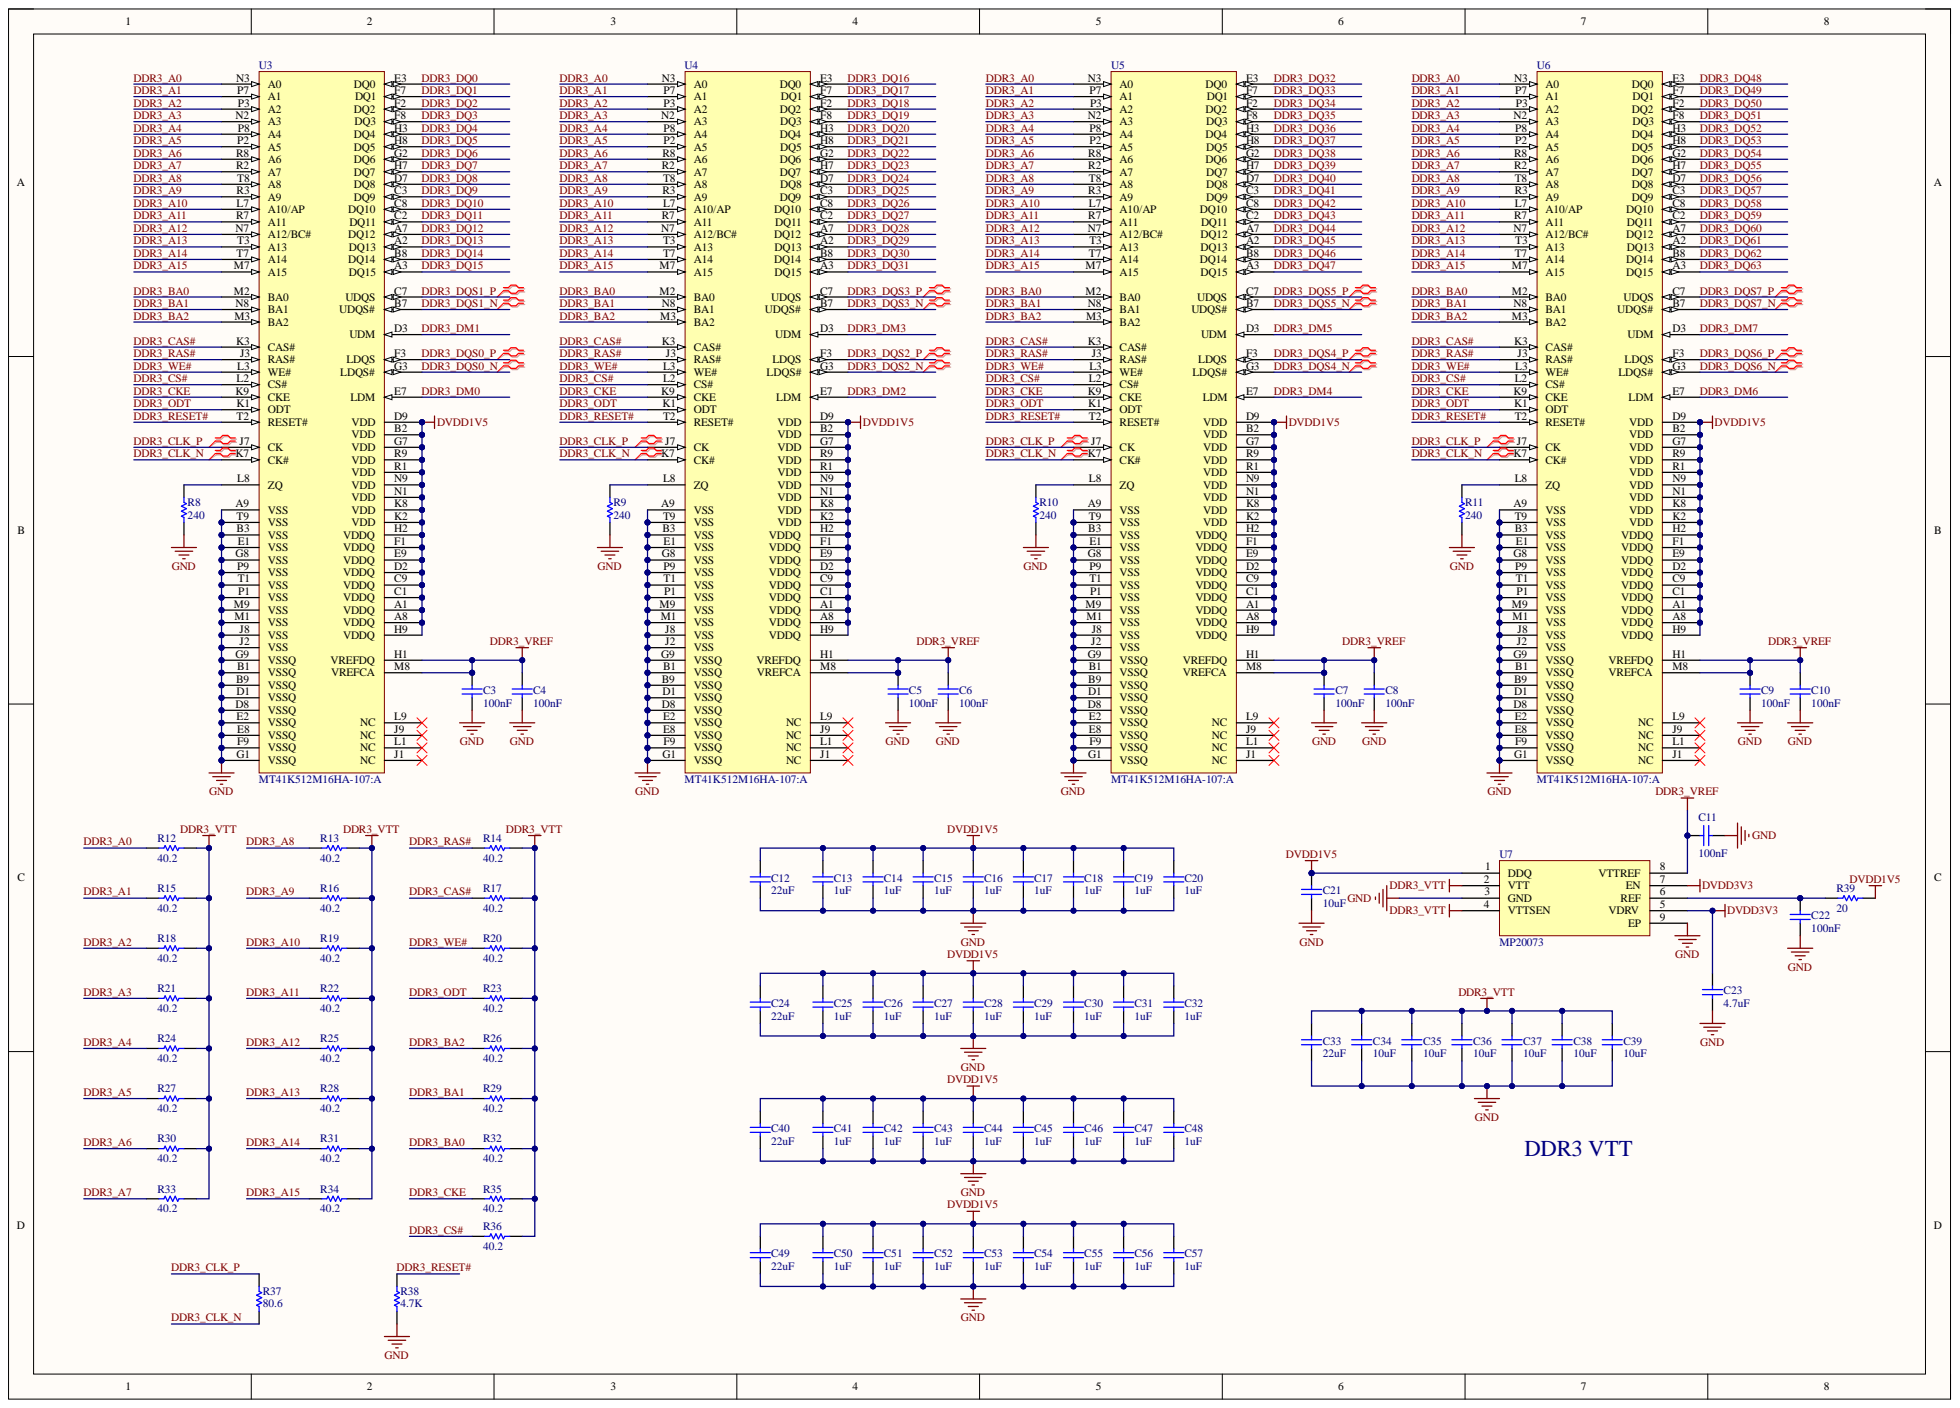
[picture p31: page 3]

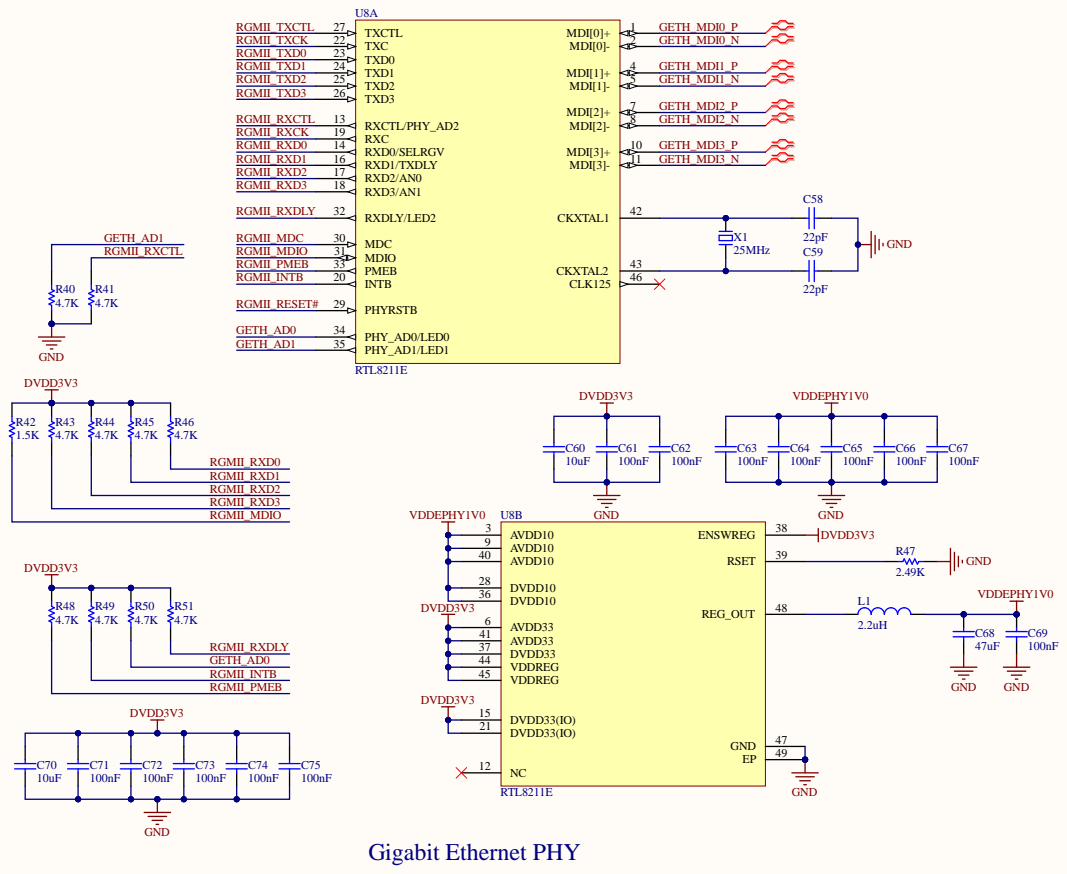
[picture p32: page 4]

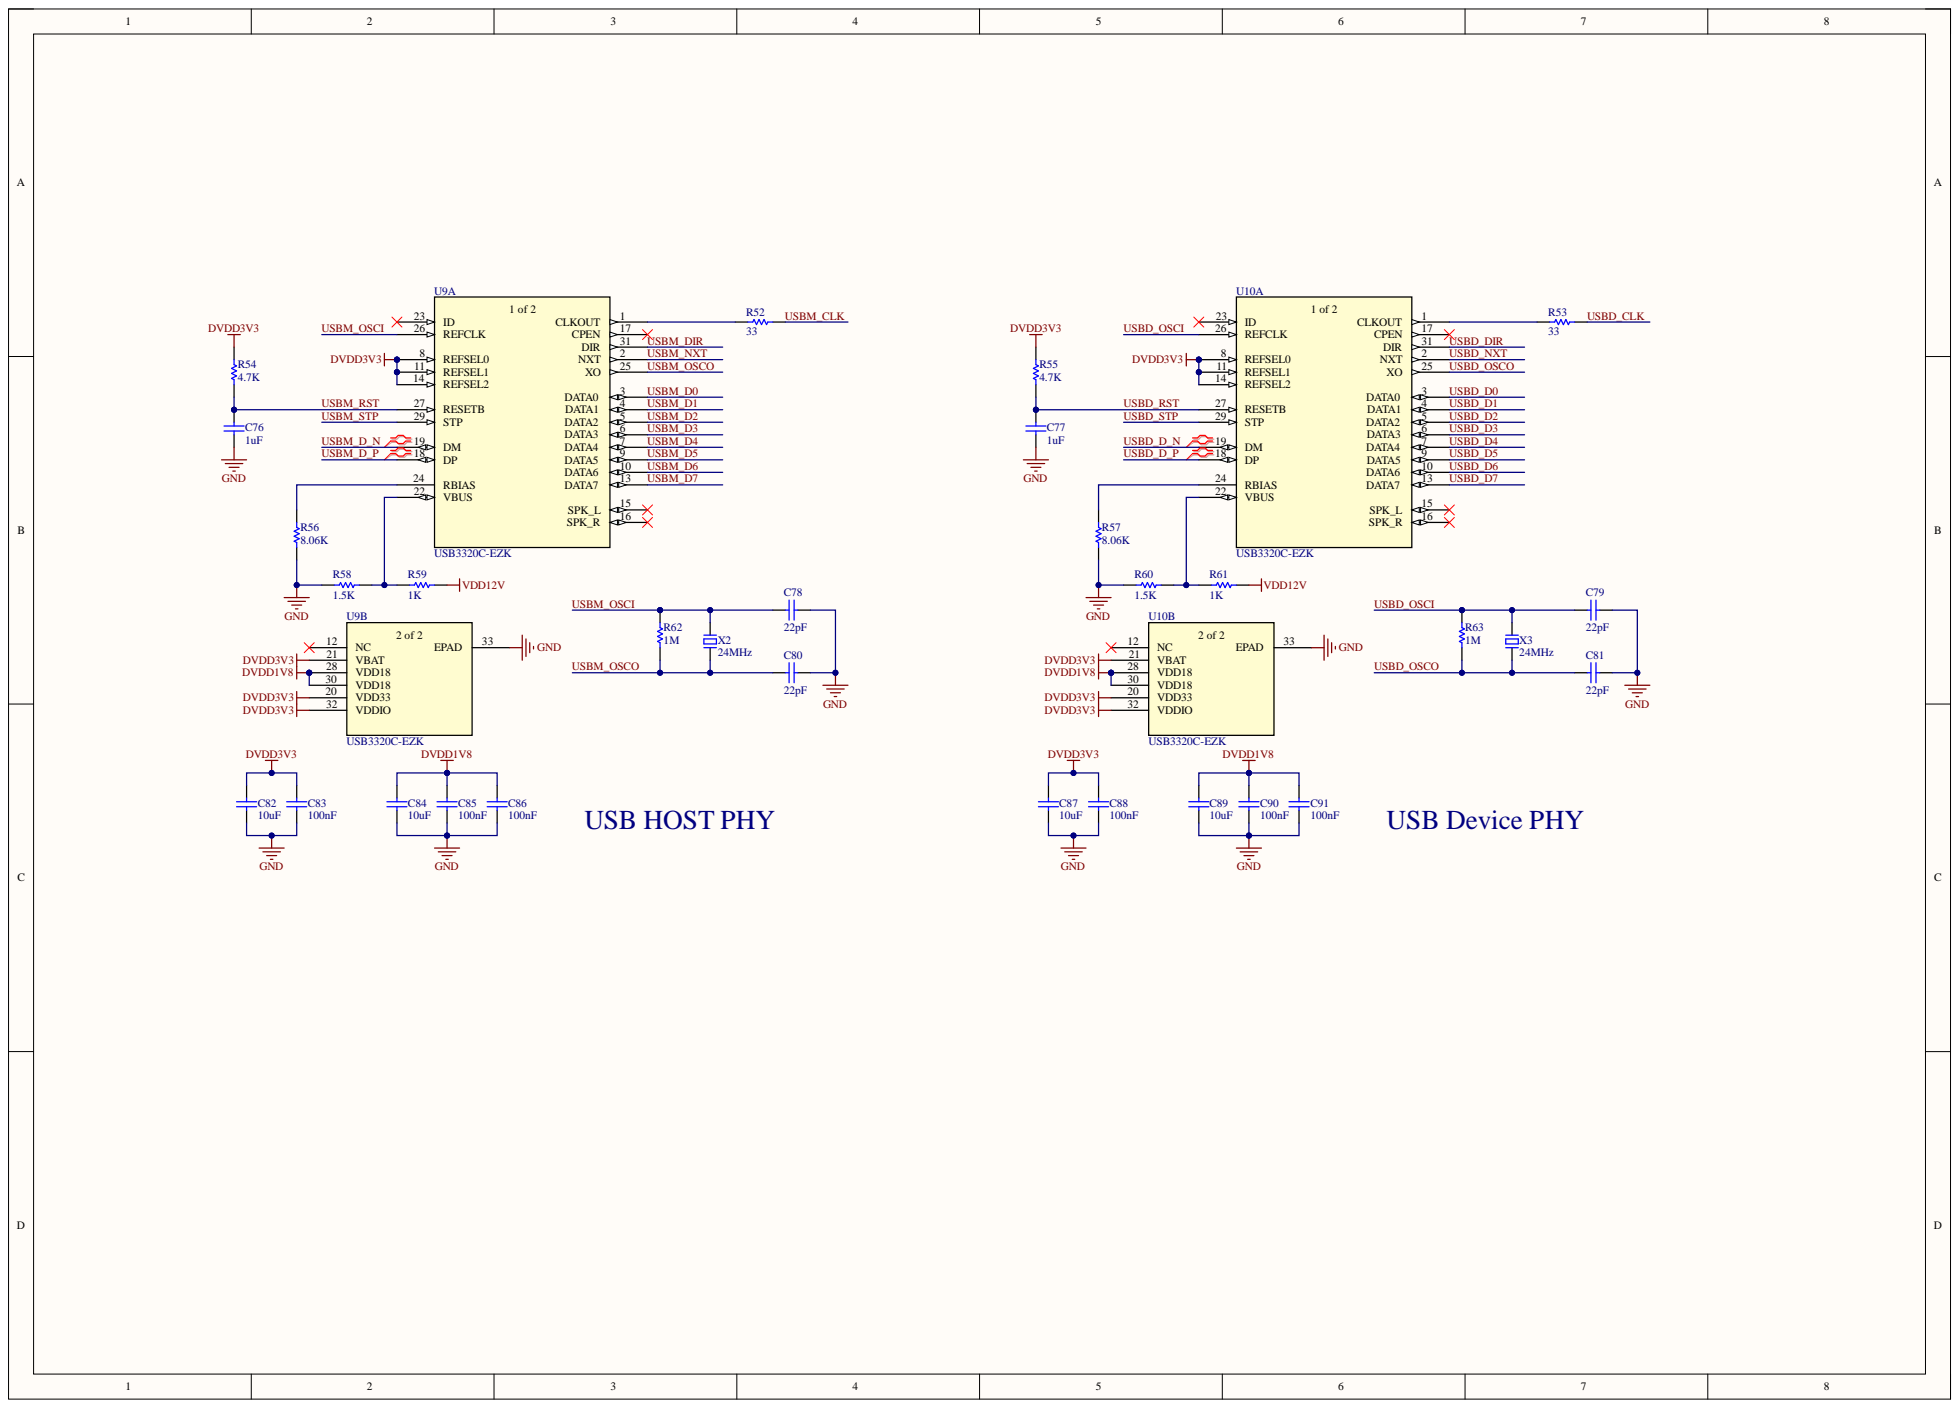
[picture p33: page 5]

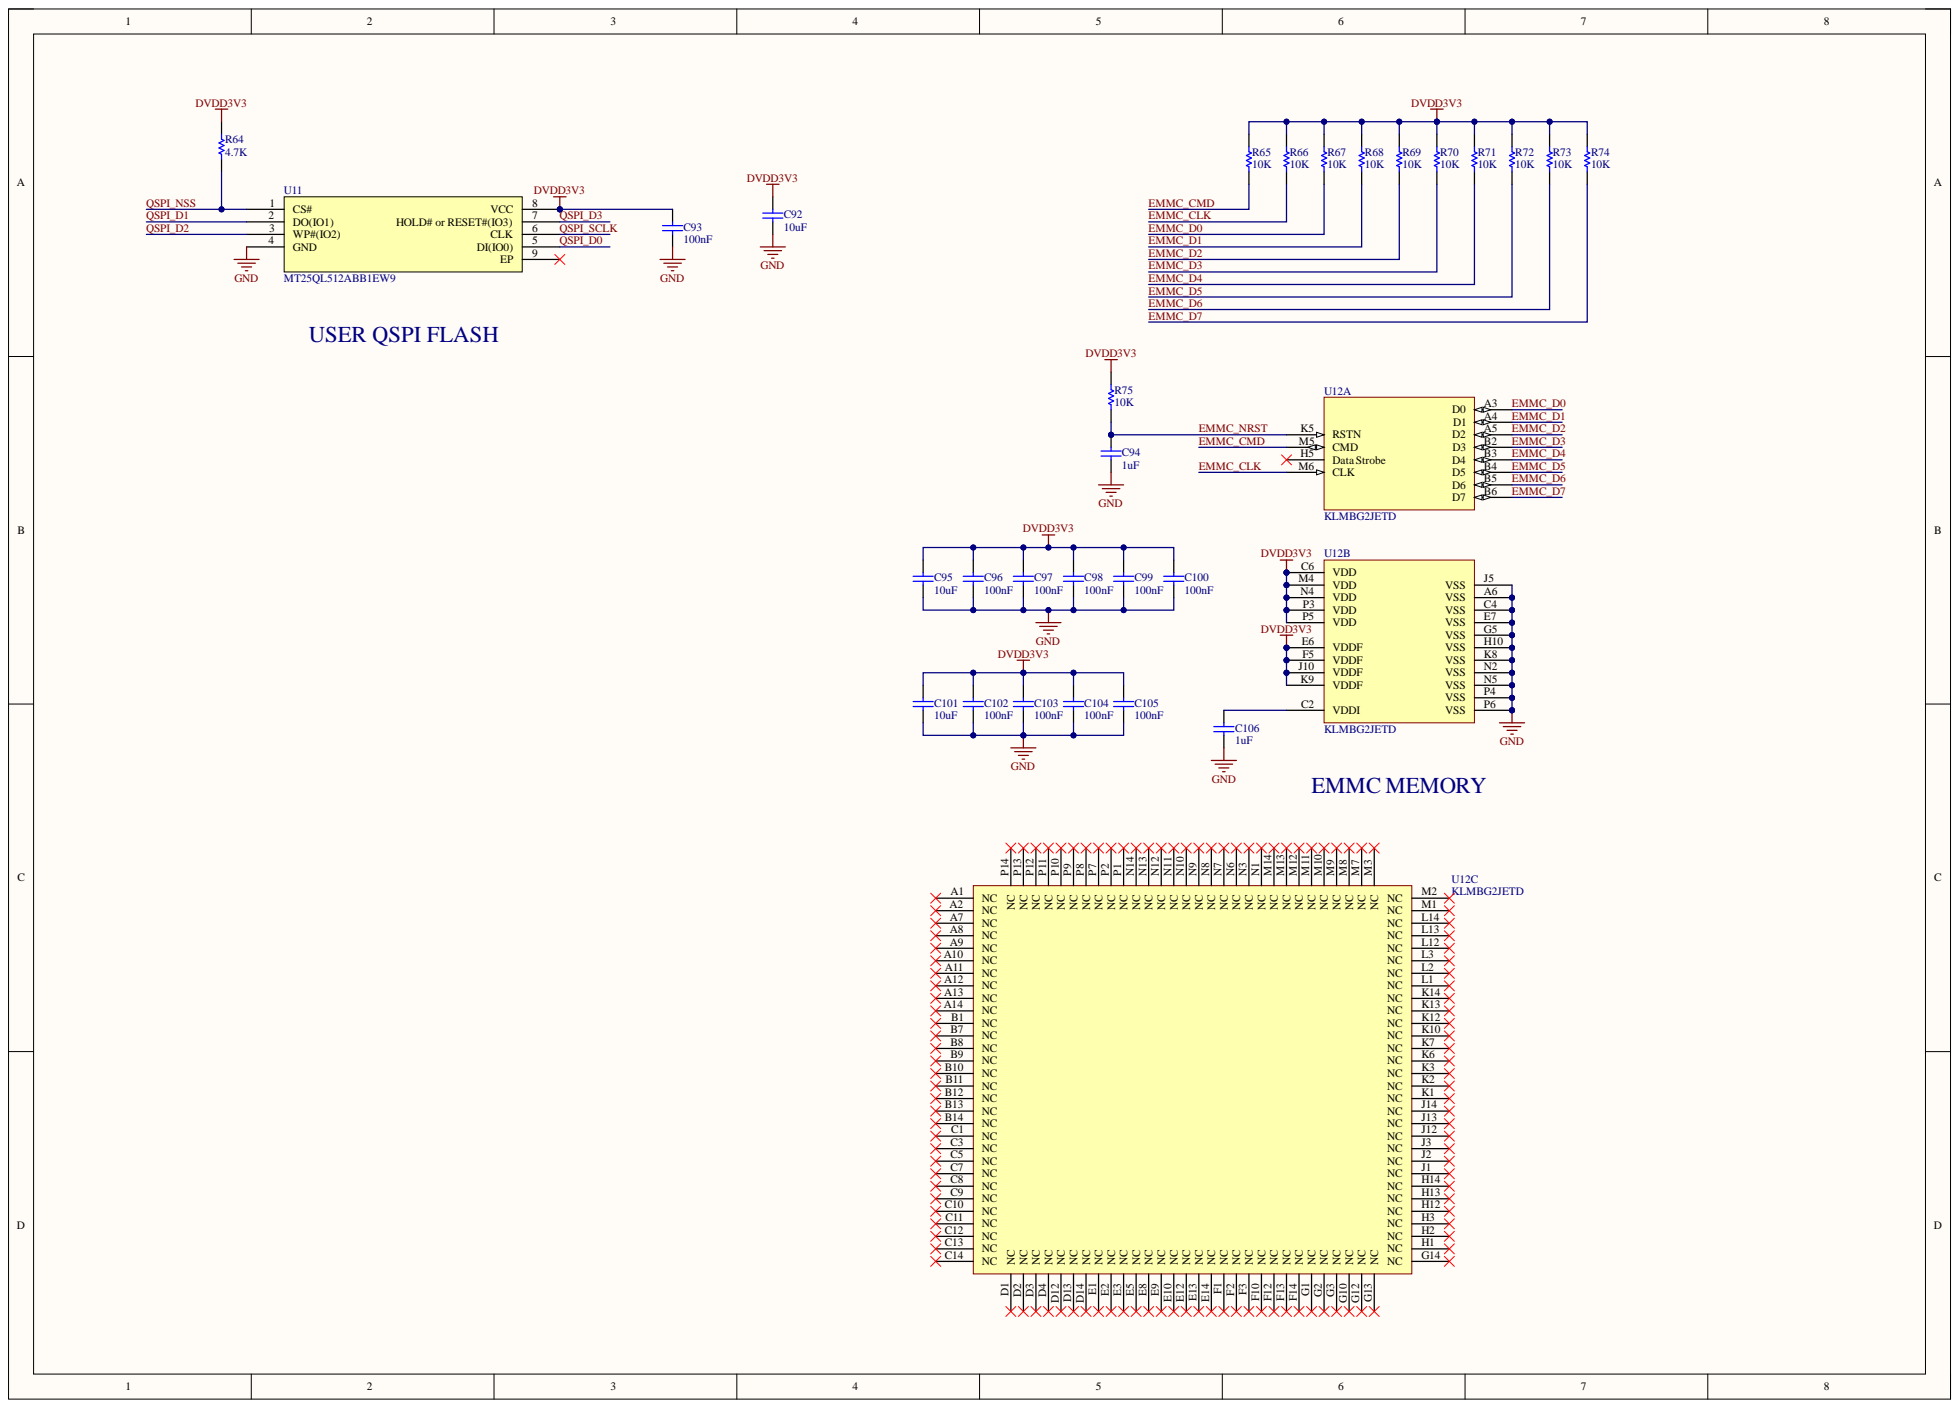
[picture p34: page 6]

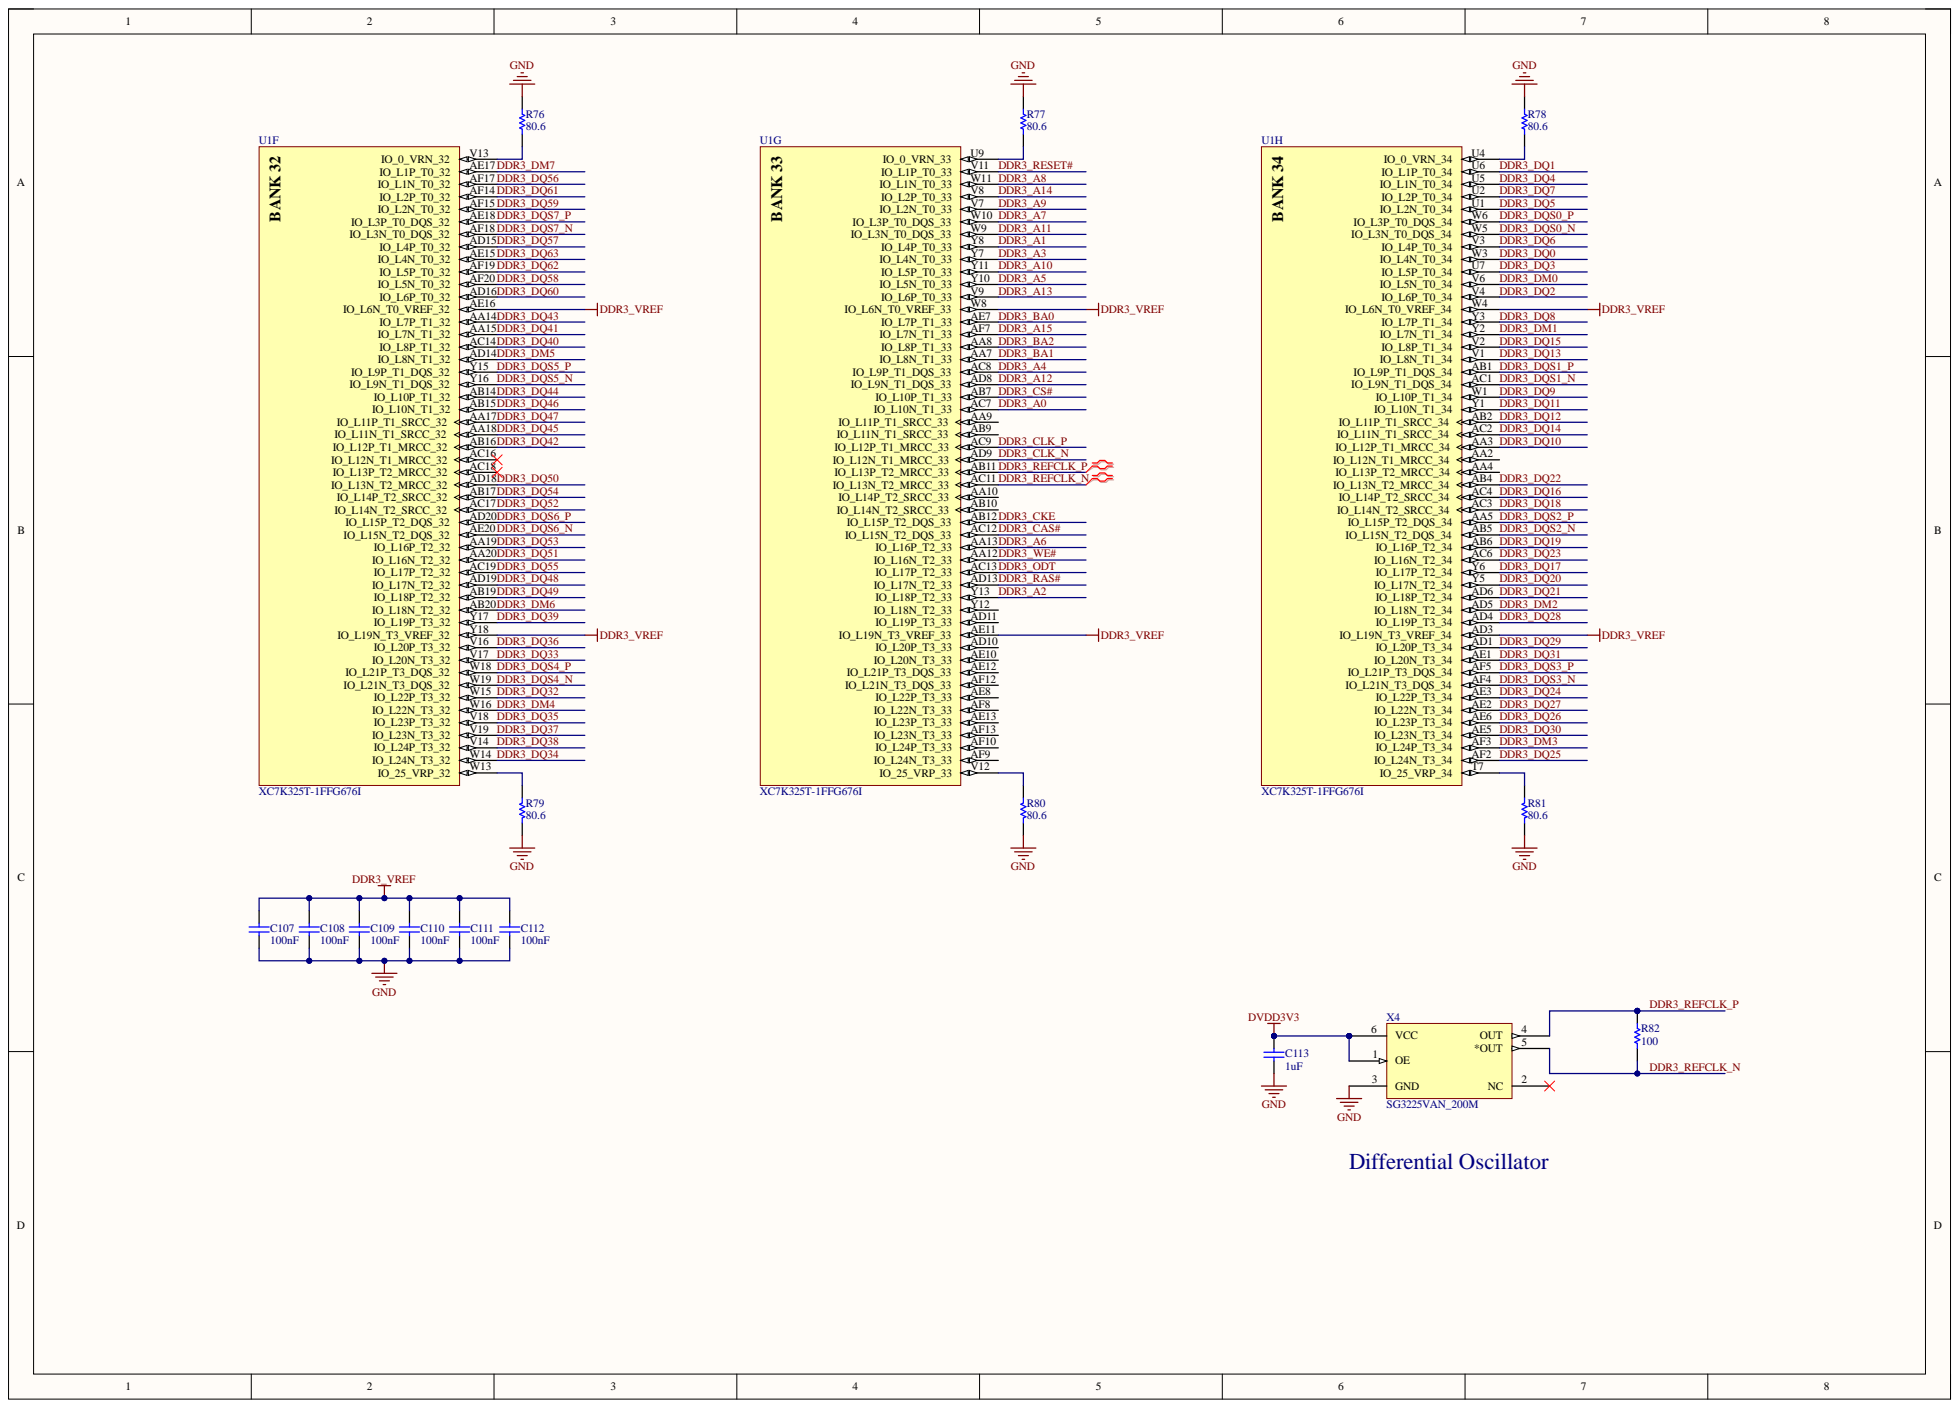
[picture p35: page 7]

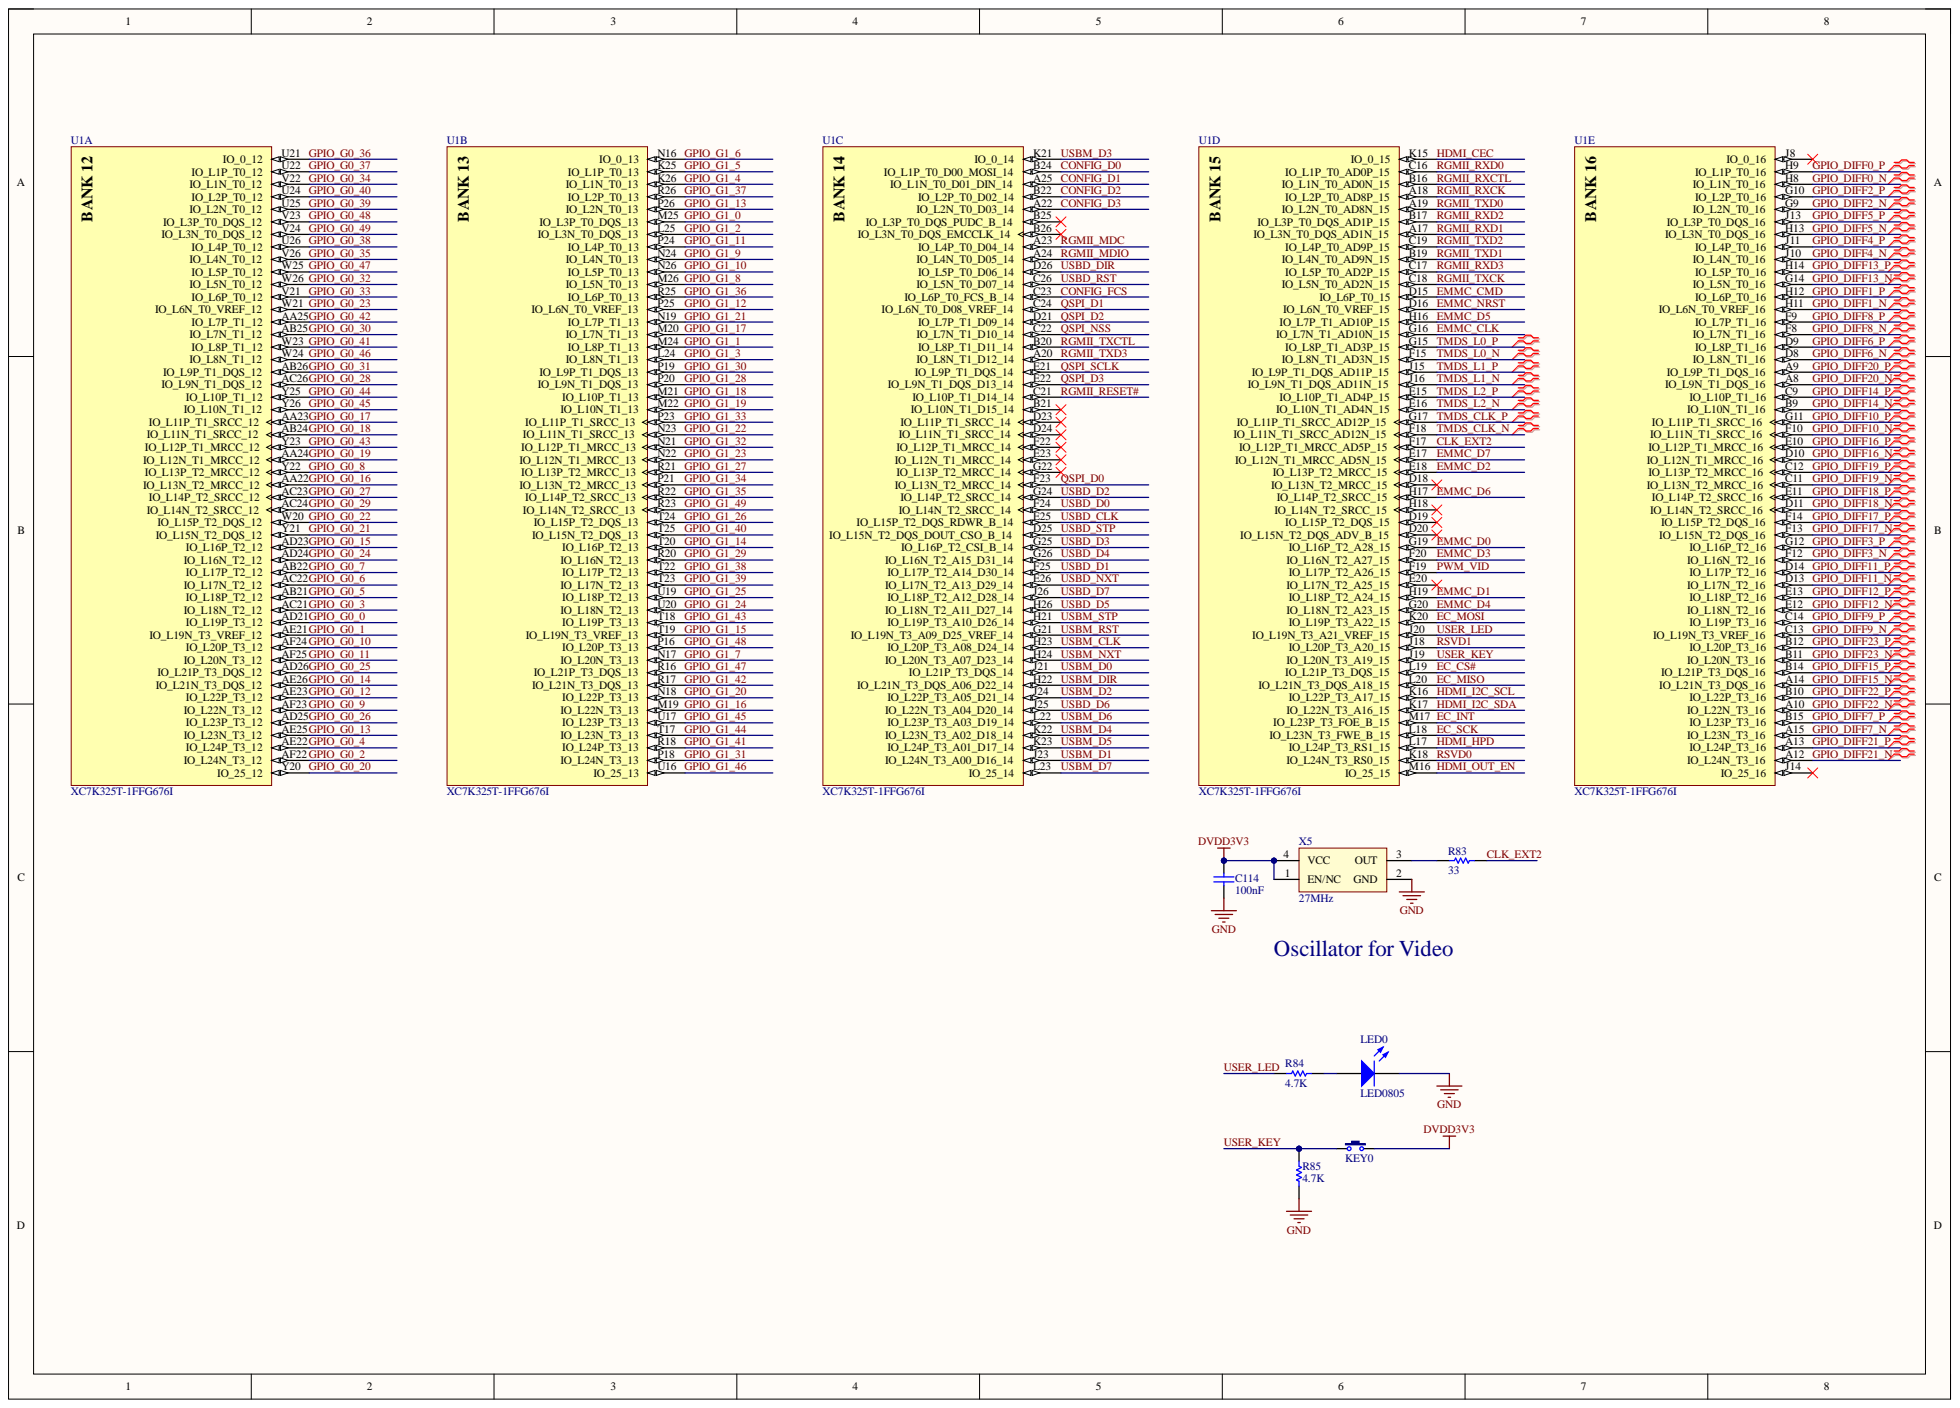
[picture p36: page 8]

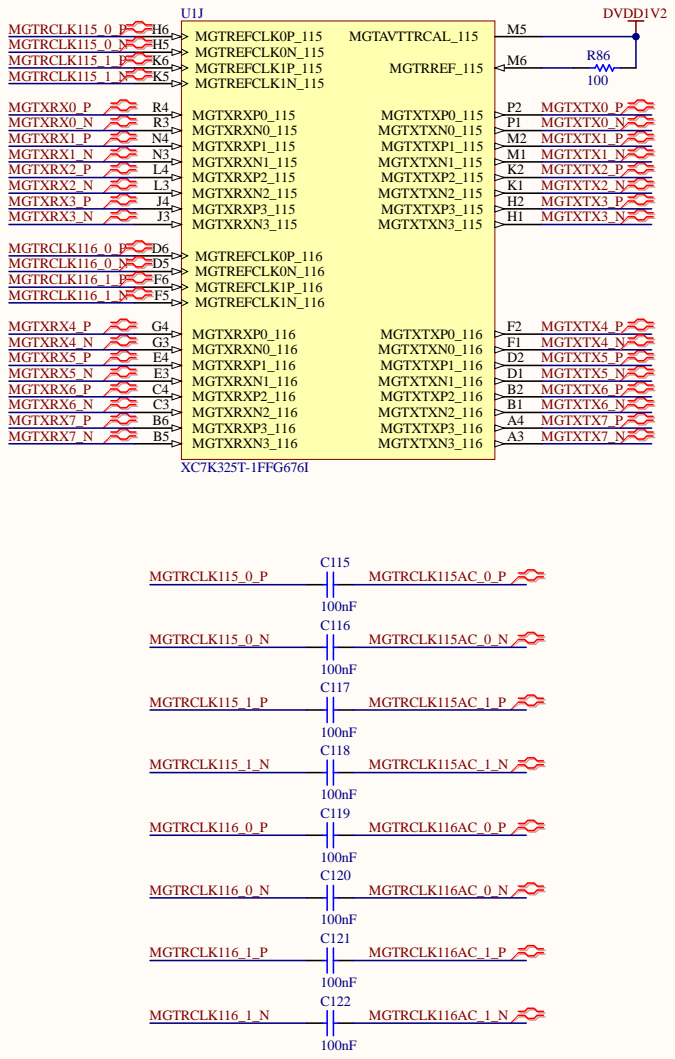
[picture p37: page 9]

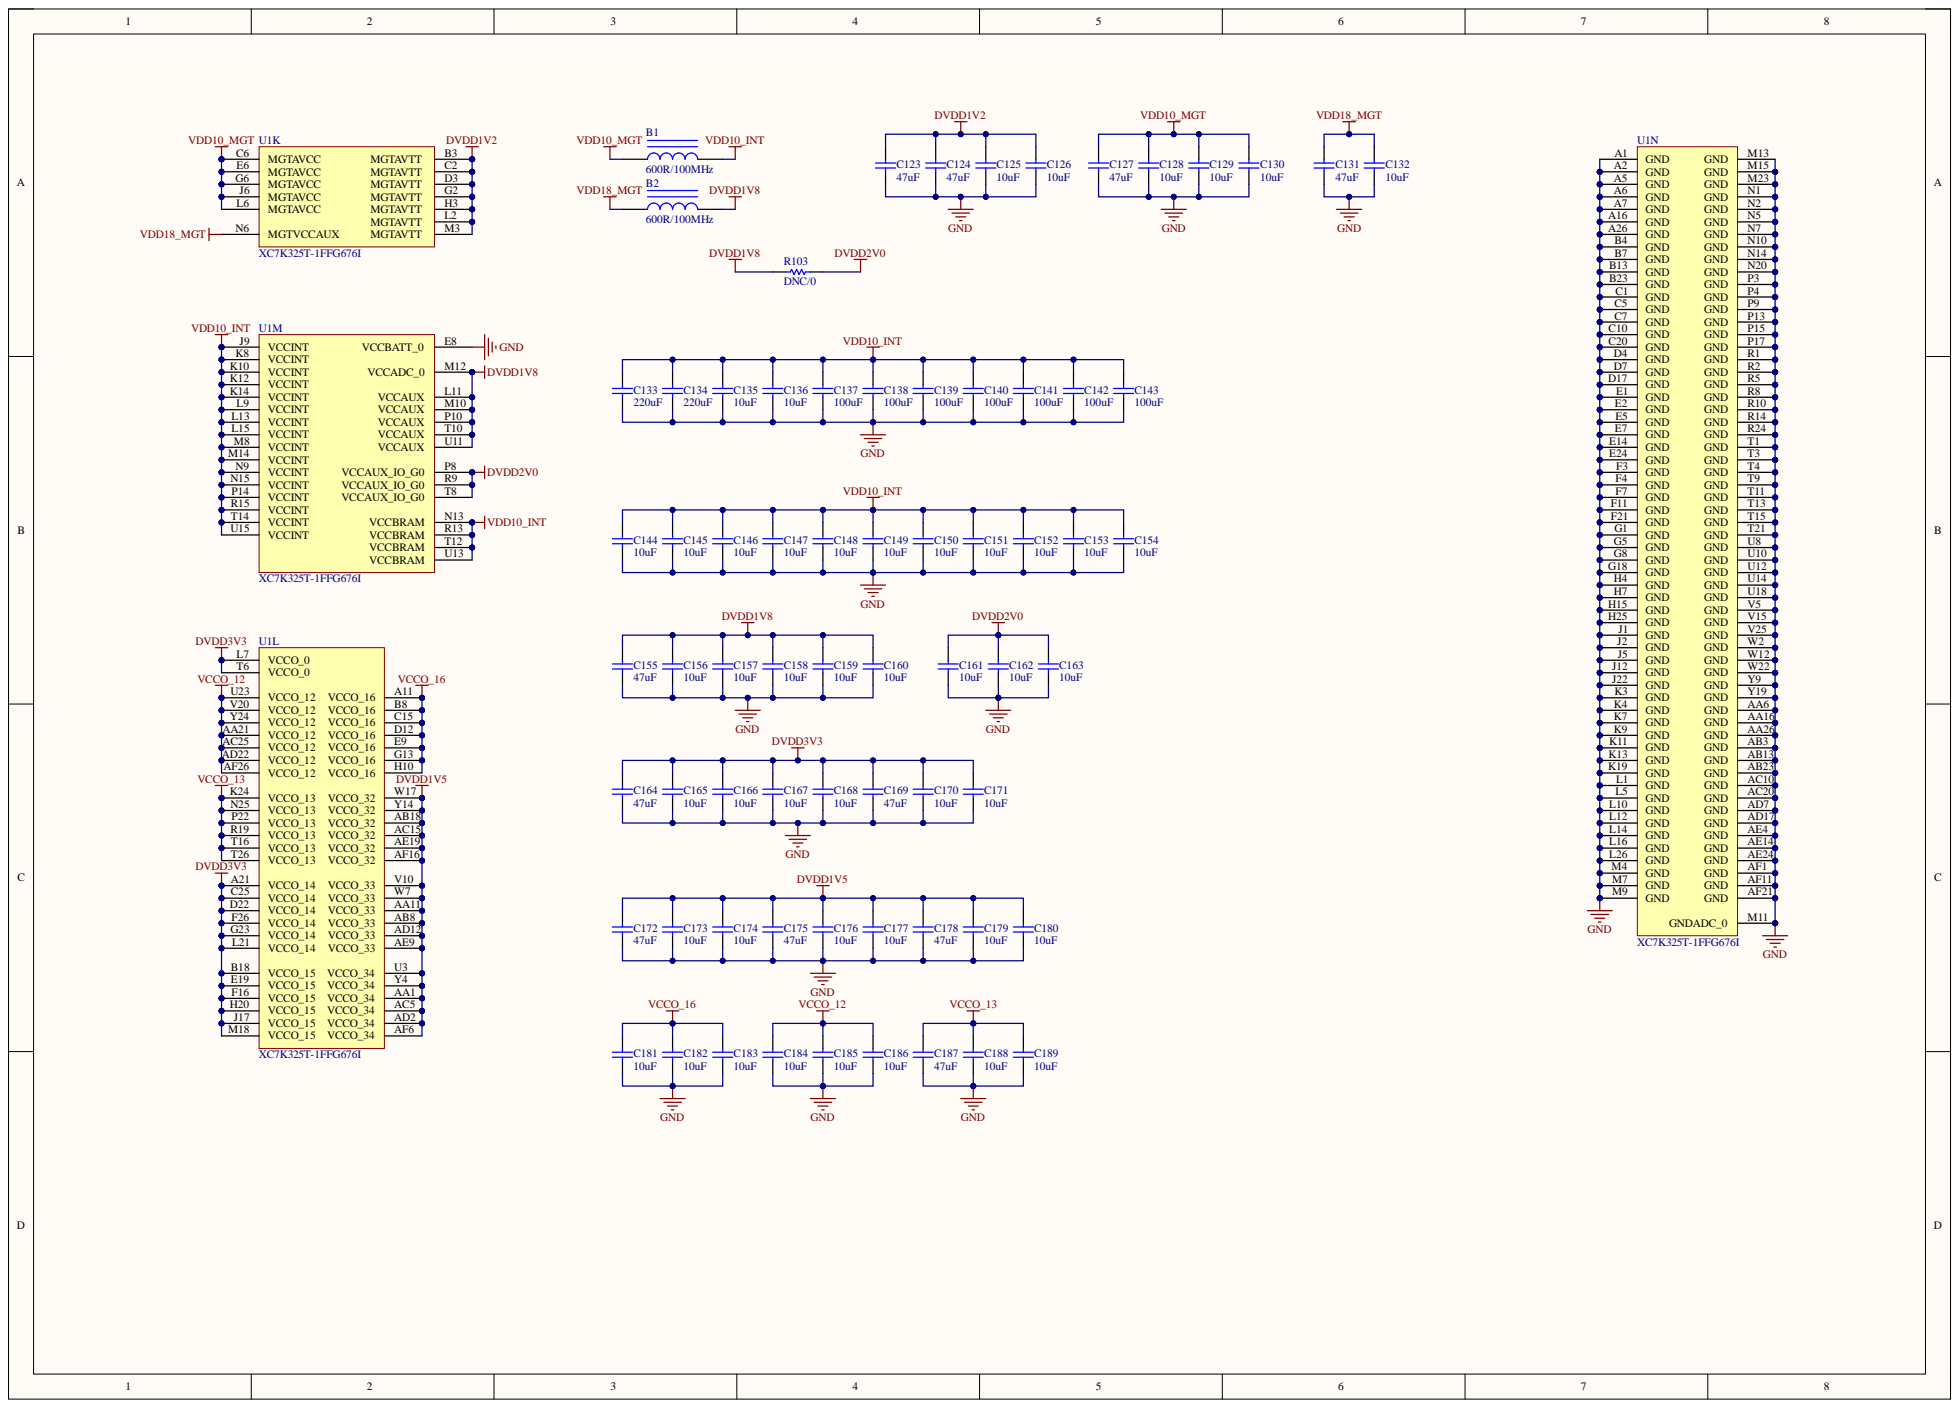
[picture p38: page 10]

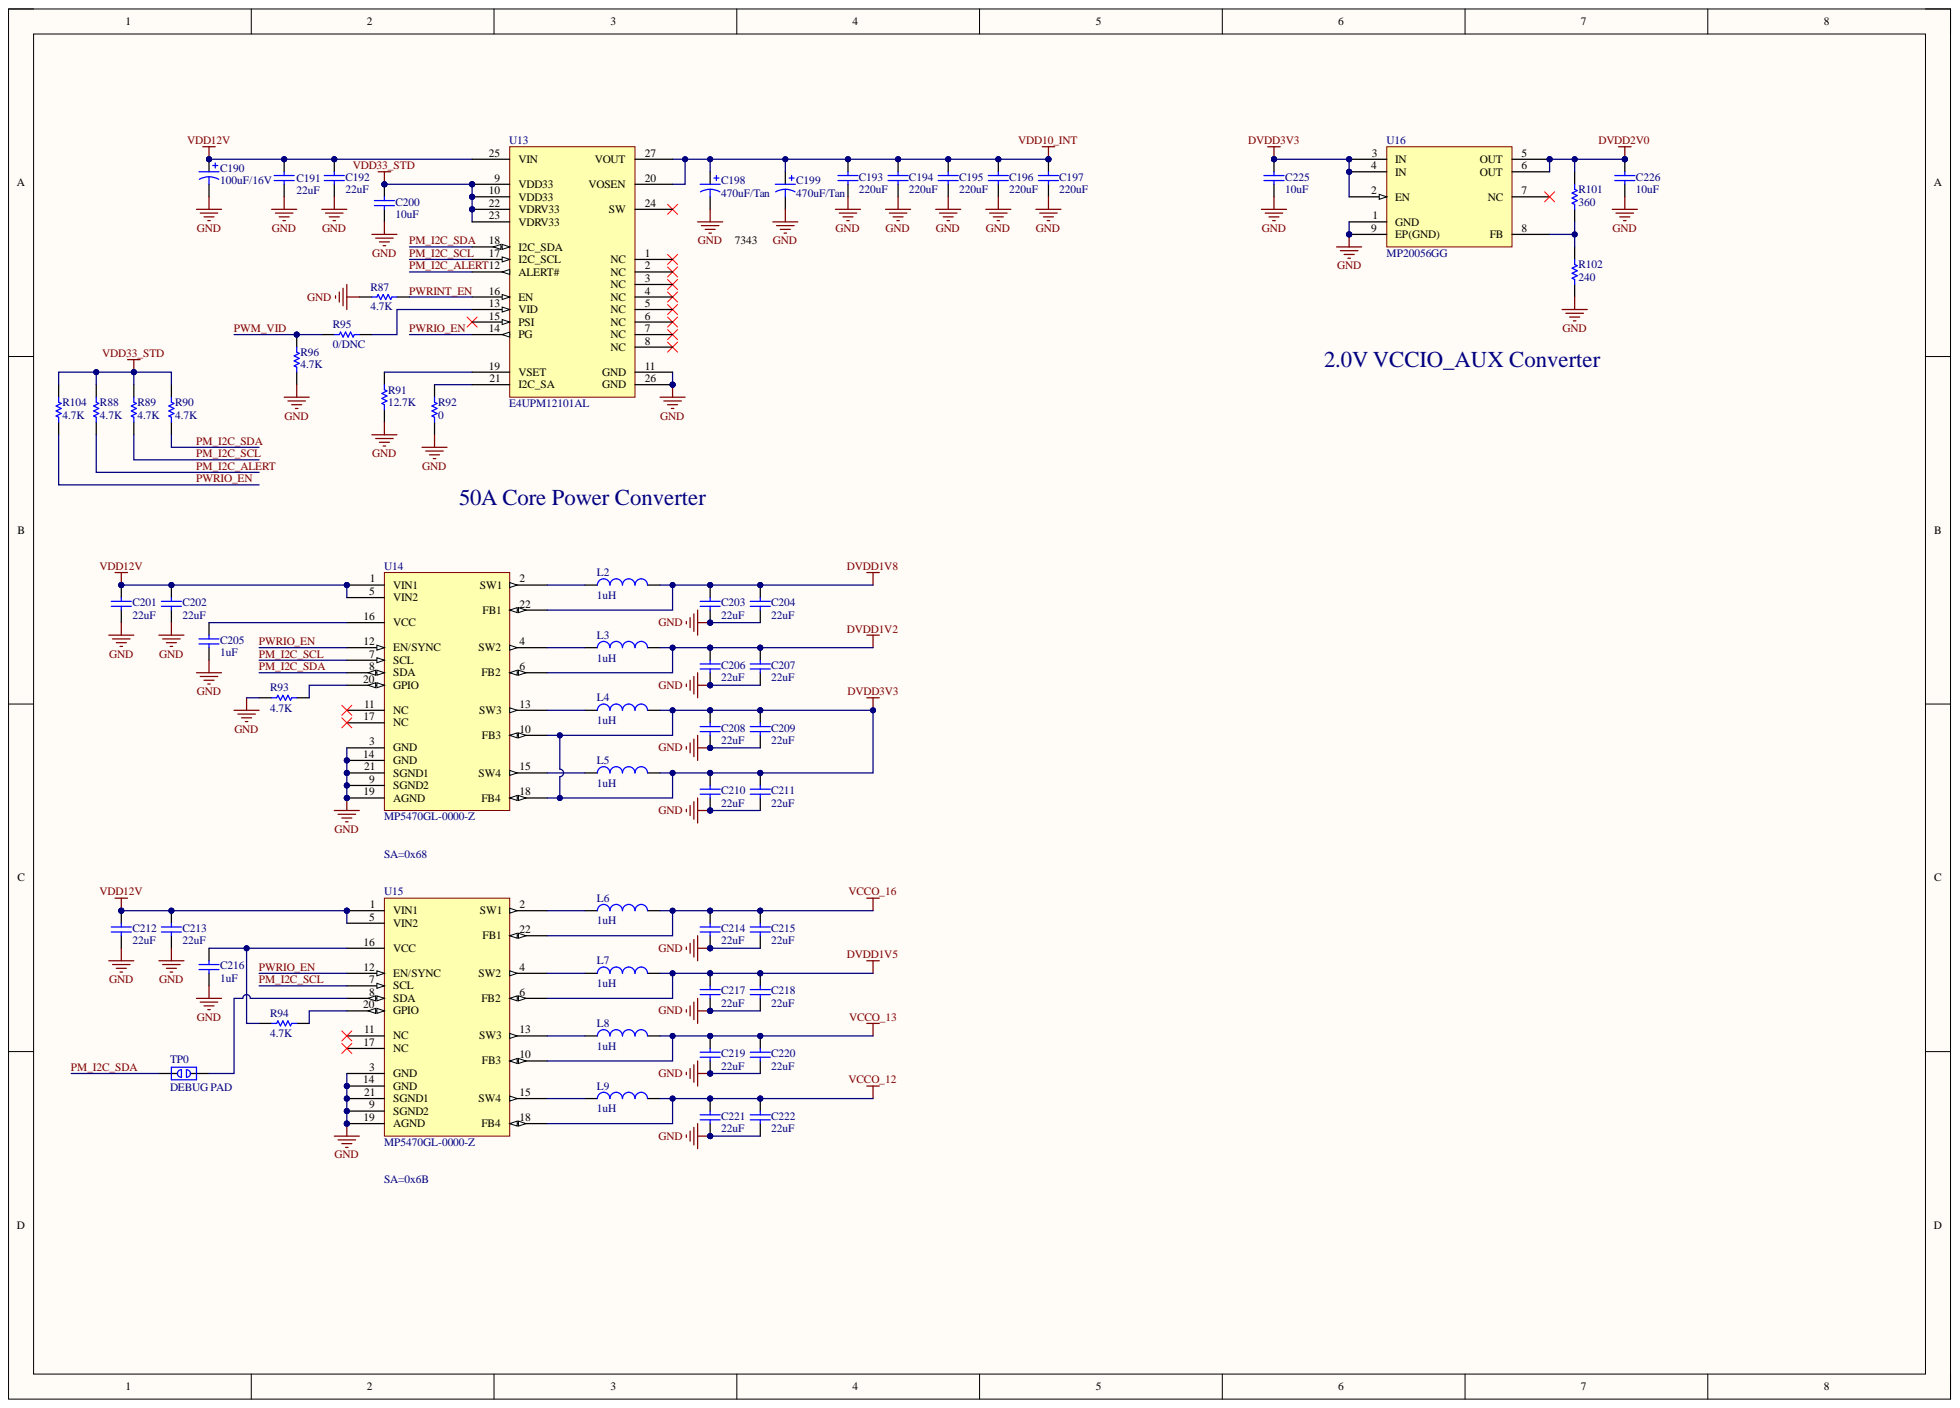
[picture p39: page 11]

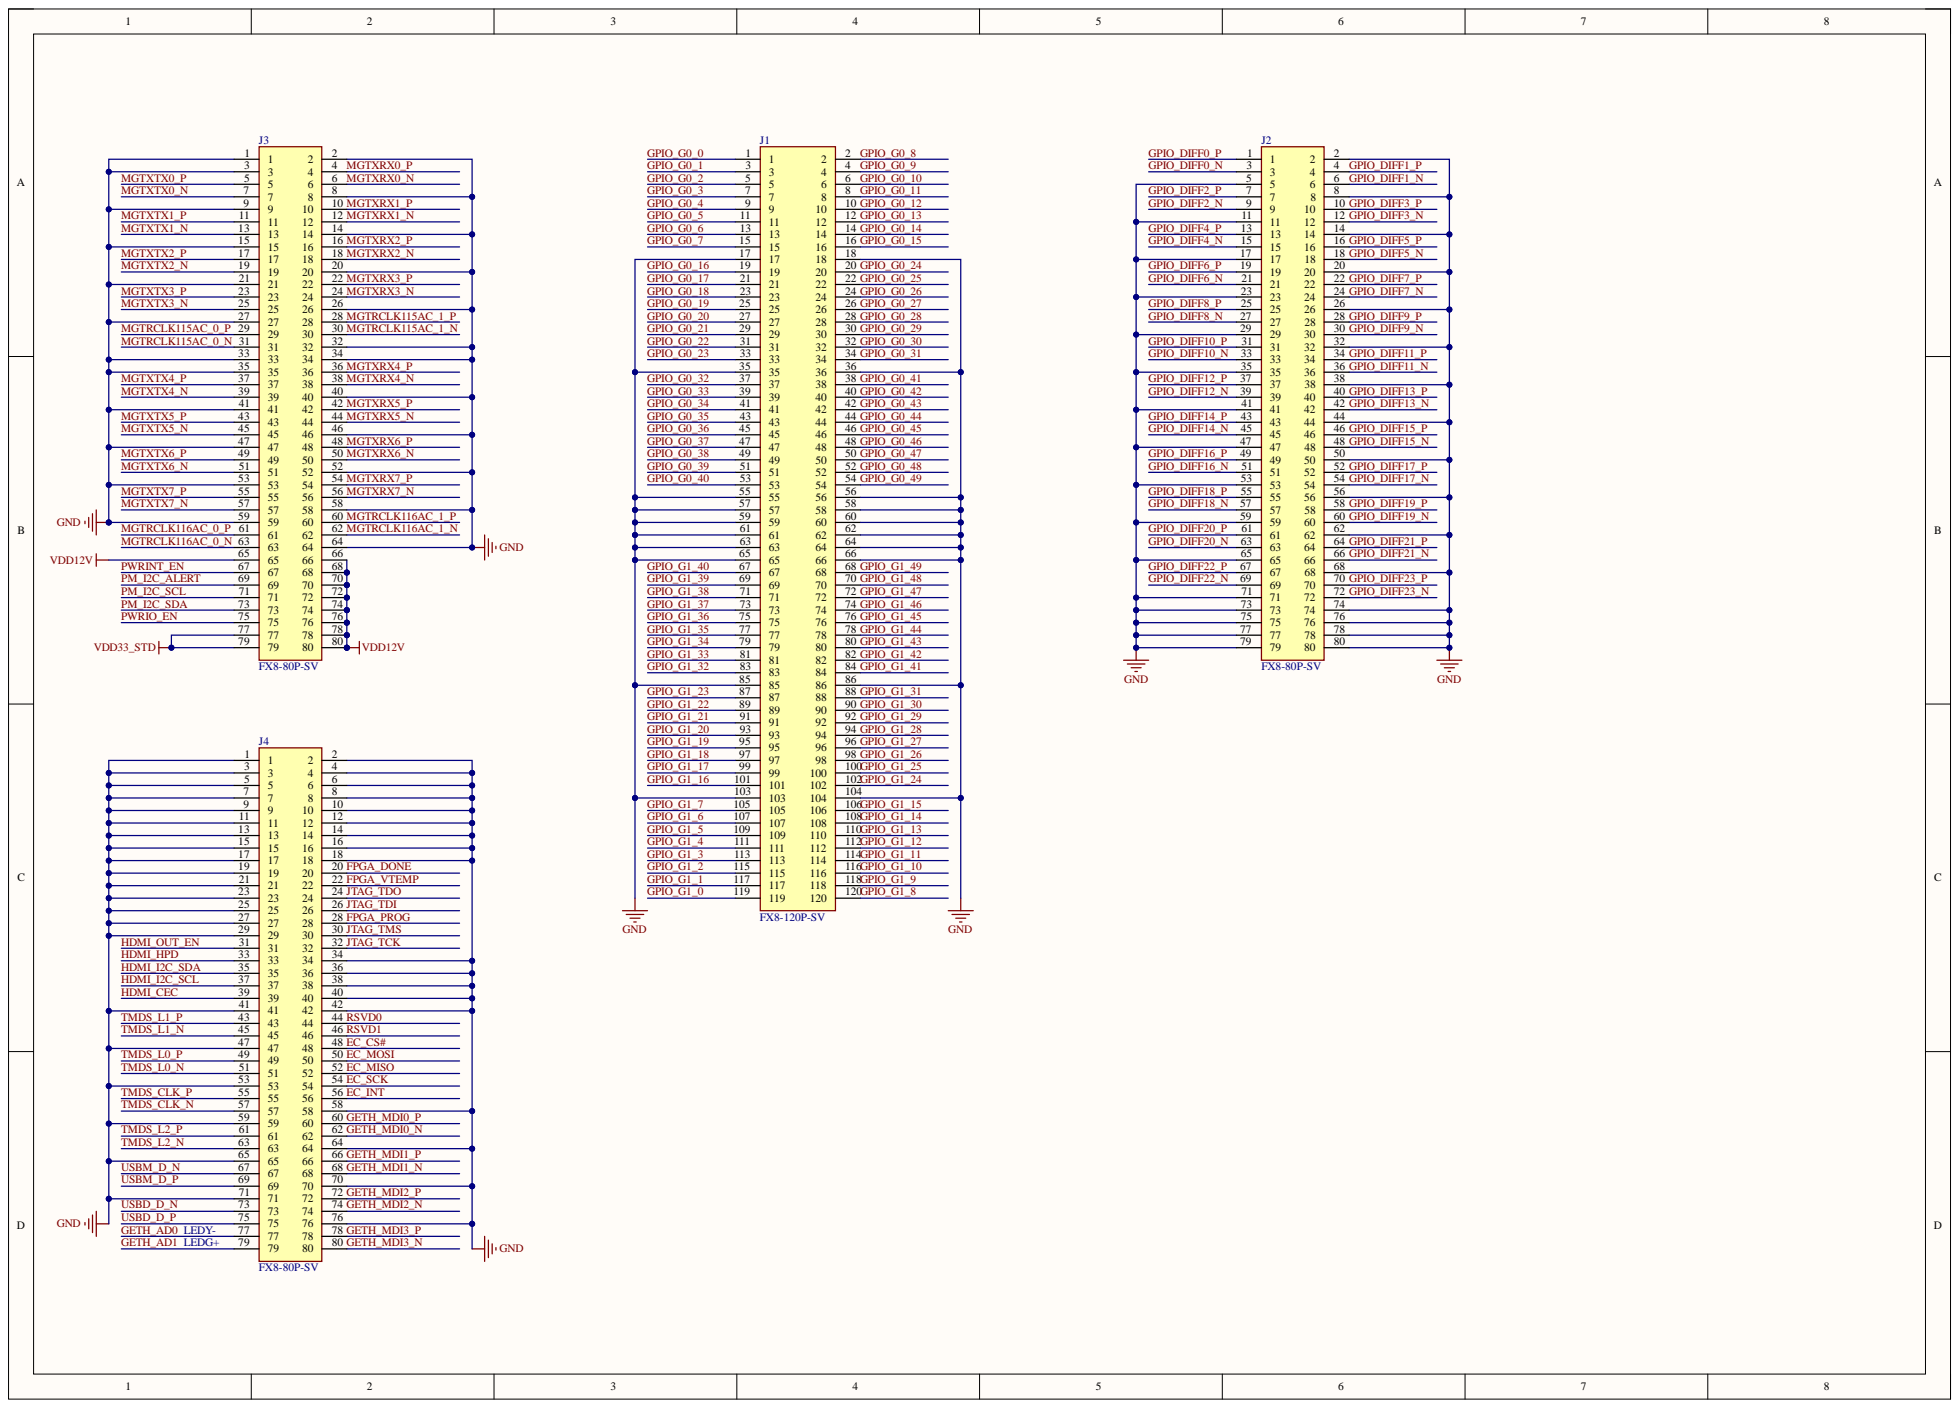
[picture p40: page 12]

GPI O_G1_23 GPI O_G1_22 GPI O_G1_21 GPI O_G1_20 GPI O_G1_19 GPI O_G1_18 GPI O_G1_17 GPI O_G1_16 | GPI O_G1_31 GPI O_G1_30 GPI O_G1_29 GPI O_G1_28 GPI O_G1_27 GPI O_G1_26 GPI O_G1_25 GPI O_G1_24

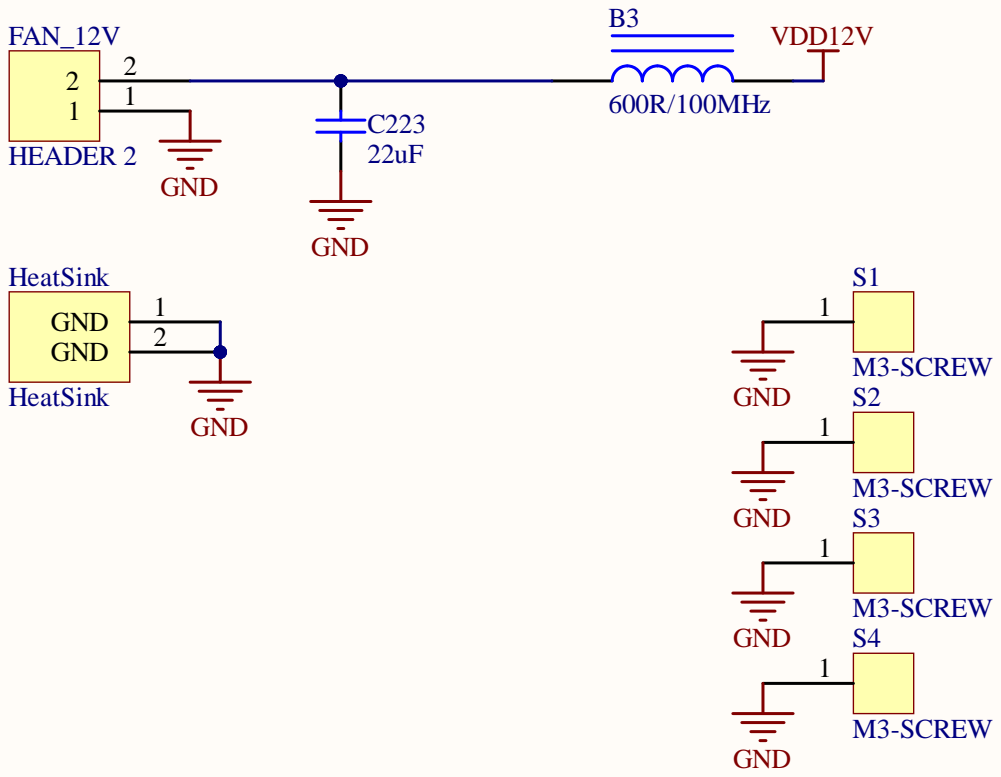
[picture p41: page 13]
