LAB5604/fpga_board/e4fpm7k325_mmb/docs/E4FPMK7_676核心板原理图中文版.pdf

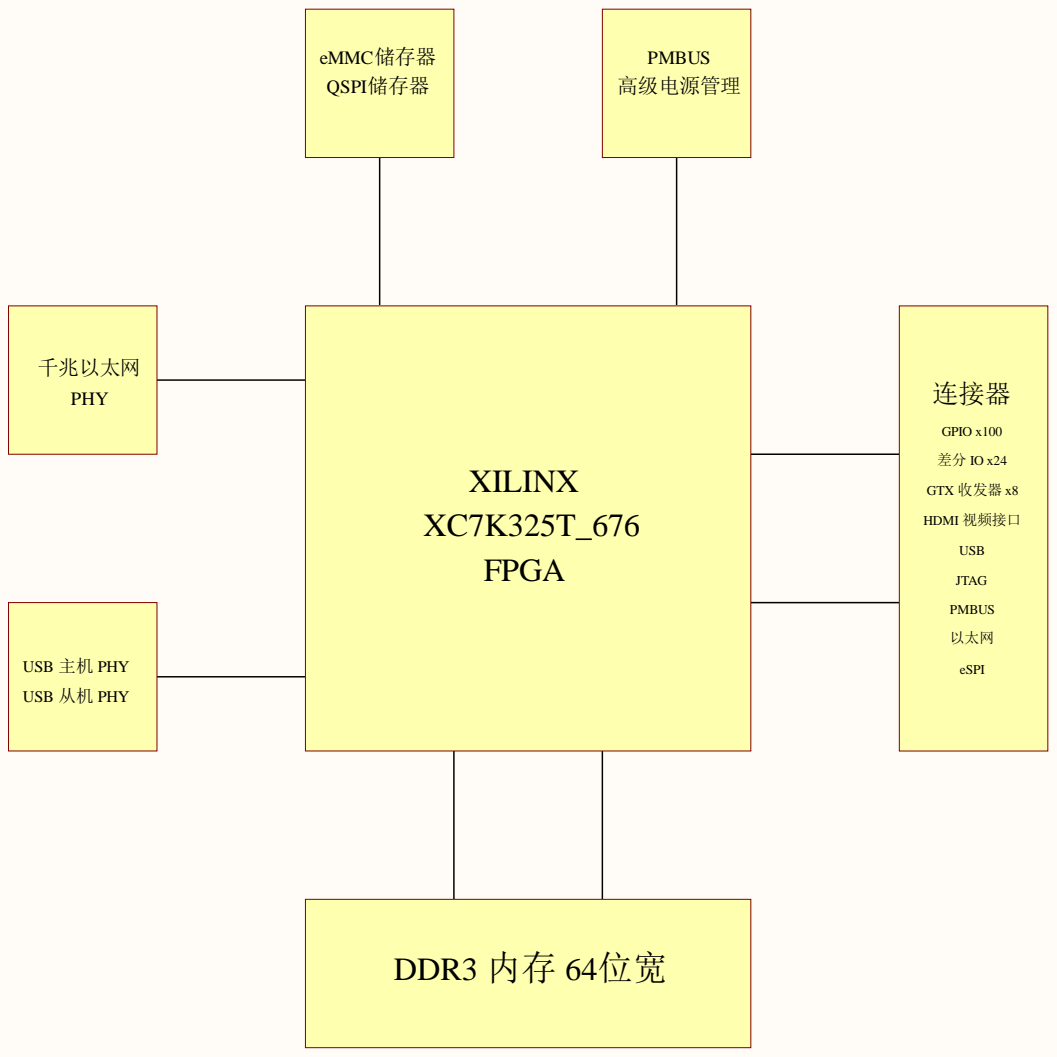
[picture p42: page 1]

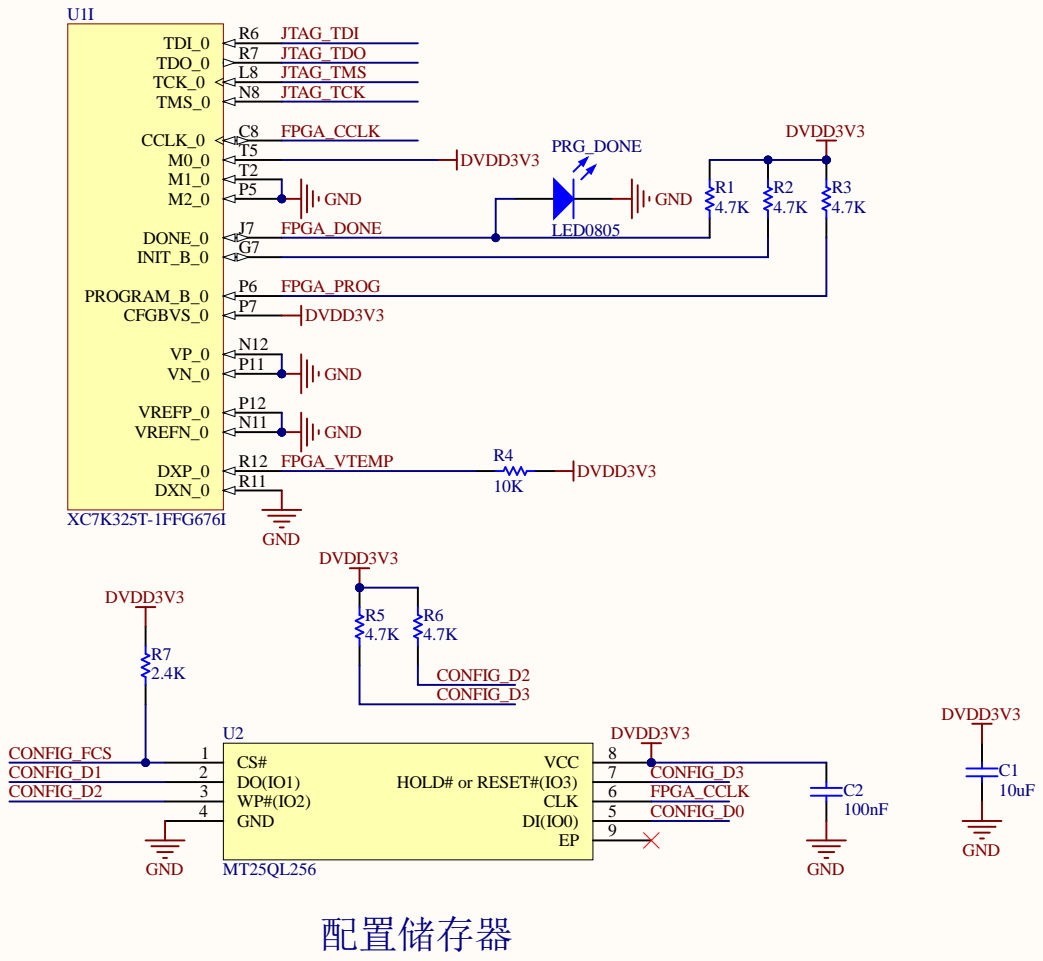
[picture p43: page 2]

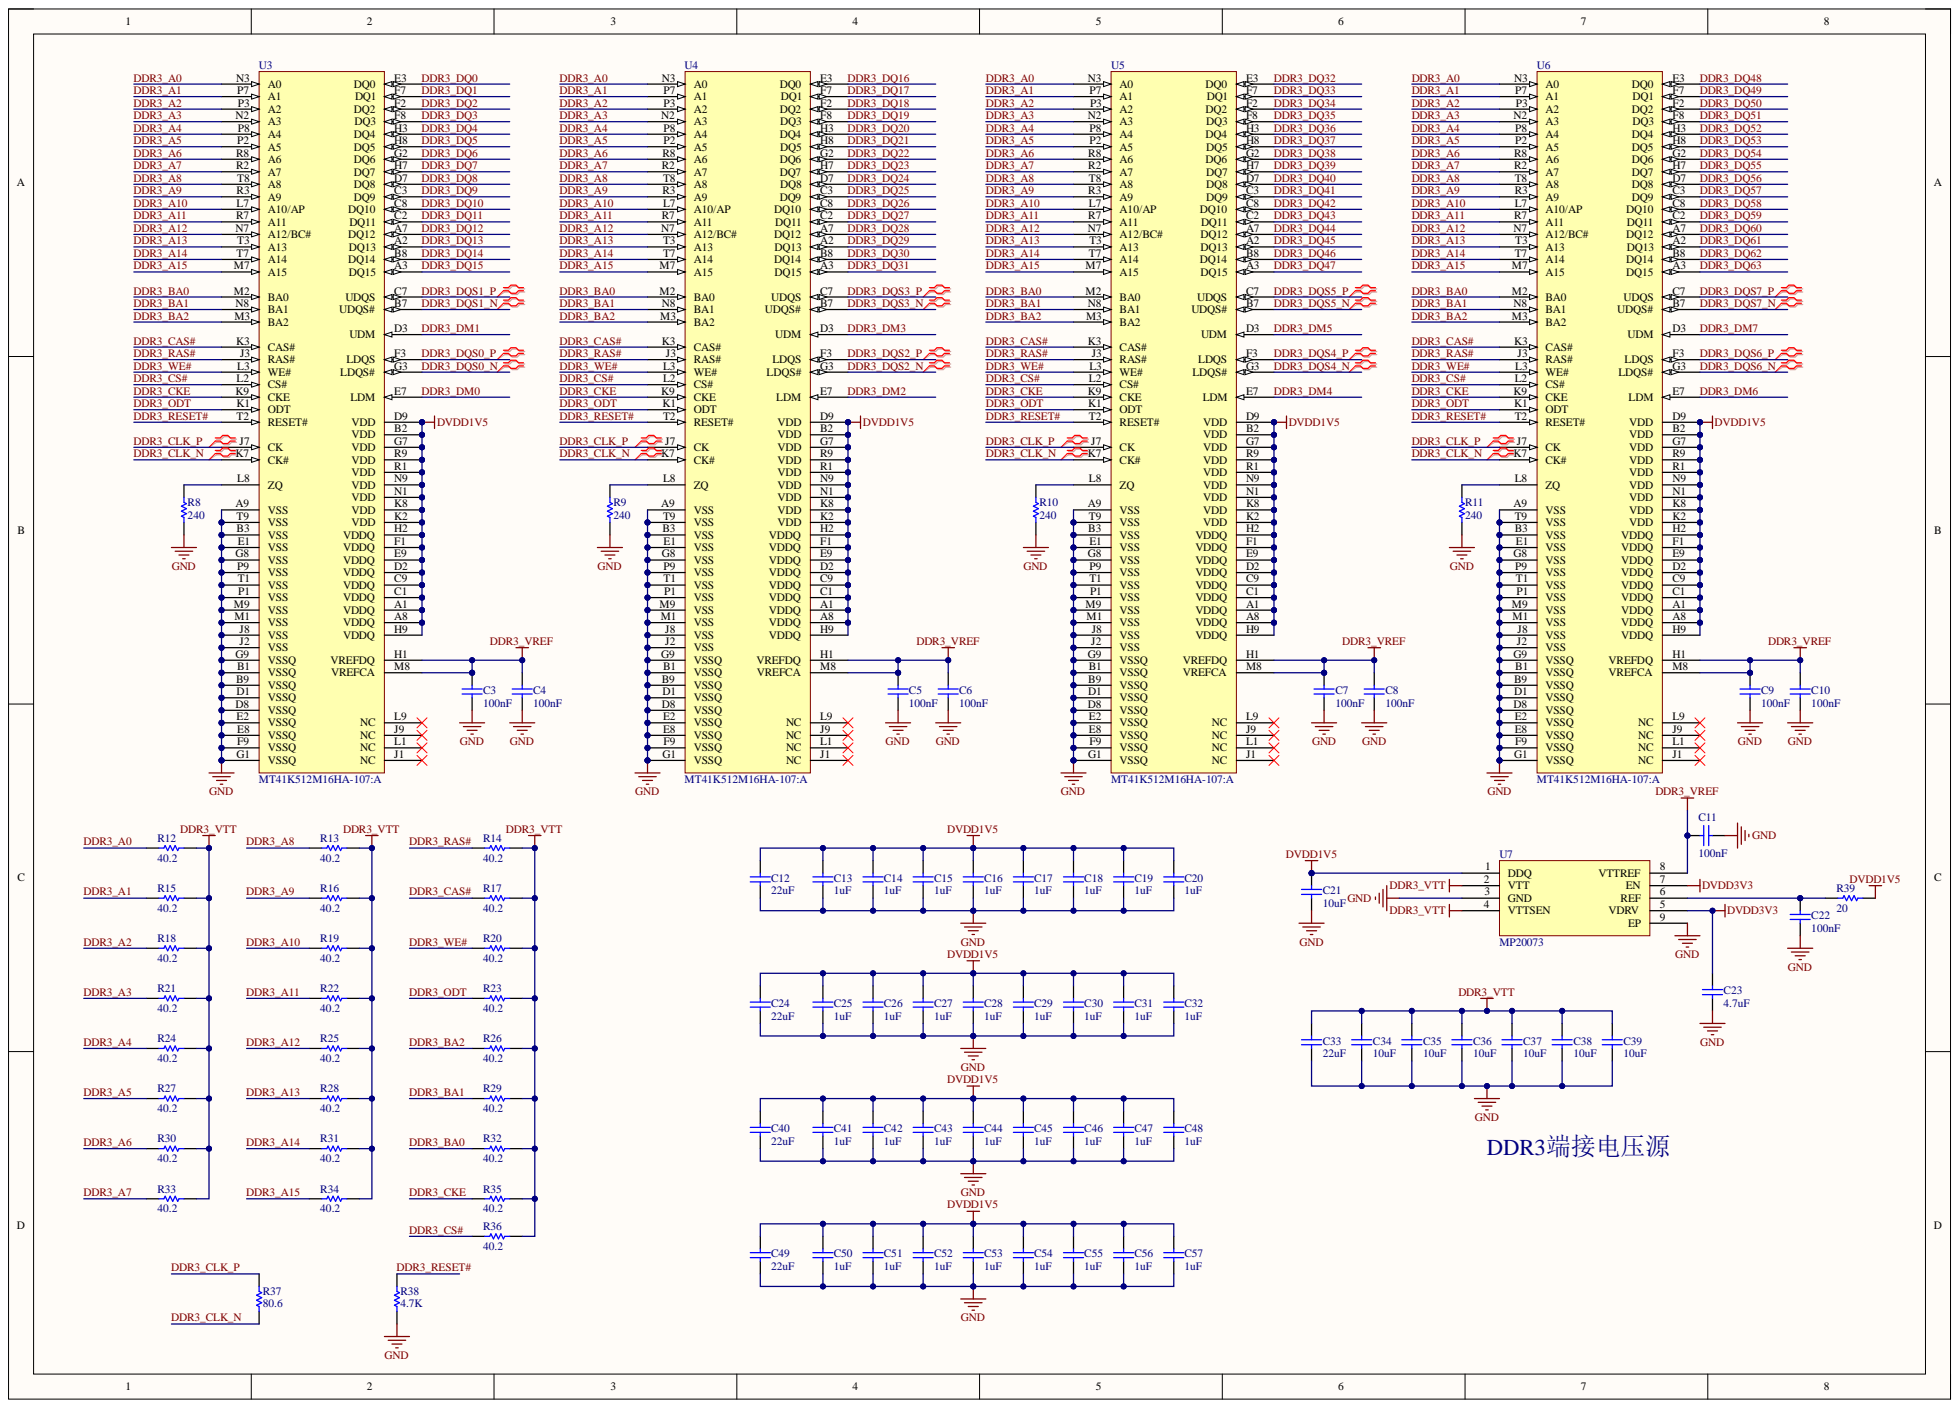
[picture p44: page 3]

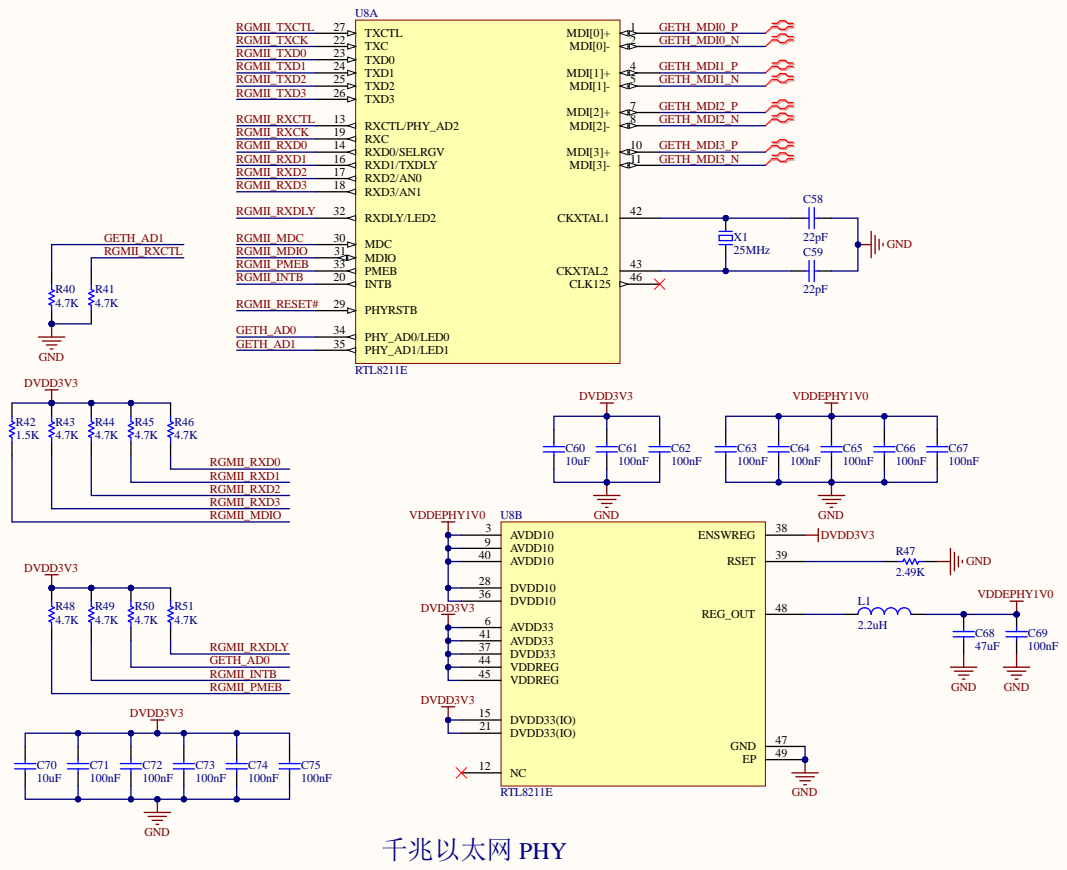
[picture p45: page 4]

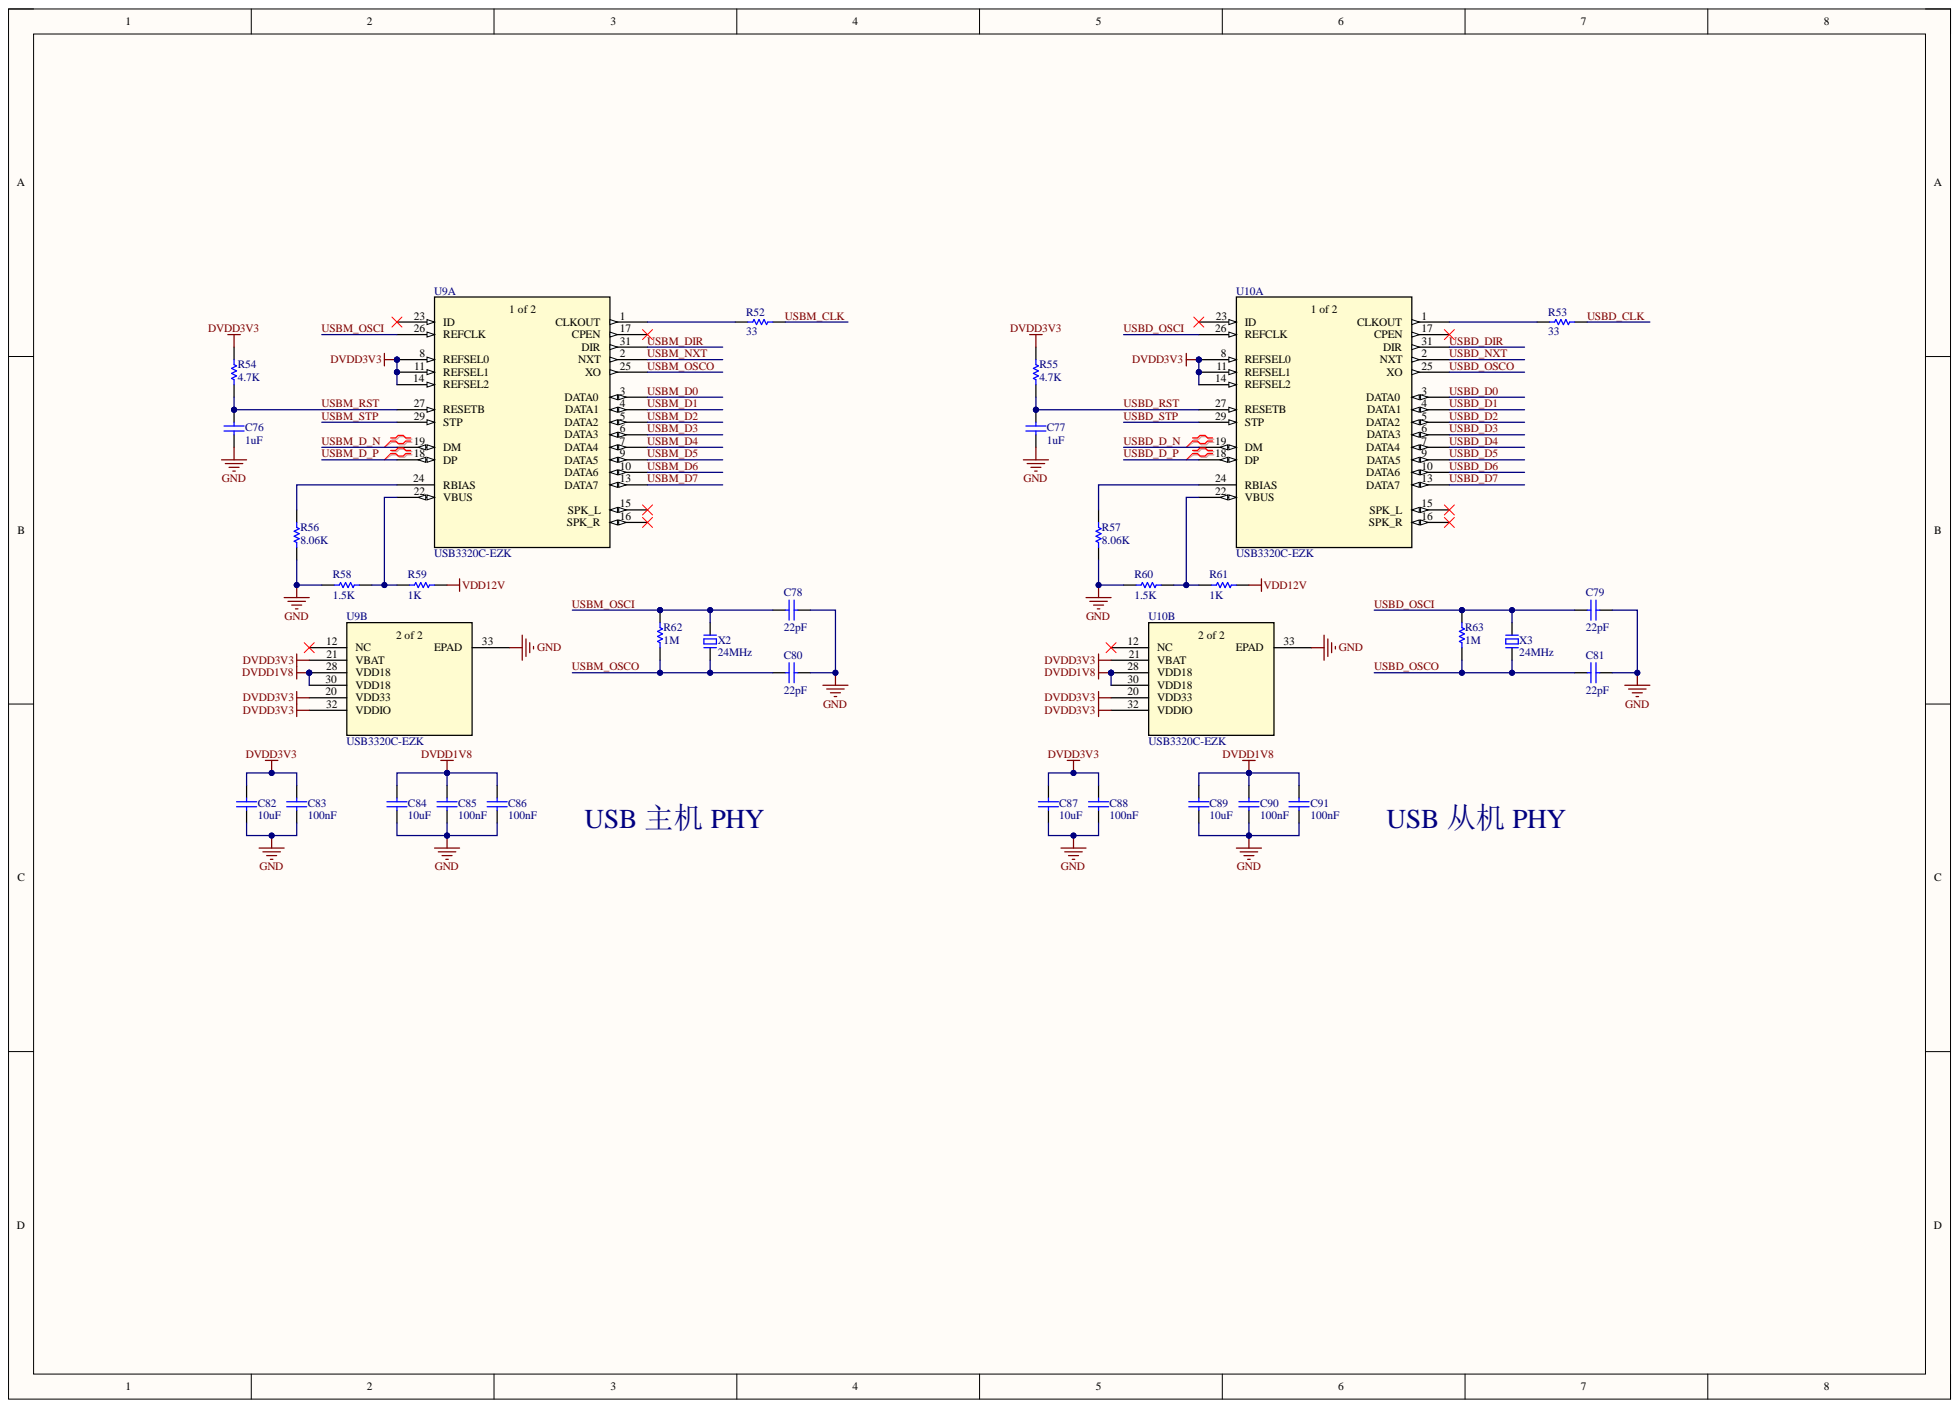
[picture p46: page 5]

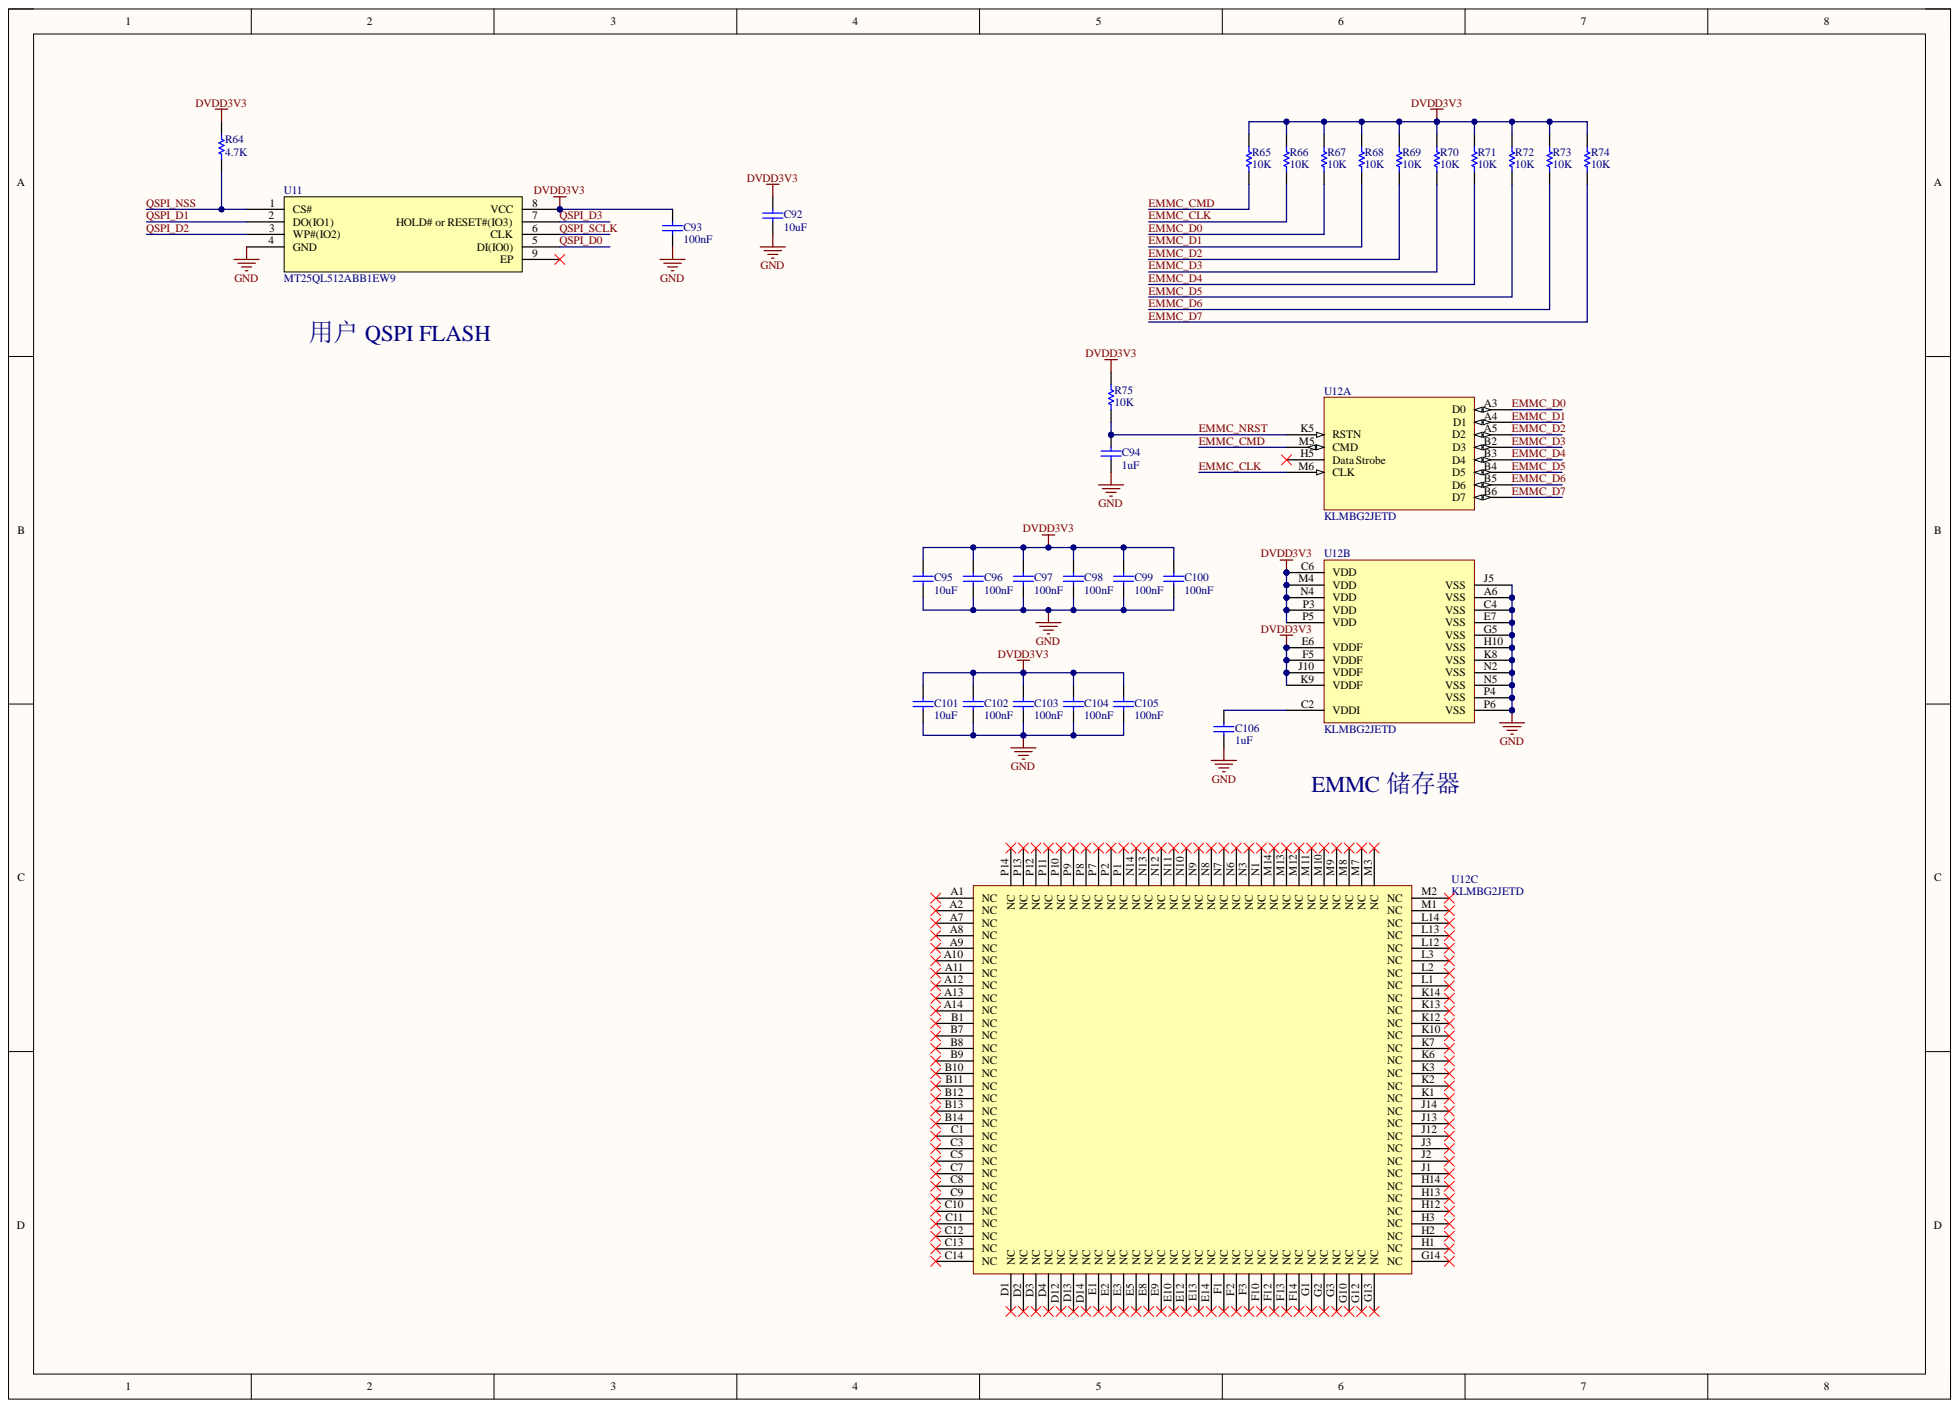
[picture p47: page 6]

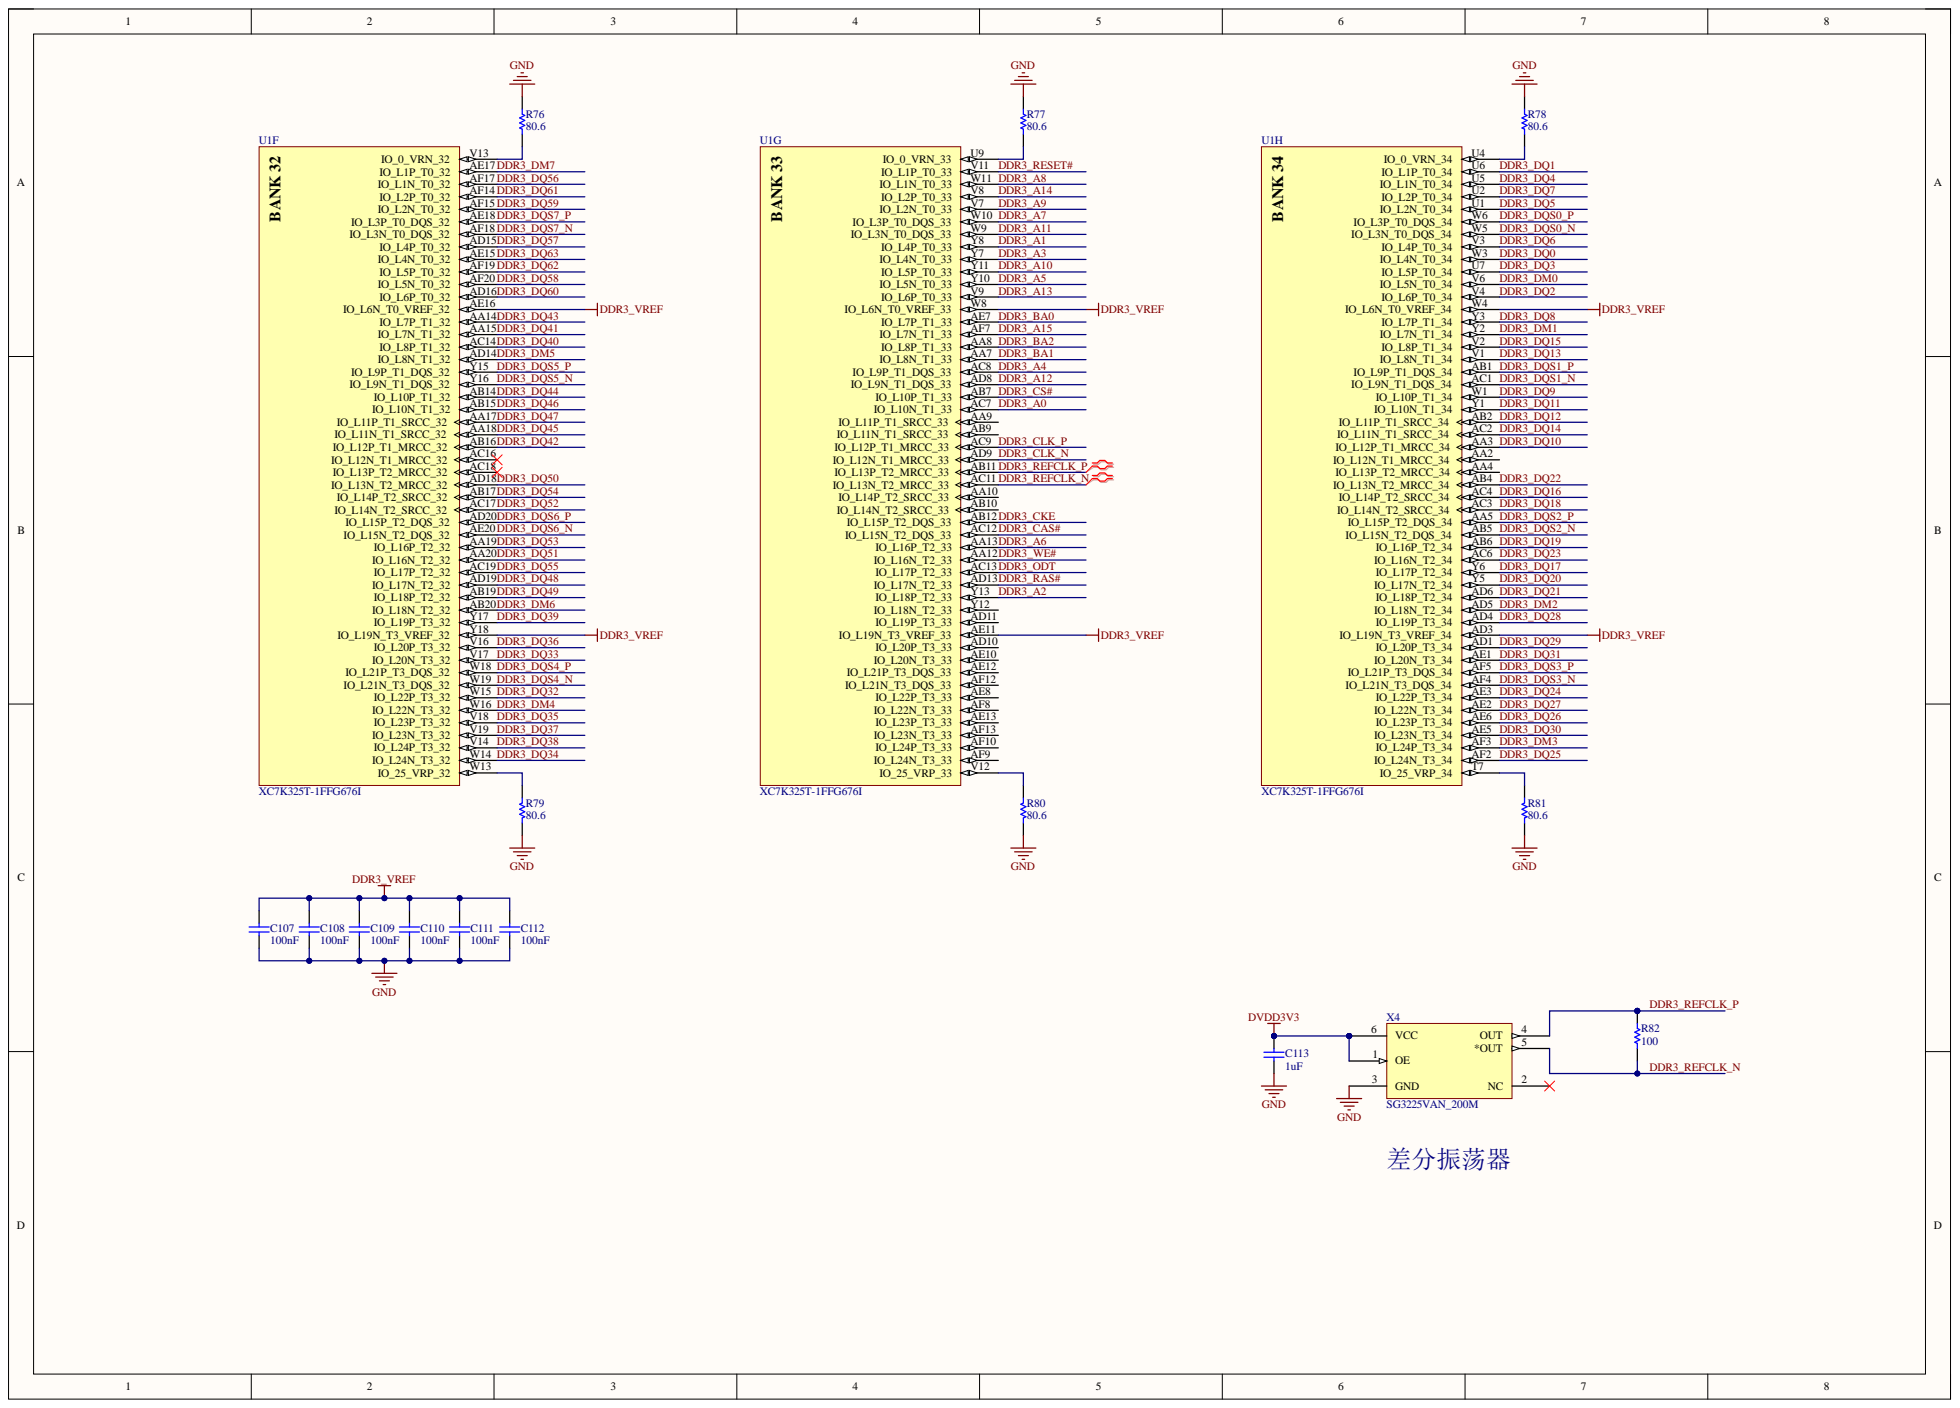
[picture p48: page 7]

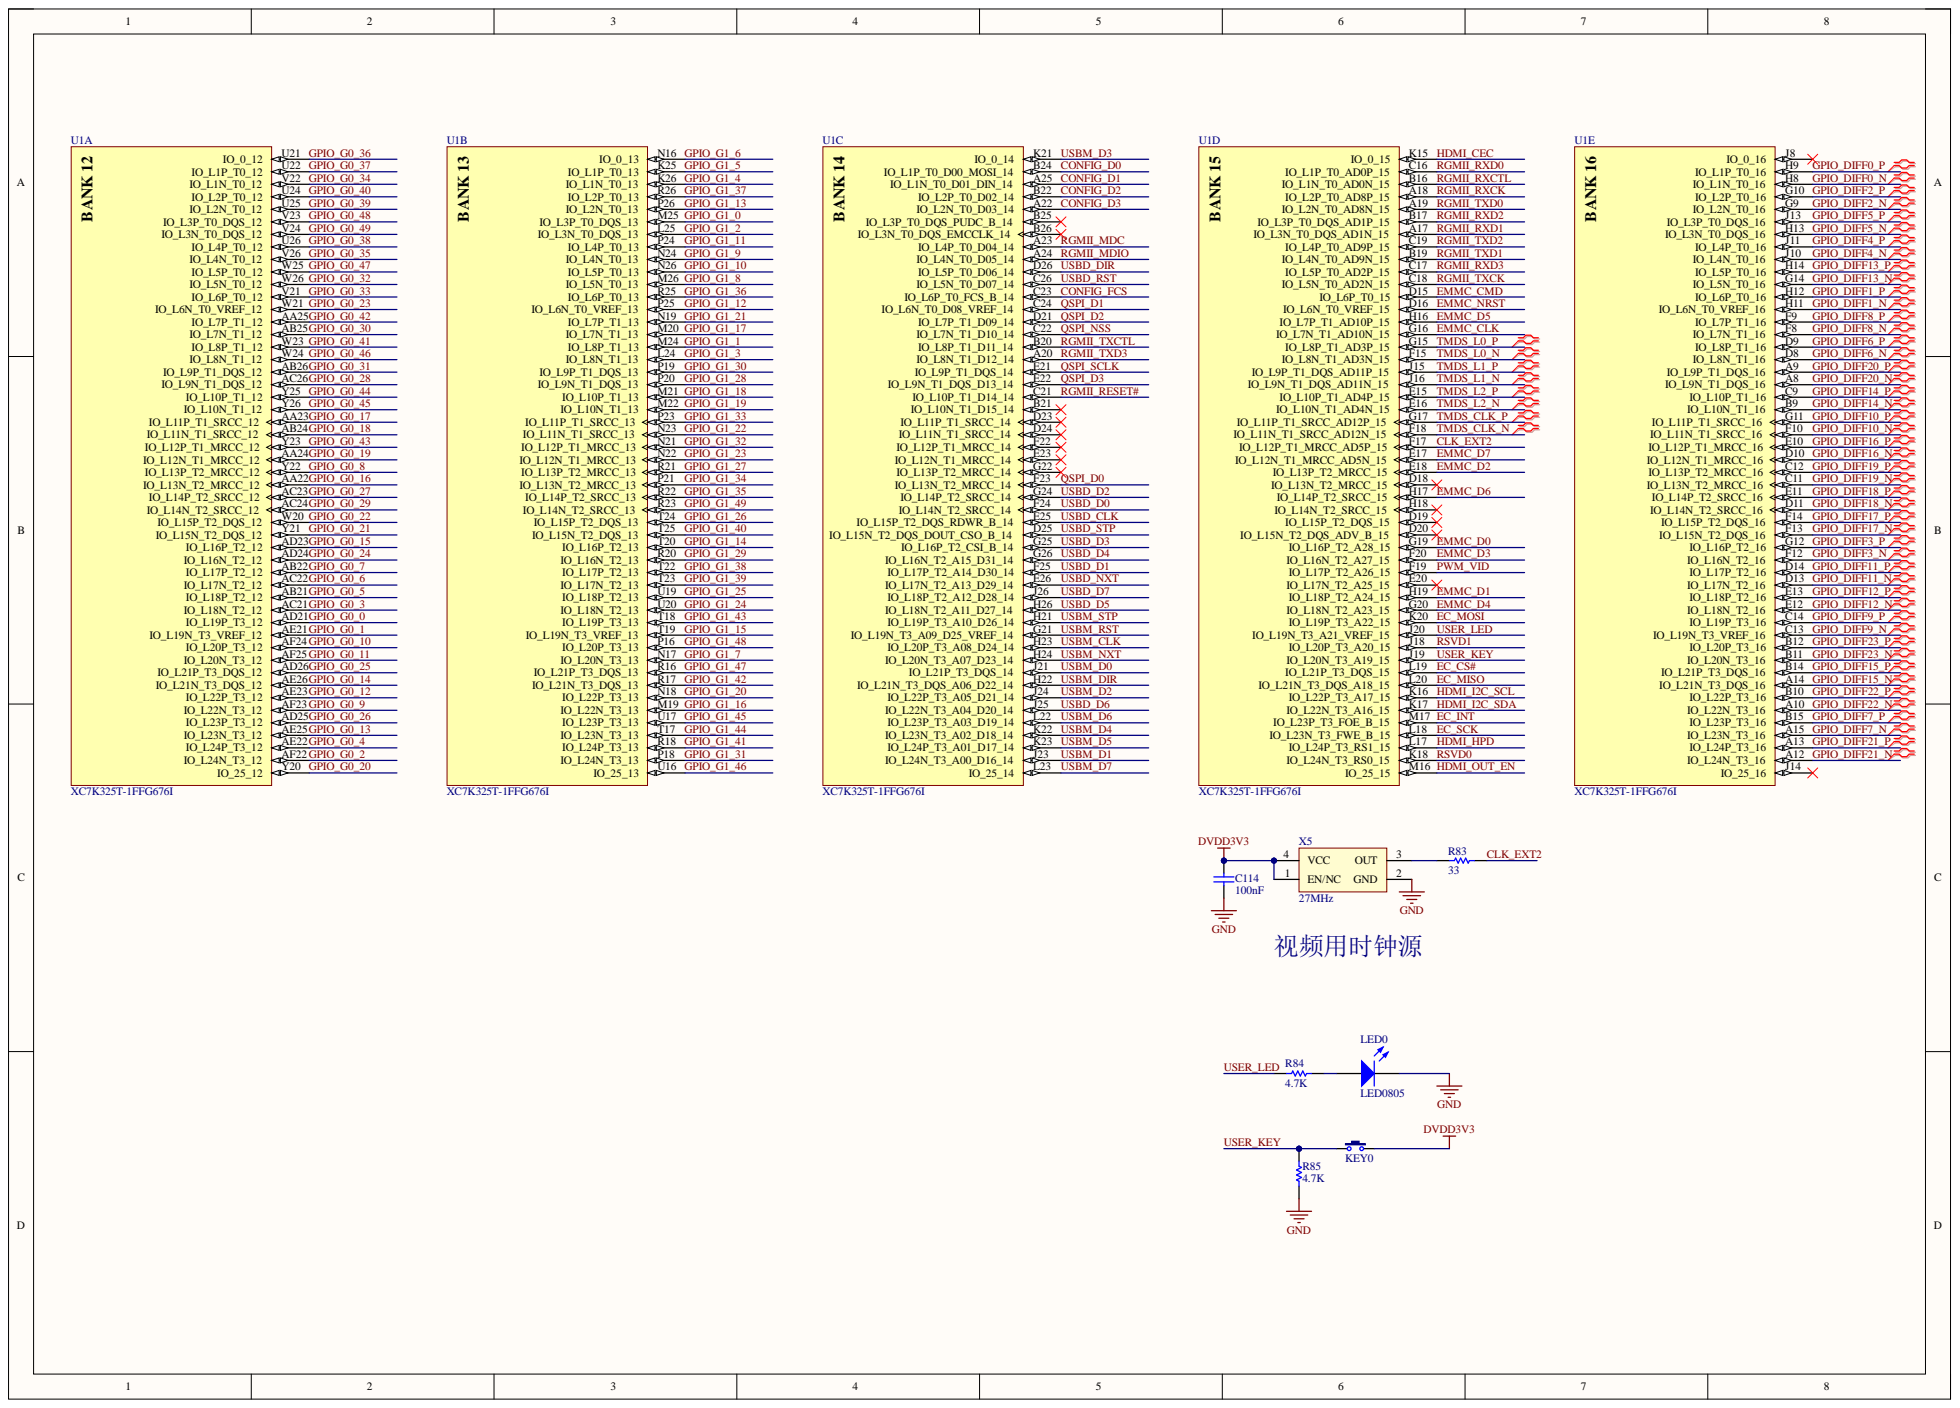
[picture p49: page 8]



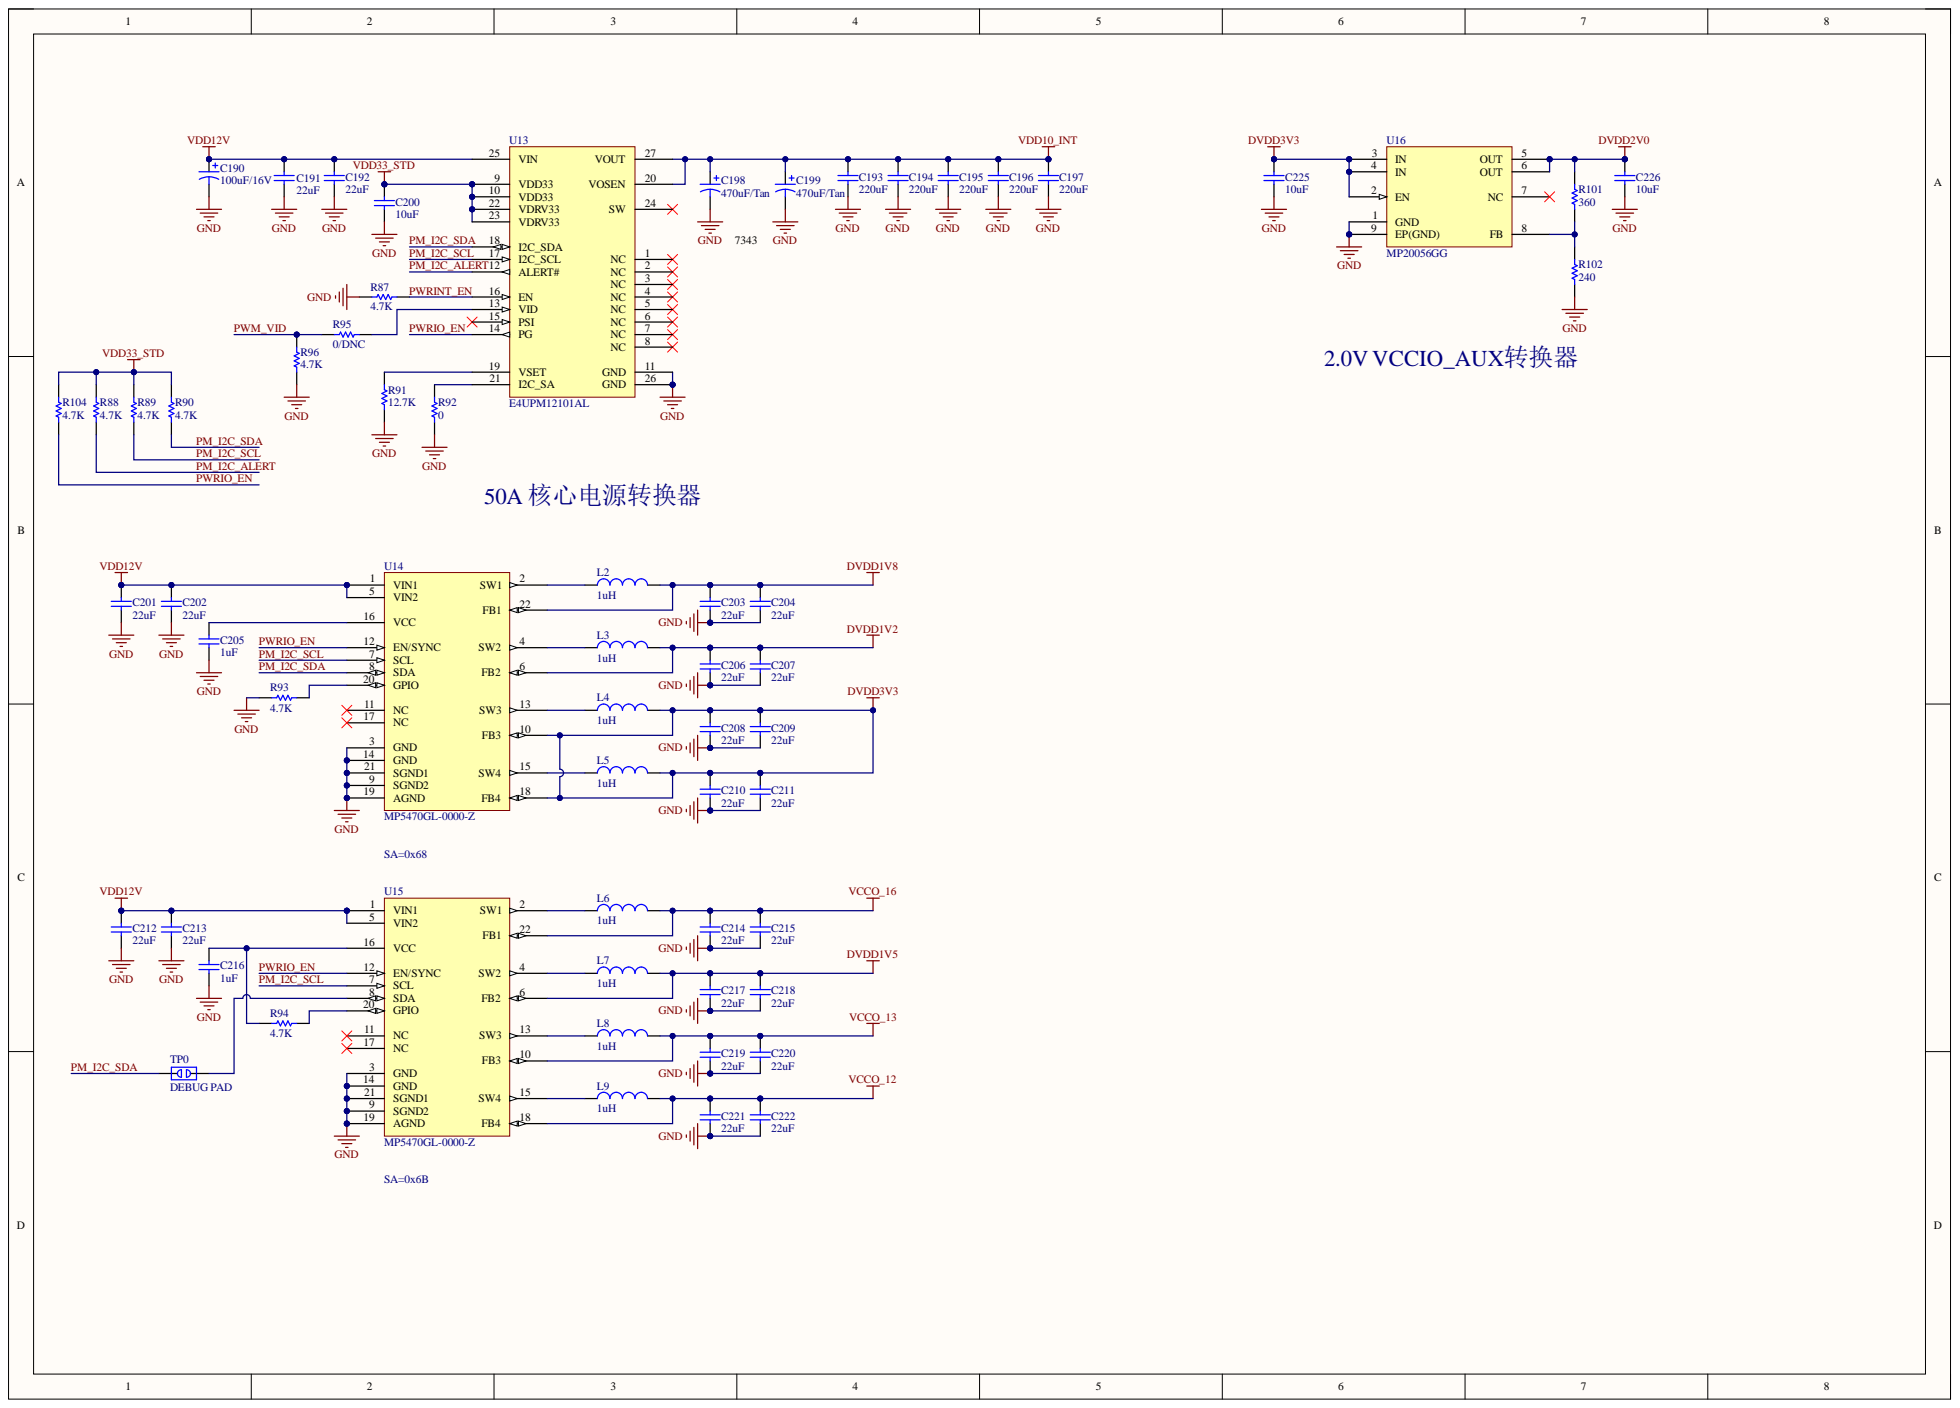
[picture p50: page 11]


GPI O_G1_23 GPI O_G1_22 GPI O_G1_21 GPI O_G1_20 GPI O_G1_19 GPI O_G1_18 GPI O_G1_17 GPI O_G1_16 | GPI O_G1_31 GPI O_G1_30 GPI O_G1_29 GPI O_G1_28 GPI O_G1_27 GPI O_G1_26 GPI O_G1_25 GPI O_G1_24
