LAB5604/fpga_board/e4fpm7k325_mmb/pinout/mmb_pinout.xdc

# This file is suitable for E4FPM7K325 MMB（MultiMediaBoard）
# Powered by LAB5604 studio 2018-2023

# SD port
set_property IOSTANDARD LVCMOS33 [get_ports sd_cd]
set_property PACKAGE_PIN Y22 [get_ports sd_cd]
set_property IOSTANDARD LVCMOS33 [get_ports {sd_d[0]}]
set_property PACKAGE_PIN AF24 [get_ports {sd_d[0]}]
set_property IOSTANDARD LVCMOS33 [get_ports {sd_d[1]}]
set_property PACKAGE_PIN AF23 [get_ports {sd_d[1]}]
set_property IOSTANDARD LVCMOS33 [get_ports {sd_d[2]}]
set_property PACKAGE_PIN AE26 [get_ports {sd_d[2]}]
set_property IOSTANDARD LVCMOS33 [get_ports {sd_d[3]}]
set_property PACKAGE_PIN AE25 [get_ports {sd_d[4]}]
set_property IOSTANDARD LVCMOS33 [get_ports sd_clk]
set_property PACKAGE_PIN AF25 [get_ports sd_clk]
set_property IOSTANDARD LVCMOS33 [get_ports sd_cmd]
set_property PACKAGE_PIN AE23 [get_ports sd_cmd]
#Audio ADC interface (I2C)
set_property IOSTANDARD LVCMOS33 [get_ports adc_rst_n]
set_property IOSTANDARD LVCMOS33 [get_ports adc_mclk]
set_property IOSTANDARD LVCMOS33 [get_ports adc_sclk]
set_property IOSTANDARD LVCMOS33 [get_ports adc_lrck]
set_property IOSTANDARD LVCMOS33 [get_ports adc_sdout]
set_property IOSTANDARD LVCMOS33 [get_ports {adc_mode[0]}]
set_property IOSTANDARD LVCMOS33 [get_ports {adc_mode[1]}]
set_property PACKAGE_PIN T25 [get_ports adc_rst_n]
set_property PACKAGE_PIN R25 [get_ports adc_mclk]
set_property PACKAGE_PIN T22 [get_ports adc_sclk]
set_property PACKAGE_PIN T23 [get_ports adc_lrck]
set_property PACKAGE_PIN R26 [get_ports adc_sdout]
set_property PACKAGE_PIN AD23 [get_ports {adc_mode[0]}]
set_property PACKAGE_PIN AB22 [get_ports {adc_mode[1]}]
#Audio DAC interface
set_property IOSTANDARD LVCMOS33 [get_ports dac_sclk]
set_property IOSTANDARD LVCMOS33 [get_ports dac_lrck]
set_property IOSTANDARD LVCMOS33 [get_ports dac_sdin]
set_property IOSTANDARD LVCMOS33 [get_ports dac_mclk]
set_property PACKAGE_PIN R22 [get_ports dac_sclk]
set_property PACKAGE_PIN P21 [get_ports dac_lrck]
set_property PACKAGE_PIN P23 [get_ports dac_sdin]
set_property PACKAGE_PIN N21 [get_ports dac_mclk]
#PS2 interface
set_property IOSTANDARD LVCMOS33 [get_ports ps2_clk_1]
set_property IOSTANDARD LVCMOS33 [get_ports ps2_clk_2]
set_property IOSTANDARD LVCMOS33 [get_ports ps2_data_1]
set_property IOSTANDARD LVCMOS33 [get_ports ps2_data_2]
set_property PACKAGE_PIN N18 [get_ports ps2_clk_1]
set_property PACKAGE_PIN N22 [get_ports ps2_clk_2]
set_property PACKAGE_PIN N19 [get_ports ps2_data_1]
set_property PACKAGE_PIN N23 [get_ports ps2_data_2]
#UART interface
set_property IOSTANDARD LVCMOS33 [get_ports uart_txd]
set_property IOSTANDARD LVCMOS33 [get_ports uart_rxd]
set_property PACKAGE_PIN K25 [get_ports uart_txd]
set_property PACKAGE_PIN N16 [get_ports uart_rxd]
#vga interface
set_property IOSTANDARD LVCMOS33 [get_ports vga_clk]
set_property IOSTANDARD LVCMOS33 [get_ports {vga_blue[0]}]
set_property IOSTANDARD LVCMOS33 [get_ports {vga_blue[1]}]
set_property IOSTANDARD LVCMOS33 [get_ports {vga_blue[2]}]
set_property IOSTANDARD LVCMOS33 [get_ports {vga_blue[3]}]
set_property IOSTANDARD LVCMOS33 [get_ports {vga_blue[4]}]
set_property IOSTANDARD LVCMOS33 [get_ports {vga_blue[5]}]
set_property IOSTANDARD LVCMOS33 [get_ports {vga_blue[6]}]
set_property IOSTANDARD LVCMOS33 [get_ports {vga_blue[7]}]
set_property IOSTANDARD LVCMOS33 [get_ports {vga_green[0]}]
set_property IOSTANDARD LVCMOS33 [get_ports {vga_green[1]}]
set_property IOSTANDARD LVCMOS33 [get_ports {vga_green[2]}]
set_property IOSTANDARD LVCMOS33 [get_ports {vga_green[3]}]
set_property IOSTANDARD LVCMOS33 [get_ports {vga_green[4]}]
set_property IOSTANDARD LVCMOS33 [get_ports {vga_green[5]}]
set_property IOSTANDARD LVCMOS33 [get_ports {vga_green[6]}]
set_property IOSTANDARD LVCMOS33 [get_ports {vga_green[7]}]
set_property IOSTANDARD LVCMOS33 [get_ports {vga_reg[0]}]
set_property IOSTANDARD LVCMOS33 [get_ports {vga_reg[1]}]
set_property IOSTANDARD LVCMOS33 [get_ports {vga_reg[2]}]
set_property IOSTANDARD LVCMOS33 [get_ports {vga_reg[3]}]
set_property IOSTANDARD LVCMOS33 [get_ports {vga_reg[4]}]
set_property IOSTANDARD LVCMOS33 [get_ports {vga_reg[5]}]
set_property IOSTANDARD LVCMOS33 [get_ports {vga_reg[6]}]
set_property IOSTANDARD LVCMOS33 [get_ports {vga_reg[7]}]
set_property IOSTANDARD LVCMOS33 [get_ports vga_sync_n]
set_property IOSTANDARD LVCMOS33 [get_ports vga_psave_n]
set_property IOSTANDARD LVCMOS33 [get_ports vga_blank_n]
set_property IOSTANDARD LVCMOS33 [get_ports vga_hs]
set_property IOSTANDARD LVCMOS33 [get_ports vga_vs]
set_property PACKAGE_PIN R23 [get_ports vga_clk]
set_property PACKAGE_PIN R18 [get_ports {vga_blue[0]}]
set_property PACKAGE_PIN R17 [get_ports {vga_blue[1]}]
set_property PACKAGE_PIN T18 [get_ports {vga_blue[2]}]
set_property PACKAGE_PIN T17 [get_ports {vga_blue[3]}]
set_property PACKAGE_PIN U17 [get_ports {vga_blue[4]}]
set_property PACKAGE_PIN U16 [get_ports {vga_blue[5]}]
set_property PACKAGE_PIN R16 [get_ports {vga_blue[6]}]
set_property PACKAGE_PIN P16 [get_ports {vga_blue[7]}]
set_property PACKAGE_PIN U20 [get_ports {vga_green[0]}]
set_property PACKAGE_PIN U19 [get_ports {vga_green[1]}]
set_property PACKAGE_PIN T24 [get_ports {vga_green[2]}]
set_property PACKAGE_PIN R21 [get_ports {vga_green[3]}]
set_property PACKAGE_PIN P20 [get_ports {vga_green[4]}]
set_property PACKAGE_PIN R20 [get_ports {vga_green[5]}]
set_property PACKAGE_PIN P19 [get_ports {vga_green[6]}]
set_property PACKAGE_PIN P18 [get_ports {vga_green[7]}]
set_property PACKAGE_PIN M26 [get_ports {vga_red[0]}]
set_property PACKAGE_PIN N24 [get_ports {vga_red[1]}]
set_property PACKAGE_PIN N26 [get_ports {vga_red[2]}]
set_property PACKAGE_PIN P24 [get_ports {vga_red[3]}]
set_property PACKAGE_PIN P25 [get_ports {vga_red[4]}]
set_property PACKAGE_PIN P26 [get_ports {vga_red[5]}]
set_property PACKAGE_PIN T20 [get_ports {vga_red[6]}]
set_property PACKAGE_PIN T19 [get_ports {vga_red[7]}]
set_property PACKAGE_PIN K26 [get_ports vga_sync_n]
set_property PACKAGE_PIN L24 [get_ports vga_psave_n]
set_property PACKAGE_PIN L25 [get_ports vga_blank_n]
set_property PACKAGE_PIN M24 [get_ports vga_hs]
set_property PACKAGE_PIN M25 [get_ports vga_vs]
#User Key
set_property IOSTANDARD LVCMOS33 [get_ports {key[0]}]
set_property IOSTANDARD LVCMOS33 [get_ports {key[1]}]
set_property IOSTANDARD LVCMOS33 [get_ports {key[2]}]
set_property IOSTANDARD LVCMOS33 [get_ports {key[3]}]
set_property IOSTANDARD LVCMOS33 [get_ports {key[4]}]
set_property IOSTANDARD LVCMOS33 [get_ports {key[5]}]
set_property IOSTANDARD LVCMOS33 [get_ports {key[6]}]
set_property IOSTANDARD LVCMOS33 [get_ports {key[7]}]
set_property PACKAGE_PIN G9 [get_ports {key[0]}]
set_property PACKAGE_PIN G10 [get_ports {key[1]}]
set_property PACKAGE_PIN H8 [get_ports {key[2]}]
set_property PACKAGE_PIN H9 [get_ports {key[3]}]
set_property PACKAGE_PIN F12 [get_ports {key[4]}]
set_property PACKAGE_PIN G12 [get_ports {key[5]}]
set_property PACKAGE_PIN H11 [get_ports {key[6]}]
set_property PACKAGE_PIN H12 [get_ports {key[7]}]
#user button
set_property IOSTANDARD LVCMOS33 [get_ports {but[0]}]
set_property IOSTANDARD LVCMOS33 [get_ports {but[1]}]
set_property IOSTANDARD LVCMOS33 [get_ports {but[2]}]
set_property IOSTANDARD LVCMOS33 [get_ports {but[3]}]
set_property IOSTANDARD LVCMOS33 [get_ports {but[4]}]
set_property IOSTANDARD LVCMOS33 [get_ports {but[5]}]
set_property IOSTANDARD LVCMOS33 [get_ports {but[6]}]
set_property IOSTANDARD LVCMOS33 [get_ports {but[7]}]
set_property PACKAGE_PIN H13 [get_ports {but[0]}]
set_property PACKAGE_PIN J10 [get_ports {but[1]}]
set_property PACKAGE_PIN A15 [get_ports {but[2]}]
set_property PACKAGE_PIN D8 [get_ports {but[3]}]
set_property PACKAGE_PIN J13 [get_ports {but[4]}]
set_property PACKAGE_PIN J11 [get_ports {but[5]}]
set_property PACKAGE_PIN B15 [get_ports {but[6]}]
set_property PACKAGE_PIN D9 [get_ports {but[7]}]
#user led
set_property IOSTANDARD LVCMOS33 [get_ports {led[0]}]
set_property IOSTANDARD LVCMOS33 [get_ports {led[1]}]
set_property IOSTANDARD LVCMOS33 [get_ports {led[2]}]
set_property IOSTANDARD LVCMOS33 [get_ports {led[3]}]
set_property IOSTANDARD LVCMOS33 [get_ports {led[4]}]
set_property IOSTANDARD LVCMOS33 [get_ports {led[5]}]
set_property IOSTANDARD LVCMOS33 [get_ports {led[6]}]
set_property IOSTANDARD LVCMOS33 [get_ports {led[7]}]
set_property PACKAGE_PIN F9 [get_ports {led[0]}]
set_property PACKAGE_PIN F8 [get_ports {led[1]}]
set_property PACKAGE_PIN C14 [get_ports {led[2]}]
set_property PACKAGE_PIN C13 [get_ports {led[3]}]
set_property PACKAGE_PIN D13 [get_ports {led[4]}]
set_property PACKAGE_PIN D14 [get_ports {led[5]}]
set_property PACKAGE_PIN F10 [get_ports {led[6]}]
set_property PACKAGE_PIN G11 [get_ports {led[7]}]
#7-segment display(running in scan mode)
set_property IOSTANDARD LVCMOS33 [get_ports seg_a]
set_property IOSTANDARD LVCMOS33 [get_ports seg_b]
set_property IOSTANDARD LVCMOS33 [get_ports seg_c]
set_property IOSTANDARD LVCMOS33 [get_ports seg_d]
set_property IOSTANDARD LVCMOS33 [get_ports seg_e]
set_property IOSTANDARD LVCMOS33 [get_ports seg_f]
set_property IOSTANDARD LVCMOS33 [get_ports seg_g]
set_property IOSTANDARD LVCMOS33 [get_ports seg_dp]
set_property IOSTANDARD LVCMOS33 [get_ports {seg_sel[0]}]
set_property IOSTANDARD LVCMOS33 [get_ports {seg_sel[1]}]
set_property IOSTANDARD LVCMOS33 [get_ports {seg_sel[2]}]
set_property IOSTANDARD LVCMOS33 [get_ports {seg_sel[3]}]
set_property PACKAGE_PIN H14 [get_ports seg_a]
set_property PACKAGE_PIN C9 [get_ports seg_b]
set_property PACKAGE_PIN E13 [get_ports seg_c]
set_property PACKAGE_PIN B14 [get_ports seg_d]
set_property PACKAGE_PIN B9 [get_ports seg_e]
set_property PACKAGE_PIN G14 [get_ports seg_f]
set_property PACKAGE_PIN E12 [get_ports seg_g]
set_property PACKAGE_PIN A14 [get_ports seg_dp]
set_property PACKAGE_PIN E10 [get_ports {seg_sel[0]}]
set_property PACKAGE_PIN D10 [get_ports {seg_sel[1]}]
set_property PACKAGE_PIN F14 [get_ports {seg_sel[2]}]
set_property PACKAGE_PIN F13 [get_ports {seg_sel[3]}]
#clock generator control(on board CDCM61002)
set_property IOSTANDARD LVCMOS33 [get_ports {clkgen_pr[0]}]
set_property IOSTANDARD LVCMOS33 [get_ports {clkgen_pr[1]}]
set_property IOSTANDARD LVCMOS33 [get_ports {clkgen_os[0]}]
set_property IOSTANDARD LVCMOS33 [get_ports {clkgen_os[1]}]
set_property IOSTANDARD LVCMOS33 [get_ports {clkgen_od[0]}]
set_property IOSTANDARD LVCMOS33 [get_ports {clkgen_od[1]}]
set_property IOSTANDARD LVCMOS33 [get_ports {clkgen_od[2]}]
set_property PACKAGE_PIN AD21 [get_ports {clkgen_pr[0]}]
set_property PACKAGE_PIN AE21 [get_ports {clkgen_pr[1]}]
set_property PACKAGE_PIN AB21 [get_ports {clkgen_os[0]}]
set_property PACKAGE_PIN AC22 [get_ports {clkgen_os[1]}]
set_property PACKAGE_PIN AF22 [get_ports {clkgen_od[0]}]
set_property PACKAGE_PIN AC21 [get_ports {clkgen_od[1]}]
set_property PACKAGE_PIN AE22 [get_ports {clkgen_od[2]}]

###########################################################
#              On SoM PINs                                #
###########################################################
#RGMII interface (RTL8211e)
set_property IOSTANDARD LVCMOS33 [get_ports rgmii_reset_n]
set_property IOSTANDARD LVCMOS33 [get_ports rgmii_mdio]
set_property IOSTANDARD LVCMOS33 [get_ports rgmii_mdc]
set_property IOSTANDARD LVCMOS33 [get_ports {rgmii_rxd[0]}]
set_property IOSTANDARD LVCMOS33 [get_ports {rgmii_rxd[1]}]
set_property IOSTANDARD LVCMOS33 [get_ports {rgmii_rxd[2]}]
set_property IOSTANDARD LVCMOS33 [get_ports {rgmii_rxd[3]}]
set_property IOSTANDARD LVCMOS33 [get_ports {rgmii_txd[0]}]
set_property IOSTANDARD LVCMOS33 [get_ports {rgmii_txd[1]}]
set_property IOSTANDARD LVCMOS33 [get_ports {rgmii_txd[2]}]
set_property IOSTANDARD LVCMOS33 [get_ports {rgmii_txd[3]}]
set_property IOSTANDARD LVCMOS33 [get_ports rgmii_rxck]
set_property IOSTANDARD LVCMOS33 [get_ports rgmii_rxctl]
set_property IOSTANDARD LVCMOS33 [get_ports rgmii_txck]
set_property IOSTANDARD LVCMOS33 [get_ports rgmii_txctl]
set_property PACKAGE_PIN C21 [get_ports rgmii_reset_n]
set_property PACKAGE_PIN A24 [get_ports rgmii_mdio]
set_property PACKAGE_PIN A23 [get_ports rgmii_mdc]
set_property PACKAGE_PIN C16 [get_ports {rgmii_rxd[0]}]
set_property PACKAGE_PIN A17 [get_ports {rgmii_rxd[1]}]
set_property PACKAGE_PIN B17 [get_ports {rgmii_rxd[2]}]
set_property PACKAGE_PIN C17 [get_ports {rgmii_rxd[3]}]
set_property PACKAGE_PIN A19 [get_ports {rgmii_txd[0]}]
set_property PACKAGE_PIN B19 [get_ports {rgmii_txd[1]}]
set_property PACKAGE_PIN C19 [get_ports {rgmii_txd[2]}]
set_property PACKAGE_PIN A20 [get_ports {rgmii_txd[3]}]
set_property PACKAGE_PIN A18 [get_ports rgmii_rxck]
set_property PACKAGE_PIN B16 [get_ports rgmii_rxctl]
set_property PACKAGE_PIN C18 [get_ports rgmii_txck]
set_property PACKAGE_PIN B20 [get_ports rgmii_txctl]
#external 27MHz OSC for general use (typical for viedo)
set_property IOSTANDARD LVCMOS33 [get_ports ext_clk_27m]
set_property PACKAGE_PIN F17 [get_ports ext_clk_27m]
create_clock -period 37 [get_ports ext_clk_27m]
#200Mhz referce clock (for DDR use)
set_property IOSTANDARD LVDS [get_ports refclk_200m_p]
set_property IOSTANDARD LVDS [get_ports refclk_200m_n]
set_property PACKAGE_PIN AB11 [get_ports refclk_200m_p]
set_property PACKAGE_PIN AC11 [get_ports refclk_200m_n]
create_clock -period 5 [get_ports refclk_200m_p]
#qspi flash(xx25 series NOR flash)
set_property IOSTANDARD LVCMOS33 [get_ports qspi_cs_n]
set_property IOSTANDARD LVCMOS33 [get_ports {qspi_dq[0]}]
set_property IOSTANDARD LVCMOS33 [get_ports {qspi_dq[1]}]
set_property IOSTANDARD LVCMOS33 [get_ports {qspi_dq[2]}]
set_property IOSTANDARD LVCMOS33 [get_ports {qspi_dq[3]}]
set_property IOSTANDARD LVCMOS33 [get_ports qspi_sclk]
set_property PACKAGE_PIN C22 [get_ports qspi_cs_n]
set_property PACKAGE_PIN F23 [get_ports {qspi_dq[0]}]
set_property PACKAGE_PIN C24 [get_ports {qspi_dq[1]}]
set_property PACKAGE_PIN D21 [get_ports {qspi_dq[2]}]
set_property PACKAGE_PIN E22 [get_ports {qspi_dq[3]}]
set_property PACKAGE_PIN E21 [get_ports qspi_sclk]
#on board emmc
set_property IOSTANDARD LVCMOS33 [get_ports emmc_cmd]
set_property IOSTANDARD LVCMOS33 [get_ports {emmc_dq[0]}]
set_property IOSTANDARD LVCMOS33 [get_ports {emmc_dq[1]}]
set_property IOSTANDARD LVCMOS33 [get_ports {emmc_dq[2]}]
set_property IOSTANDARD LVCMOS33 [get_ports {emmc_dq[3]}]
set_property IOSTANDARD LVCMOS33 [get_ports {emmc_dq[4]}]
set_property IOSTANDARD LVCMOS33 [get_ports {emmc_dq[5]}]
set_property IOSTANDARD LVCMOS33 [get_ports {emmc_dq[6]}]
set_property IOSTANDARD LVCMOS33 [get_ports {emmc_dq[7]}]
set_property IOSTANDARD LVCMOS33 [get_ports emmc_clk]
set_property IOSTANDARD LVCMOS33 [get_ports emmc_rst_n]
set_property PACKAGE_PIN D15 [get_ports emmc_cmd]
set_property PACKAGE_PIN G19 [get_ports {emmc_dq[0]}]
set_property PACKAGE_PIN H19 [get_ports {emmc_dq[1]}]
set_property PACKAGE_PIN E18 [get_ports {emmc_dq[2]}]
set_property PACKAGE_PIN F20 [get_ports {emmc_dq[3]}]
set_property PACKAGE_PIN G20 [get_ports {emmc_dq[4]}]
set_property PACKAGE_PIN H16 [get_ports {emmc_dq[5]}]
set_property PACKAGE_PIN H17 [get_ports {emmc_dq[6]}]
set_property PACKAGE_PIN E17 [get_ports {emmc_dq[7]}]
set_property PACKAGE_PIN G16 [get_ports emmc_clk]
set_property PACKAGE_PIN D16 [get_ports emmc_rst_n]
#on som keys
set_property IOSTANDARD LVCMOS33 [get_ports som_led]
set_property IOSTANDARD LVCMOS33 [get_ports som_key]
set_property PACKAGE_PIN J20 [get_ports som_led]
set_property PACKAGE_PIN J19 [get_ports som_key]
